NaoPross/SAMSpectrumAnalyzer/doc/tex/hardware.tex

\chapter{Hardware}
\section{Schema a blocchi}

\begin{figure}[H] \centering \rmfamily
    
    \caption{Schema a blocchi}
\end{figure}

\section{Selezione delle entrate}
Essendo richiesta dai requisiti la possibilit\`a di selezione tra 3 entrate,
\`e stato utilizzando un semplice multiplexer controllato direttamente dal
microcontroller. Per la sua semplicit\`a non sono necessari particolari
osservazioni.

\begin{figure}[H] \centering
    
    \caption{Circuito di selezione delle entrate \label{fig:input-selection-v2}}
\end{figure}

Tutte le entrate dispongono di un condensatore di disaccoppiamento, seguito da
un partitore di tensione simmetrico per aggiungere un offset pari a met\`a
dell'alimentazione. Il valore delle resistenze di 20\,k\(\Omega\) \`e scelto
per avere un impedenza rispetto al connettore uguale all'impedenza
caratteristica dei cavi audio di 10\,k\(\Omega\).

\section{Circuito di entrata}
Il segnale di cui si analizza lo spettro, prima di essere campionato, viene
adattato mediate un circuito di amplificazione e filtraggio. Esso \`e
necessario per due ragioni. Il circuito di amplificazione \`e presente per
poter regolare il guadagno nel caso in cui si dovesse avere in entrata un
segnale di ampiezza molto piccola. Il secondo circuito invece, di filtraggio,
\`e necessario per rimuovere disturbi di alta frequenza che potrebbero
introdurre disturbi nel campionamento. Questa \`e una tipica configurazione
prima di un circuito di conversione AD (analogico - digitale), ed \`e
conosciuto anche come circuito di filtraggio \emph{anti-alias}.

\begin{figure}[H] \centering
    
    \caption[Circuito di adattamento del segnale]{
        Circuito di adattamento del segnale in entrata.
        \label{fig:filter-ampl-v2}
    }
\end{figure}

\`E importante notare che per questa applicazione si \`e scelto utilizzare
degli opamp \emph{rail to rail}, che hanno una tensione di saturazione vicina
a quella di alimentazione. Essi sono necessari per poter raggiungere tensioni
vicino allo 0\,V, che non sarebbero possibili con un opamp normale siccome
l'alimentazione del circuito \`e asimmetrica tra 0 e 12\,V.

\paragraph{Amplificatore.} Come si pu\`o notare a sinistra nella figura
\ref{fig:filter-ampl-v1}, il circuito di amplificazione non ha una configurazione
tipica. Esso \`e basato su una configurazione non invertente ma dispone di un
consensatore (C11) che modifica la retroazione in modo da reagire unicamente
alla componente AC del segnale. Questo permette di amplificare la componente
alternata ignorando l'offset del segnale, perci\`o di \emph{non} utilizzare
un'alimentazione simmetrica \(\pm\)5\,V.

L'amplificazione di questo amplificatore \`e comunque data dal rapporto
\(1+R_{14}/R_{13}\) che permette un un guadagno fino a 6 oppure 15,5\,dB.

\paragraph{Filtro.} A destra della figura \ref{fig:filter-ampl-v1} vi \`e il
circuito di filtraggio, realizzato utilizzando un tipico filtro passa basso
attivo di primo ordine. Esso \`e dimensionato con una frequenza di taglio di
10\,kHz poich\`e quest'ultimo \`e il limite di Nyquist, conosciuto anche dal
teorema di Shannon, il quale stata che la frequenza di campionamento deve
essere almeno doppia della frequenza dell'armonica di frequenza maggiore.

\section{Microcontroller}
Per questa applicazione \`e stato deciso di utilizzare il microcontroller a 8
bit di Microchip PIC18F45K22, principalmente per la sua frequenza di lavoro.
Questo PIC senza oscillatori esterni dispone di un clock a 16\,MHz che grazie
ad un PLL interno pu\`o essere aumentato fino a ad un massimo di 64\,MHz.

Inoltre questo microcontroller dispone di un moltiplicatore hardware 8x8 che
impiega un solo ciclo, risparmiando la difficolt\`a di dover ottimizzare le
computazioni della Fast Fourier Tranform.

Un ultima ragione importante per la scelta di questo componente \`e data dalla
disponibilit\`a di una libreria per controllare il la matrice LED, utilizzata
per la visualizzazione, adattata da Arduino da P. Randjelovic in un LPI
precedente.

In allegato \`e presente una pagina riassuntiva dal datasheet.

\begin{table}[H] \centering
    \caption{Sommario della configurazione utilizzata}
    \begin{tabularx}{\textwidth}{l l X}
        \toprule
        \bfseries Componente utilizzato & \bfseries Valore & \bfseries Osservazioni \\
        \midrule
        Oscillatore Interno & 16\,MHz & 
            Questa \emph{non} \`e la frequenza di lavoro \\
        %
        PLL & \(\times\)4 & 
            La frequenza di lavoro \`e di 16\(\times\)4\,MHz = 64\,MHz \\
        %
        ADC & \ttfamily ANSA0 &
            Utilizzato per il campionamento \\
        %
        I/O ports & \ttfamily A, B, C, D & \\
        %
        Timer 2 & Vedi \S\ref{sec:sampling} & Utilizzato per il campionamento \\
        %
        I/O interrupts & \ttfamily INT0 (RB0) &
            Utilizzato per la selezione del canale \\
        %
        EUSART 1 & & 
            Utilizzato per trasferire i campioni della FFT. \\
        %
        EUSART 2 & &
            Porta di debugging \\
        \bottomrule
    \end{tabularx}
\end{table}

\begin{table}[H] \centering
    \caption{Configurazione della porta seriale}
    \begin{tabular}{l r l}
        \toprule
        Baudrate & 57.6 & kbps \\
        Data size & 8 & bits \\
        Stop bits & 1 & -- \\
        Flow control & off & -- \\
        \bottomrule
    \end{tabular}
\end{table}

% \section{Visualizzazione}

\section{Schemi originali}
Dopo la realizzazione del primo prototipo, gli schemi sono stati revisionati,
apportando delle correzioni. In questa sezione sono presenti gli schemi
originali utilizzati per produrre il (primo) prototipo.
\begin{figure}[H] \centering
    
    \caption{
        Circuito di selezione delle entrate (prima versione)
        \label{fig:input-selection-v1}
    }
\end{figure}
% Il filtro essendo non invertente ha un rapporto di amplificazione dato
% da \(1+R_{12}/R_{11}\). Nella figura \ref{fig:filter-ampl-v1} il valore della
% resistenza \(R_{11}\) \`e \textbf{incorretto} (Vedi sezione
% \ref{sec:err-filter}). Dopo la correzzione (\(R_{11} \geq
% 750\,\textrm{k}\Omega\)) il filtro ha un amplificazione approssimativamente
% unitaria (\(\approx 1.02\)).
\begin{figure}[H] \centering
    
    \caption[Circuito di adattamento del segnale]{
        Circuito di adattamento del segnale in entrata (prima versione)
        \label{fig:filter-ampl-v1}
    }
\end{figure}
