NaoPross/SAMSpectrumAnalyzer/doc/spectrum-analyzer.pdf

# Anno scolastico 2017-18 Lavoro Professionale Individuale

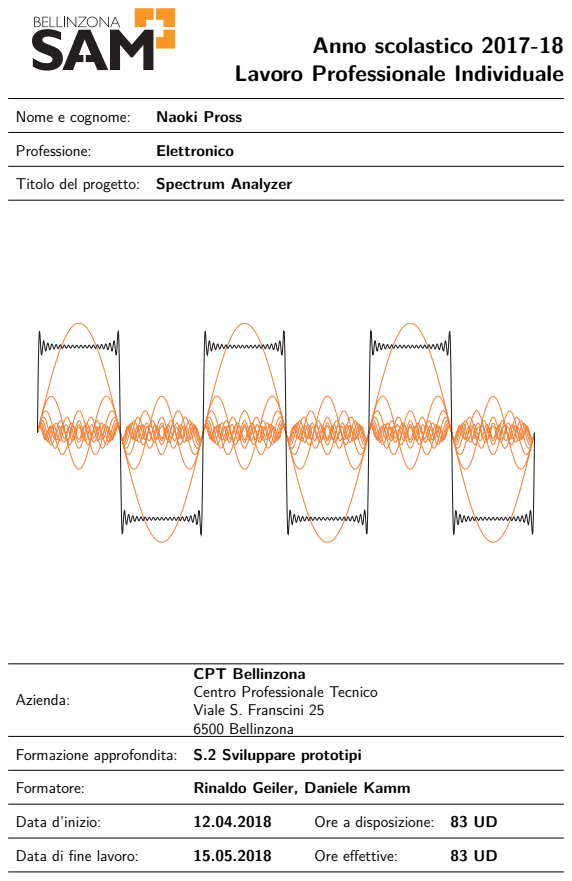
[picture p5: page 1]
Nome e cognome:; Naoki Pross; Professione:; Elettronico; Azienda:; Formatore:; Rinaldo Geiler, Daniele Kamm; Data d’inizio:; Ore a disposizione: 83 UD; Data di fine lavoro:; Ore effettive:

Titolo del progetto: Spectrum Analyzer

CPT Bellinzona
Centro Professionale Tecnico
Viale S. Franscini 25
6500 Bellinzona

Formazione approfondita: S.2 Sviluppare prototipi

Abstract

Per completare un percorso formativo alla SAM è richiesto lo sviluppo di un progetto. Questa documentazione descrive e documenta lo sviluppo di un prototipo di un circuito di analisi spettrale a 3 entrate: 2 jack ed un Cinc/RCA, in grado di offrire uno spettro fino a 10 kHz. Realizzato intorno ad un PIC18F45K22 con l’utilizzo dell’algoritmo della Fast Fourier Transform (FFT), è possibile osservare i valori complessi dello spettro mediante la porta seriale RS232 oppure utilizzando il software sviluppato in C++ per Windows e Linux (probabilmente è possibile compilarlo anche sotto MacOS).
Il progetto si è concluso con lo sviluppo di un primo design per un PCB, funzionante, ed uno schema elettrico revisionato.

CAM-SAM | Elettronico | 28 maggio 2018

# Indice

1 Introduzione | 3
2 Hardware | 5
3 Software | 9
4 Conclusioni | 15
5 Trasformata di Fourier | 19
spectrum-analyzer.tex | Naoki Pross | 1

Allegati | 29
spectrum-analyzer.tex | Naoki Pross | 2

# 1 Introduzione

## 1.1 Contesto

Per portare a termine il percorso formativo per un attestato di capacità federale presso la Scuola Arti e Mestieri di Bellinzona è richiesto lo sviluppo individuale di un progetto di produzione di un prodotto. Per interesse personale nella matematica della trasformata di Fourier mi è stato assegnato di sviluppare un analizzatore spettrale.

## 1.2 Requisiti

È richiesto di sviluppare circuito per analizzare lo spettro dei segnali di frequenza fino a 10 kHz. Il dispositivo dovrà avere 3 possibili sorgenti: RCA/Cinch e 2 Audio Jack per un microfono e per una sorgente di audio generica. È inoltre richiesto che il calcolo dei dati dello spettrogramma sia eseguito da un microcontroller della Microchip, collegato a due altri dispositivi quali, un display e ad un computer in RS232, per poter visualizzare lo spettrogramma computato.

## 1.3 Concetti matematici

Il circuito realizzato si appoggia sul concetto matematico di importanza fondamentale, nelle discipline come la fisica e l’elettrotecnica della Trasformata di Fourier. Questa operazione matematica è fondata su un principio dimostrato da Joseph Fourier che asserisce che è possibile rappresentare una qualsiasi funzione periodica, in alcuni casi anche non periodica, con una serie di sinusoidi di frequenze multiple ad una di base. L’operazione di Trasformata dunque è uno strumento per osservare le frequenze di queste armoniche, esso trasforma una funzione in funzione del tempo f(t) in una funzione rispetto alla frequenza o alla pulsazione ˆf(ω), che restituisce ad ogni ω l’ampiezza e la fase dell’armonica.

Secondariamente, il progetto usufruisce anche di un altro strumento chiamato Fast Fourier Transform (FFT) scoperto inizialmente nel 1965 dai matematici J. Cooley e J. Tukey. La FFT è un algoritmo con molte implementazioni che riduce la complessità computazionale della trasformata di fourier discreta da O(n

2
) a O(n log n). Questo è necessario perché le operazioni matematiche da eseguire sono dei prodotti tra numeri complessi, i quali impiegano molto tempo per essere computati.
Tutti i concetti descritti saranno approfonditi nei capitoli seguenti.
spectrum-analyzer.tex | Naoki Pross | 3

## 1.4 Norme di progetto

Tabella 1.1: Norme di progetto: Software

Componente | Software
Version control | Git
Documentazione | LATEX
Diario di lavoro | LATEX
Pianificazione | MS Excel 2016
LATEX engine | XƎLATEX
ECAD | Altium Designer 2017
Embedded toolchain | Microchip XC, MPLabX
Desktop Toolchain | QtCreator, g++, MinGW

Per i valori non specificati sono utilizzati i predefiniti del software ECAD.

Tabella 1.2: Norme di progetto: Hardware

Regola | Valore Unità
Number of Layers | 2 –
Silkscreen / Overlay | No | –
Minimum trace width | 30 mil
Maximum trace width | 60 mil
Minimum trace clearance | 20 mil
Minimum power rail width | 50 mil
Minimum pad diameter | 80 mil
Minimum pad hole diameter | 25 mil

Tabella 1.3: Norme di progetto: Programmazione

Regole per programmazione embedded
Paradigma | Imperativo sequenziale
Convenzione per i nomi | snake_case, sempre minuscolo
Tabulatore | 4 spazi
Tabulato con gli spazi | Sì
Regole per programmazione desktop
Paradigma | Imperativo ad oggetti (OOP)
Convenzione per i nomi | Convenzioni di Qt
Tabulatore | 4 spazi
Tabulato con gli spazi | Sì
spectrum-analyzer.tex | Naoki Pross | 4

# 2 Hardware

## 2.1 Schema a blocchi

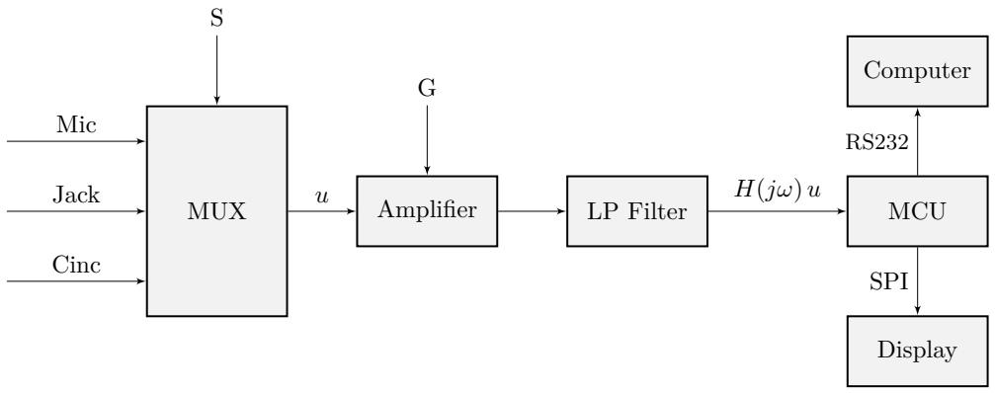
[picture p6: figure]
MUX; Amplifier; LP Filter; MCU; Display; Computer; Mic; Jack; Cinc; SPI

Figura 2.1: Schema a blocchi

## 2.2 Selezione delle entrate

Essendo richiesta dai requisiti la possibilità di selezione tra 3 entrate, è stato utilizzando un semplice multiplexer controllato direttamente dal microcontroller. Per la sua semplicità non sono necessari

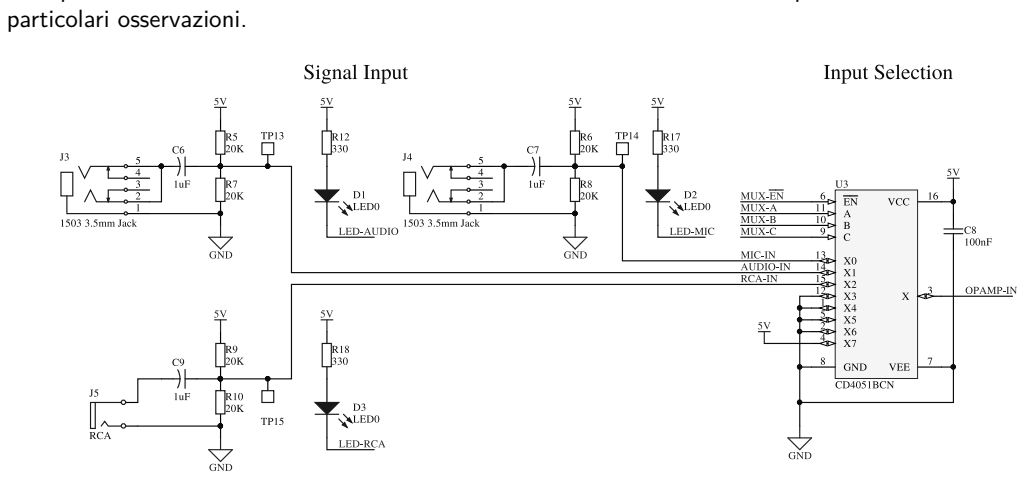
[picture p7: figure]
particolari osservazioni.

Figura 2.2: Circuito di selezione delle entrate

Tutte le entrate dispongono di un condensatore di disaccoppiamento, seguito da un partitore di tensione simmetrico per aggiungere un offset pari a metà dell’alimentazione. Il valore delle resistenze di 20 kΩ è scelto per avere un impedenza rispetto al connettore uguale all’impedenza caratteristica dei cavi audio di 10 kΩ.

spectrum-analyzer.tex | Naoki Pross | 5

## 2.3 Circuito di entrata

Il segnale di cui si analizza lo spettro, prima di essere campionato, viene adattato mediate un circuito di amplificazione e filtraggio. Esso è necessario per due ragioni. Il circuito di amplificazione è presente per poter regolare il guadagno nel caso in cui si dovesse avere in entrata un segnale di ampiezza molto piccola. Il secondo circuito invece, di filtraggio, è necessario per rimuovere disturbi di alta frequenza che potrebbero introdurre disturbi nel campionamento. Questa è una tipica configurazione prima di un circuito di conversione AD (analogico - digitale), ed è conosciuto anche come circuito di filtraggio

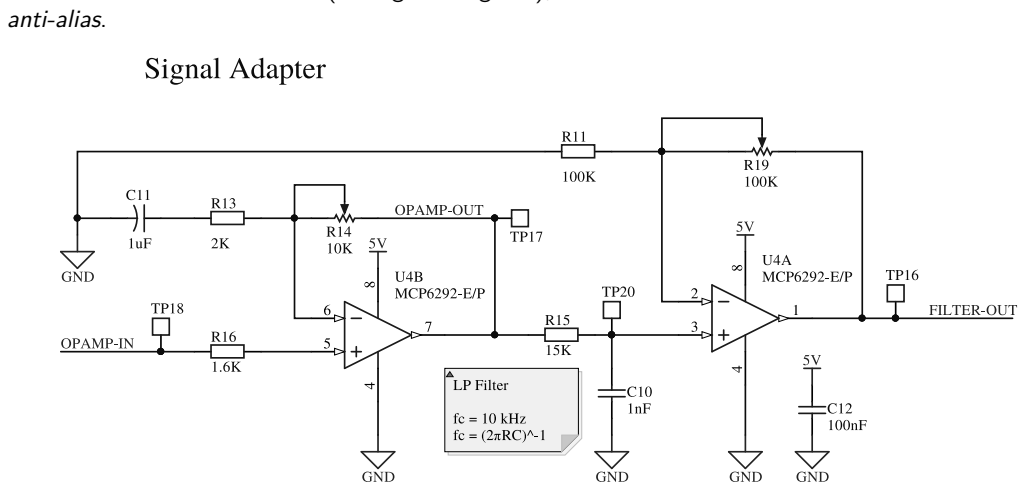
[picture p8: figure]
anti-alias.

Figura 2.3: Circuito di adattamento del segnale in entrata.

È importante notare che per questa applicazione si è scelto utilizzare degli opamp rail to rail, che hanno una tensione di saturazione vicina a quella di alimentazione. Essi sono necessari per poter raggiungere tensioni vicino allo 0 V, che non sarebbero possibili con un opamp normale siccome l’alimentazione del circuito è asimmetrica tra 0 e 12 V.

Amplificatore. Come si può notare a sinistra nella figura 2.5, il circuito di amplificazione non ha una configurazione tipica. Esso è basato su una configurazione non invertente ma dispone di un consensatore (C11) che modifica la retroazione in modo da reagire unicamente alla componente AC del segnale. Questo permette di amplificare la componente alternata ignorando l’offset del segnale, perciò di non utilizzare un’alimentazione simmetrica ±5 V.
L’amplificazione di questo amplificatore è comunque data dal rapporto 1 + R14/R13 che permette un un guadagno fino a 6 oppure 15,5 dB.

Filtro. A destra della figura 2.5 vi è il circuito di filtraggio, realizzato utilizzando un tipico filtro passa basso attivo di primo ordine. Esso è dimensionato con una frequenza di taglio di 10 kHz poichè quest’ultimo è il limite di Nyquist, conosciuto anche dal teorema di Shannon, il quale stata che la frequenza di campionamento deve essere almeno doppia della frequenza dell’armonica di frequenza maggiore.

## 2.4 Microcontroller

Per questa applicazione è stato deciso di utilizzare il microcontroller a 8 bit di Microchip PIC18F45K22, principalmente per la sua frequenza di lavoro. Questo PIC senza oscillatori esterni dispone di un clock

spectrum-analyzer.tex | Naoki Pross | 6

a 16 MHz che grazie ad un PLL interno può essere aumentato fino a ad un massimo di 64 MHz. Inoltre questo microcontroller dispone di un moltiplicatore hardware 8x8 che impiega un solo ciclo, risparmiando la difficoltà di dover ottimizzare le computazioni della Fast Fourier Tranform.
Un ultima ragione importante per la scelta di questo componente è data dalla disponibilità di una libreria per controllare il la matrice LED, utilizzata per la visualizzazione, adattata da Arduino da P. Randjelovic in un LPI precedente.
In allegato è presente una pagina riassuntiva dal datasheet.

Tabella 2.1: Sommario della configurazione utilizzata

Componente utilizzato | Valore | Osservazioni
Oscillatore Interno | 16 MHz | Questa non è la frequenza di lavoro
PLL | ×4 | La frequenza di lavoro è di 16×4 MHz = 64 MHz
ADC | ANSA0 | Utilizzato per il campionamento
I/O ports | A, B, C, D
Timer 2 | Vedi §3.1 | Utilizzato per il campionamento
I/O interrupts | INT0 (RB0) | Utilizzato per la selezione del canale
EUSART 1 | | Utilizzato per trasferire i campioni della FFT.
EUSART 2 | | Porta di debugging

Tabella 2.2: Configurazione della porta seriale

Baudrate | 57.6 | kbps
Data size | 8 bits
Stop bits | 1 –
Flow control | off –

## 2.5 Schemi originali

Dopo la realizzazione del primo prototipo, gli schemi sono stati revisionati, apportando delle correzioni. In questa sezione sono presenti gli schemi originali utilizzati per produrre il (primo) prototipo.

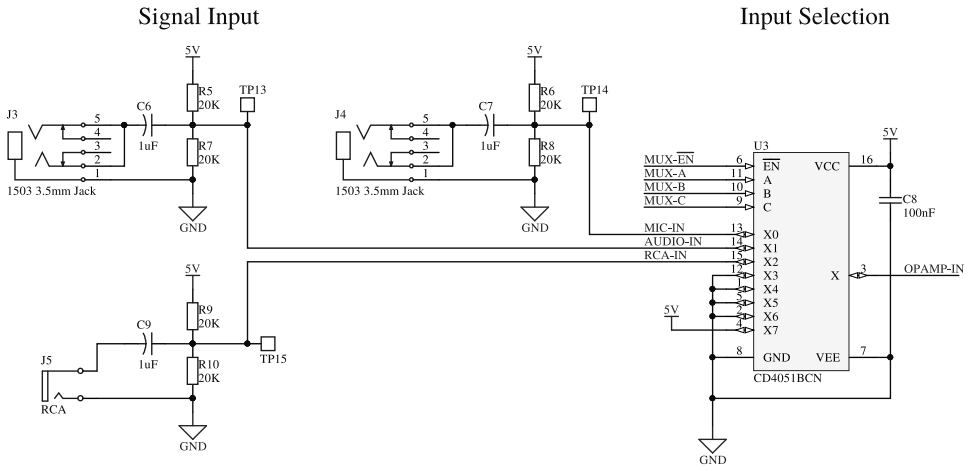
[picture p9: figure]

Figura 2.4: Circuito di selezione delle entrate (prima versione)

spectrum-analyzer.tex | Naoki Pross | 7

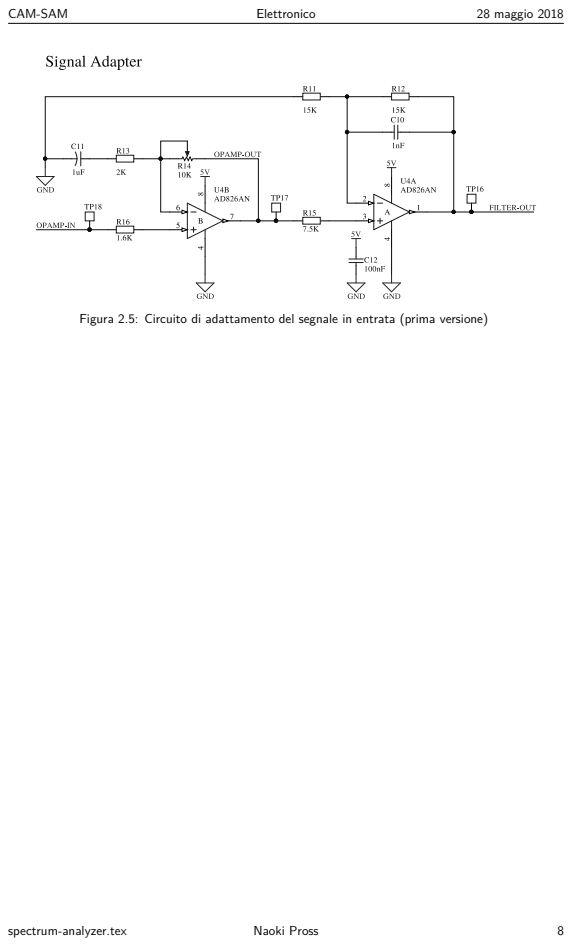
[picture p10: page 10]
spectrum-analyzer.tex; Naoki Pross

Figura 2.5: Circuito di adattamento del segnale in entrata (prima versione)

# 3 Software

## 3.1 Campionamento

Per campionare il segnale è stato scelto di utilizzare il TIMER2, sia per la sua semplicità che per la granulatià offerta dal registro di comparazione. Il campionamento è eseguito ad una frequenza di 20 kHz, poco sotto al valore massimo possibile che si può ottenere considerando il tempo di conversione

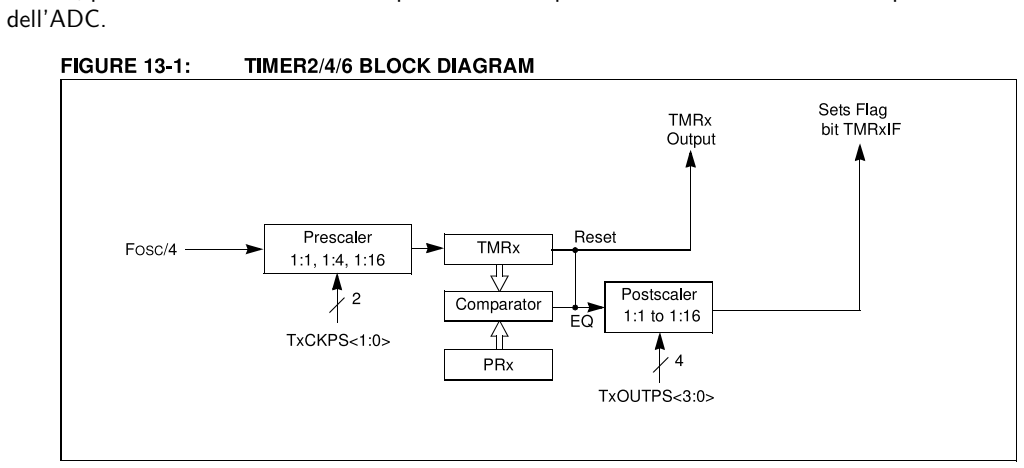
[picture p11: figure]
dell’ADC.

Figura 3.1: Schema a blocchi del TIMER2. Fonte: Microchip PIC18F2X/4XK22 datasheet

Dallo schema a blocchi nella figura 3.1, si può osservare che la frequenza degli interrupt, ossia di campionamento, è data dalla seguente relazione.

f =

Fosc
4

·

1
prescaler ·

1
comparator

·

1
postscaler

Per il questo progetto il PIC18F45K22 è configurato con un postscaler 1:1 ed un prescaler 1:16, per far corrispondere un unità del comparatore ad 1 microsecondo. Perciò il comparatore è impostato a 50, poichè 1/50 µs = 20 kHz.

f =

64 MHz
4

·

1
1

·

1
comparator

·

1
16

=

1 MHz
comparator

=

1 MHz
50

= 20 kHz

In allegato la figura 6.1 mostra il diagramma di flusso del programma.

## 3.2 Trasferimento dei dati

Per trasferire i dati campionati era inizialmente stato scelto di utilizzare una struttura dati binaria. In seguito però si è deciso di utilizzare un formato interamente ASCII per semplificare il debugging.

S\n\r | a0 | i | b0 | \n\r | a1 | i | ... | E\n\r

Figura 3.2: Protocollo di trasmissione dei dati, il primo dato mandato è a0 + ib0

I dati sono trasferiti con un semplice protocollo illustrato nella figura 3.2. Un frame di dati incomincia con il carattere ASCII maiuscolo ‘S’ seguito da un line break (\n\r). Ogni riga seguente è un numero

spectrum-analyzer.tex | Naoki Pross | 9

complesso a 4 cifre con il carattere ‘i’ come separatore tra la parte immaginaria e complessa (Es: 0140i0670\n\r). Il frame termina con il carattere ASCII maiuscolo ‘E’ seguito da un line break.
La trasmissione di basso livello è gestita dalla porta EUSART del microcontroller, impostato per funzionare in modalità asincrona con i dati da 8 bit, 1 stop bit ad una velocità di 57600 bps.

## 3.3 Interfaccia al Computer

Per preferenze principalmente personali è stato scelto di realizzare l’interfaccia al computer utilizzando il moderno linguaggio di programmazione C++ (versione ≥ 11) utilizzando un framework (Qt) che sarà descritto successivamente. I vantaggi dati dall’utilizzo del C++ anzichè linguaggi interpretati come il Python, linguaggi compilati in bytecode come Java, o con runtime particolari come LabView / CVI sono molteplici. Innanzitutto tutti gli strumenti necessari per lo sviluppo hanno mezzi o varianti open source / libre, di conseguenza gratuiti e in molti casi multipiattaforma. Al contrario invece dei sistemi proprietari come quelli offerti da National Instruments che sono estremamente costosi e possono essere utilizzati unicamente sulle piattaforme con un supporto ufficiale. Tra i vari linguaggi di programmazione non proprietari il C++ è comunque in posizione di vantaggio siccome è tra i più performanti in quanto non richiede alcun interpreter (bytecode o non) o nessuna runtime, stando quindi alla pari con il linguaggio C guadagnando però i vantaggi dell’astrazione data dalla programmazione ad oggetti.

### 3.3.1 Librerie e codice di terzi

Per ridurre i tempi dedicati alla realizzazione del programma, seppur mantenendo una buona qualità, è stato scelto di utilizzare le seguenti librerie.

- Serial (http://wjwwood.io/serial/): Utilizzata come interfaccia multipiattaforma per l’accesso di basso livello alla porta seriale del sistema operativo sottostatante. Descrizione dal sito:

This is a cross-platform library for interfacing with rs-232 serial like ports written in
C++. It provides a modern C++ interface with a workflow designed to look and feel like PySerial, but with the speed and control provided by C++.
- QCustomPlot (http://qcustomplot.com): Utilizzata per produrre il grafico all’interno del software, per visualizzare i dati dal microcontroller. Descrizione dal sito:

QCustomPlot is a Qt C++ widget for plotting and data visualization. It has no further dependencies and is well documented. This plotting library focuses on making good looking, publication quality 2D plots, graphs and charts, as well as offering high performance for realtime visualization applications.

### 3.3.2 Qt Framework

La dipendenza principale utilizzata per realizzare la grafica è il framework di Qt. Inoltre Qt è un’azienda indipendente che vende un supporto commerciale per lo sviluppo di applicazioni su praticamente ogni piattaforma. Qt è un framework grafico maturo che esiste oramai da 22 anni ed è disponibile sia con una licenza commerciale che con le licenze open source LGPL e GPL.
La toolchain di Qt aggiunge al normale sviluppo un preprocessore speciale chiamato MOC che genera in automatico il codice dalle strutture grafiche realizzate con QtDesigner. Il resto della toolchain è composta da componenti tipici che possono essere intercambiati liberamente poichè Qt supporta gcc/g++, clang, MSVC e MinGW. Per compilare il codice è dunque necessario un compiler qualsiasi di C++ e l’IDE QtCreator, oppure qmake. Questi ultimi due pacchetti offrono il preprocessore MOC. Per progetti open source entrambi sono offerti gratuitamente dal sito ufficiale www.qt.io.
spectrum-analyzer.tex | Naoki Pross | 10

### 3.3.3 Compilazione sotto Linux

Il programma è stato realizzato in parte sotto Debian 9.4 Stretch ed in parte sotto Fedora 27. Per entrambi i sistemi sono necessarie le dipendenze per lo sviluppo di Qt5.
Una volta installate le dipendenze dalla cartella di progetto è possibile utilizzare il makefile per compilare le dipendenze e il codice.
$ make build-deps | # dependencies
$ make | # spectrum analyzer code

Purtroppo la libreria QCustomPlot utilizza un sistema di build molto particolare che richiede molte dipendenze. Perciò in alcuni casi è preferibile scaricare dal seguente link l’ultima versione dei due files qcustomplot.cpp e qcustomplot.hpp ed immetterli manualmente nella cartella lib/qcustomplot/.

| http://qcustomplot.com/index.php/download

Ed infine si compila con

$ make serial | # build only Serial library dep
$ make | # build spectrum analyzer code

### 3.3.4 Compilazione manuale sotto Linux

Per compilare manualmente il progetto sono necessari pochi passaggi grazie a qmake. Come per il caso precedente la libreria QCustomPlot può essere scaricata dal sito.

1. Scaricare le dipendenze.

$ git submodule init
$ git submodule update
2. Compilare la libreria Serial

$ mkdir -p lib/build-serial
$ qmake -makefile -o Makefile -Wall "CONFIG+=releae" \ -o lib/build-serial/ lib/serial

$ make -C lib/build-serial/

3. Compilare la libreria QCustomPlot

$ cd lib/qcustomplot/src
$ sed -i -e 's/qmake474/qmake/' release.py $ ./release.py
$ cd ../.. # go back to project root dir
4. Compilare il progetto

$ mkdir -p build-deskop
$ qmake -makefile -o Makefile -Wall "CONFIG+=release" \ -o build-desktop/ src-desktop

$ make -C build-desktop

spectrum-analyzer.tex | Naoki Pross | 11

### 3.3.5 Compilazione sotto Windows

Per compilare il progetto in Windows è necessario installare QtCreator dal sito ufficiale www.qt.io.

1. Installare QtCreator, Qt ≥ 5.0 (consigliato 5.10.0)
2. Installare MinGW oppure MSVC + Visual Studio (consigliato MinGW)
3. Inizializzare ed aggiornare i submoduli di Git oppure clonare recursivamente il progetto.
4. Scaricare dal sito http://qcustomplot.com/index.php/download i documenti qcustomplot.cpp qcustomplot.hpp della libreria QCustomPlots ed immetterli nella cartella lib/qcustomplots/
5. Aprire il progetto lib/serial/serial.pro ed impostare la build directory sia per release che per debug in lib/build-serial.
6. Compilare la libreria Serial come release.
7. Aprire il progetto src-desktop/SpectrumAnalyzer.pro ed impostare la cartella di build sia per release che debug nella cartella build-desktop/
8. Compilare il progetto SpectrumAnalyzer come release
9. Controllare che lo script deploy-desktop.cmd abbia le variabili QT_PATH e QT_VERSION che corrispondano con la vostra l’installazione.
10. Eseguire lo script deploy-desktop.cmd.

Nella cartella build-desktop sarà pronto l’eseguibile con tutte le librerie dinamiche (DLL) necessarie.

### 3.3.6 Architettura

Il programma desktop è programmato per reagire ad eventi asincroni dati dalla porta seriale del sistema operativo e dalle interazioni dell’utente. La gestione degli eventi grafici è affidata interamente a Qt, perciò sono stati scritti solamente i metodi che vengono attivati in funzione degli eventi dall’utente. Per la porta seriale invece il compito della gestione è stato delegato ad una classe SerialWorker che ha un rapporto di composizione con la classe MainWindow in quanto essa esiste unicamente quando esiste MainWindow. Nella figura 3.3 è mostrato un diagramma delle sequenze che mostra il flusso dei dati attraverso le componenti del programma.
Per l’implementazione nella figura 3.4 è possibile osservare il diagramma UML delle classi. È importante notare che Qt introduce dei nuovi tipi di membri chiamati slots e signals. Gli slots sono dei normali metodi che rispondo ai signals. I signals invece sono delle funzioni prive di implementazione che possono essere emesse.
Quando viene realizzato un modello ad oggetti in Qt è possibile collegare degli slots a dei segnali per poter gestire delle azioni asincrone. Nel progetto dello SpectrumAnalyzer il segnale receivedData della classe SerialWorker viene messo quando sono stati ricevuti dei dati validi dalla seriale. Il segnale ha come argomento un vettore di numeri complessi interi.
Nella classe MainWindow il segnale di receivedData è associato allo slot serialDataReceiver con argomento uguale al segnale, dunque un vettore di numeri complessi interi, che processa i dati e li mostra nell’interfaccia utente.
spectrum-analyzer.tex | Naoki Pross | 12

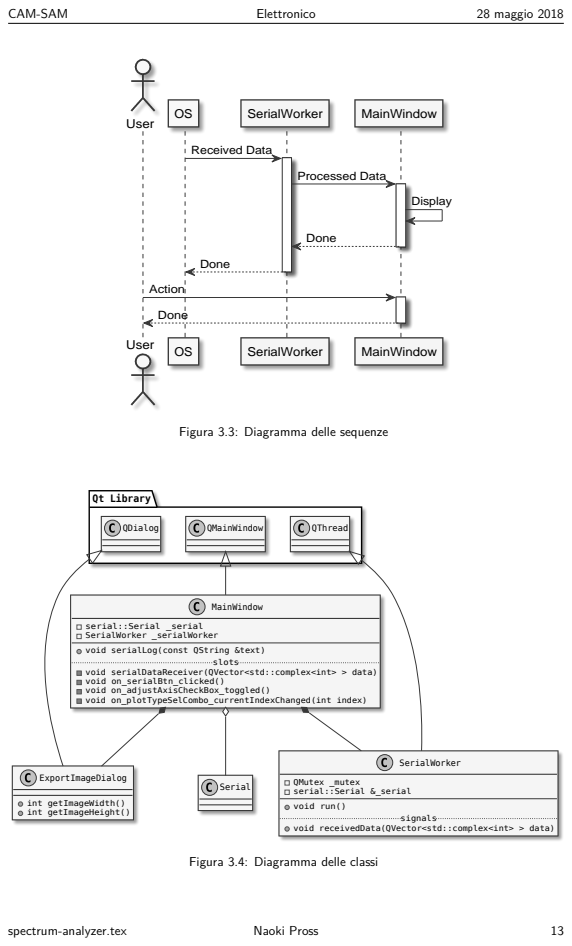
[picture p12: page 15]
User; SerialWorker; MainWindow; Received Data; Processed Data; Display; Done; Action; Qt Library; QDialog; QMainWindow; QThread; slots; ExportImageDialog; int getImageWidth() int getImageHeight(); QMutex _mutex serial::Serial &_serial void run(); signals; Serial; spectrum-analyzer.tex; Naoki Pross

Figura 3.3: Diagramma delle sequenze

serial::Serial _serial
SerialWorker _serialWorker
void serialLog(const QString &text)

void serialDataReceiver(QVector<std::complex<int> > data)
void on_serialBtn_clicked()
void on_adjustAxisCheckBox_toggled()
void on_plotTypeSelCombo_currentIndexChanged(int index)

void receivedData(QVector<std::complex<int> > data)

Figura 3.4: Diagramma delle classi

### 3.3.7 Interfaccia utente

L’interfaccia utente, realizzata con Qt è molto semplice e non dovrebbe richiedere delle istruzioni d’utilizzo. Dal software è possibile esportare i dati sia in formato CSV sia in un immagine del grafico in formato vettoriale o bitmap / compresso (png, jpg).

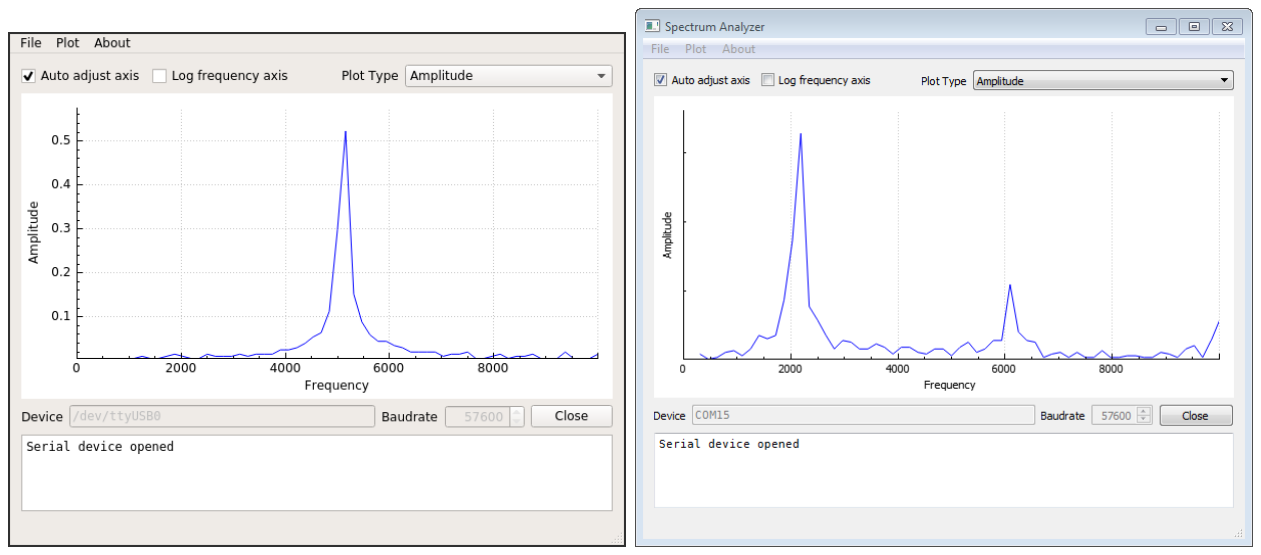
[picture p13: figure]

Figura 3.5: L’applicativo sotto Fedora 27 (sinistra) e Windows 7 (destra)

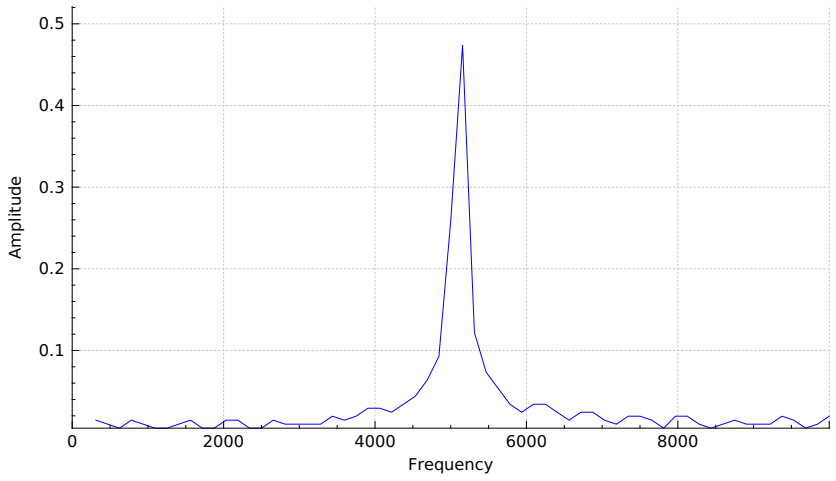
[picture p14: figure]
Frequency; plitu

Figura 3.6: Esempio di immagine esportata dal software

## 3.4 Fast Fourier Transform

Il codice della FFT è stato preso dal dominio pubblico. Originalmente scritto da Tom Roberts (8.11.1989), successivamente adattato da Malcom Stanley (15.12.1994), Dimitrios P. Buras (14.6.2006) ed infine da Simon Inns (4.1.2011) [1] non ha praticamente necessitato modifiche. L’algoritmo implementato è chiamato “Fixed-Point in-place Fast Fourier”

spectrum-analyzer.tex | Naoki Pross | 14

# 4 Conclusioni

## 4.1 Risultati

Il circuito stampato realizzato è funzionante, come il prototipo iniziale su piastra sperimentale, malgrado gli errori rilevati durante la messa in servizio. È stato possibile correggere tutti gli sbagli entro i tempi di consegna.

### 4.1.1 Esempi di misurazioni

I dati illustrati nella figura 4.1 sono esportati dal programma desktop. Lo spettrogramma, malgrado i limiti del campionamento, è sufficientemente preciso per applicazioni in cui è necessaria solamente una

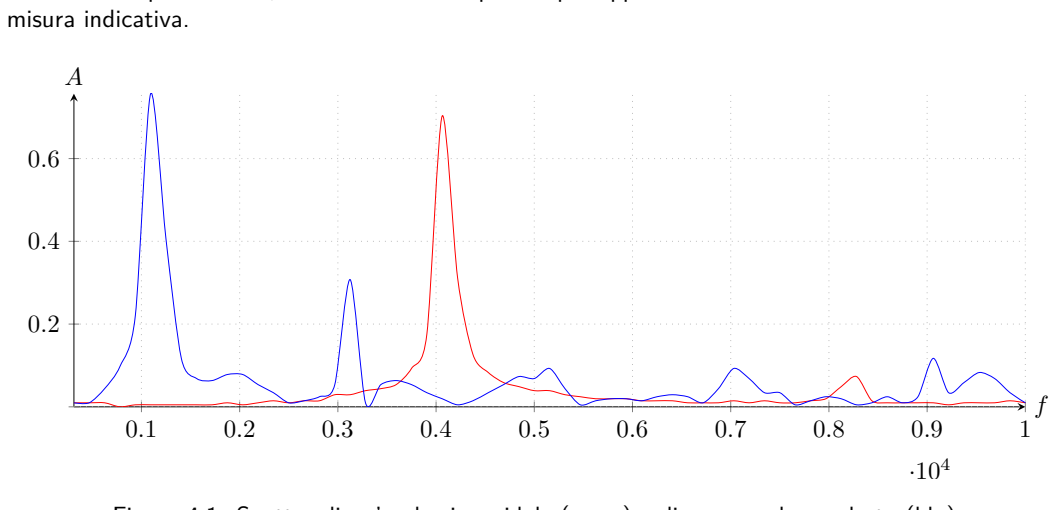
[picture p15: figure]
misura indicativa.

Figura 4.1: Spettro di un’onda sinusoidale (rosso) e di un segnale quadrato (blu)

## 4.2 Problemi riscontrati

### 4.2.1 Errore nella scelta dell’opamp

Durante la fase di test, dopo l’assemblaggio, si è notato che l’amplificatore operazionale AD826 non è rail to rail come l’AD820 utilizzato durante la fase di sviluppo su piastra sperimentale. Ciò limita l’escursione del segnale amplificato di quasi 1 V, riducendo la precisione del campionamento. Fortunatamente il footprint DIP8 degli operazionali dual package è standard, perciò non vi sono eccessive difficoltà nella sostituzione del componente. Purtroppo però non sarà possibile acquistare in tempo un opamp sostitutivo. Un possibile sostituto, utilizzato nella seconda revisione dello schema, potrebbe essere l’operazionale MCP6292 (in alternativa: MCP6002, TI OPA2340, ICL7621DCPAZ).

### 4.2.2 Errore nel dimensionamento del filtro attivo

Durante la fase di test è stato inoltre rilevato che il filtro attivo (vedi figura 2.5) di anti-alias aveva un amplificazione non unitaria, dunque incorretta. La tensione di offset di 2.5 V veniva amplificata ed in molti punti l’operazionale entrava in saturazione. Ciò era causato dal valore incorretto di R11 poichè

spectrum-analyzer.tex | Naoki Pross | 15

l’amplificazione, data dalla relazione sottostante, era di 2.

Av = 1 + R12/R11 = 1 + 15 kΩ/15 kΩ = 2

Un valore sostitutivo per il resistore R11 è ≥ 750 kΩ, in modo da ottenere un amplificazione quasi unitaria, con un errore di +0.02, che corrisponde ad un incremento di 50 mV della tensione di offset di 2.5 V. Valori di ordini di grandezza maggiori sono preferibili, infatti dopo aver rilevato il guasto a R11 è stato assegnato un valore di 910 kΩ.

Av = 1 + R12/R11 = 1 + 15 kΩ/910 kΩ ≈ 1.016

Così facendo però è stata modificata la frequenza di taglio del filtro. Perciò si è concluso che il circuito scelto non è utilizzabile e nella seconda revisione la configurazione è stata sostituita da una cella RC con un amplificatore non invertente.

### 4.2.3 Sincronizzazione dei threads

Durante lo sviluppo del software desktop è stato riscontrato un unico problema riguardante la sincronizzazione dei threads. La risorsa serial::Serial MainWindow::_serial come implica il nome è istanziata nella classe MainWindow, ma essa è gestita anche dalla classe SerialWorker siccome è suo compito leggere i dati.
Perciò la risorsa deve essere protetta da un QMutex e la sua lifetime (ciclo di vita) deve essere gestita tenendo in considerazione il thread parallelo. Il bug era causato da una chiusura della risorsa seriale mentre il thread era ancora attivo. Chiudendo la risorsa mentre il thread del SerialWorker è attivo, al tentativo di lettura seguente il metodo serial::Serial::read() causa una serial::IOException che termina il programma.
La ragione per cui il thread non veniva fermato, era l’utilizzo incorretto dell’API dei QThread. Per chiudere correttamente un thread secondo il framework di Qt si richiede un interruzione con QThread::requestInterruption(). Invece nel codice veniva utilizzato QThread::quit(), che se non in condizioni particolari non chiude il processo parallelo.
Il diff sottostante mostra il commit in cui il problema viene risolto.

1 diff --git a/src-desktop/mainwindow.cpp b/src-desktop/mainwindow.cpp 2 index 73c416e..15c7d77 100644
3 --- a/src-desktop/mainwindow.cpp
4 +++ b/src-desktop/mainwindow.cpp
5 @@ -42,8 +42,12 @@ void MainWindow::serialDataReceiver(const QString &data)
6 | void MainWindow::on_serialBtn_clicked()
7 | {
8 | if (_serial.isOpen()) {
9 - | _serialWorker.quit();
10 - | while (_serialWorker.isRunning());
11 + | // _serialWorker.quit();
12 + | // while (_serialWorker.isRunning());
13 + | if (_serialWorker.isRunning()) {
14 + | _serialWorker.requestInterruption();
15 + | _serialWorker.wait();
16 + | }
17
18 | _serial.close();
19 | serialLog("Serial device closed");
20 diff --git a/src-desktop/serialworker.cpp b/src-desktop/serialworker.cpp 21 index 15301cb..f70bce8 100644
22 --- a/src-desktop/serialworker.cpp
spectrum-analyzer.tex | Naoki Pross | 16

23 +++ b/src-desktop/serialworker.cpp 24 @@ -1,6 +1,7 @@
25 #include "serialworker.h"
26
27 #include <QMutexLocker >
28 +#include <string >
29
30 | SerialWorker::SerialWorker(serial::Serial &serial) :
31 | _mutex(), _serial(serial)
32 @@ -15,12 +16,17 @@ SerialWorker::~SerialWorker()
33
34 | void SerialWorker::run()
35 | {
36 - | while (isRunning()) {
37 + | while (!isInterruptionRequested()) {
38 | QMutexLocker locker(&_mutex);
39 - | while (!_serial.available() && isRunning());
40 + | while (!_serial.available() && !isInterruptionRequested());
41
42 - | QString data = QString::fromStdString(_serial.readline());
43 - | emit receivedData(data);
44 + | for (std::string line : _serial.readlines()) {
45 + | QString data = QString::fromStdString(line);
46 + | emit receivedData(data);
47 + | }
48 +
49 + | // QString data = QString::fromStdString(_serial.readline());
50 + | // emit receivedData(data);
51 | _serial.flushOutput();
52 | }
53 | }

### 4.2.4 Libreria HT1632

Purtroppo per mancanza di tempo non è stato possibile realizzare la visualizzazione con la matrice led HT1632. La libreria adattata da un LPI precedente, doveva garantire il supporto per il microcontrollore scelto durante il progetto. Nella fase di sviluppo però si è notato che il codice (opinione personale) non è di qualità eccellente, in quanto utilizza tecniche come NOP per generare delay (dipendenza dal clock) e bit-banging delle porte malgrado il microcontroller disponga di un chip SPI dedicato. Dunque molto tempo è stato perso ad analizzare il codice della libreria, purtroppo senza arrivare ad esito positivo.

## 4.3 Possibili miglioramenti e sviluppi futuri

### 4.3.1 Completare il supporto per la matrice

Come descritto nella sezione 4.2.4, il supporto della visualizzazione attraverso la matrice è mancante.

### 4.3.2 Filtro

Il circuito di filtraggio del rumore di alta frequenza potrebbe essere sostituito con un filtro di secondo o di terzo ordine per migliorarne le prestazioni.

spectrum-analyzer.tex | Naoki Pross | 17

### 4.3.3 Circuito di selezione dell’entrata

Il multiplexer utilizzato per l’entrata ha un valore d’impedenza non particolarmente eccezionale, per migliorare le prestazioni si dovrebbe scegliere un multiplexer differente.

### 4.3.4 Supporto per MacOS

Il software (al computer) dell’analisi spettrale attualmente non utilizza dipendenze che richiedono una piattaforma particolare. Portare il software per MacOS non dovrebbe essere difficile.

### 4.3.5 Supporto per altri formati di dati

Il software al computer attualmente supporta unicamente il formato CSV (Comma Separated Values) per l’esportazione dei dati. Sarebbe opportuno aggiungere il supporto di altri formati come DAT (Data), TSV (Tab Separated Values) e ODS (Open Document format for Spreadsheet).

## 4.4 Commento

Personalmente ho trovato il progetto molto interessante e coinvolgente. Malgrado la complessità dell’argomento trattato, grazie al supporto di docenti ed amici, sono riuscito ad avere una comprensione tutto sommato abbastanza completa del funzionamento del principio matematico dell’analisi spettrale.

## 4.5 Ringraziamenti

Vorrei ringraziare Eduardo Cima: professore di elettrotecnica alla SAM e Raffaele Ancarola: studente di fisica del primo anno al Politecnico Federale di Losanna (EPFL), per il grande supporto attraverso spiegazioni e chiarimenti degli strumenti matematici della trasformata di Fourier; ed infine vorrei ringraziare anche il professor Emidio Planamente per l’aiuto a risolvere il bug di sincronizzazione (4.2.3).

## 4.6 Certificazione

Il sottoscritto dichiara di aver redatto e prodotto individualmente il lavoro di produzione.

Data: | Firma:
Naoki Pross
spectrum-analyzer.tex | Naoki Pross | 18

# 5 Trasformata di Fourier

## 5.1 Nozioni preliminarie

### 5.1.1 Regressione lineare con il metodo dei minimi quadrati

La regressione lineare è un’approssimazione di una serie di dati ad una funzione lineare. Questa retta di approssimazione può essere calcolata in molteplici modi, per questo progetto è di interesse utilizzare il metodo dei minimi quadrati. Sarà dunque esplicato come trovare i coefficienti di una retta a m + 1 termini interpolando N punti.

r(x, a0, . . . , am) = a0 + x

∑m

i=1

ai | (5.1)

Consideriamo di avere gli insiemi X e Y entrambi con N termini di cui si prende le coppie ordinate di valori, ossia i punti da interpolare. Il metodo dei minimi quadrati trova i coefficienti della retta minimizzando il quadrato della differenza tra il valore stimato dalla retta y = r(xk) e il valore reale yk.

min((r(xk) − yk)

2
) ∀xk ∈ X, yk ∈ Y

Definiamo quindi la funzione da minimizzare ε

ε(a0, . . . , am) = ∑

N

k=1

[
r(xk, a0, . . . , am) − yk

]2
(5.2)

Da cui si computa le derivati parziali rispetto ai coefficienti ricercati, ottenendo un sistema di equazioni lineare poichè si cerca per ogni derivata quando essa equivale a 0. Ciò corrisponde anche ad affermare che il gradiente di ε è un vettore ∈ R
m+1 con tutte le componenti a 0.

∇ε = (0, . . . , 0)

A questo punto si può procedere risolvendo il sistema con l’algebra lineare definendo la matrice di trasformazione A e il vettore dei termini noti ⃗u

∇ε = A(a0, . . . , am) + ⃗u ⇐⇒ (a0, . . . , am) = A⁻¹ (−⃗u)

### 5.1.2 Funzione armonica

Una funzione armonica, sinusoidale, può essere descritta in molteplici modi. Nella forma trigonometrica, data la pulsazione ω = 2πf =

2π
T

e la fase φ =

π
2

− ϑ.

f(x) = a · sin(ωx + φ)
f(x) = b · cos(ωx + ϑ)

Conoscendo la formula di Eulero e iφ = cos(φ) + i·sin(φ) possiamo riscrivere f(x) utilizzando la forma complessa del seno e del coseno.

f(x) = a
2i
- (e

i(xω+φ) − e

−i(xω+φ)
)

f(x) = b
2
- (e

i(xω+ϑ) + e

−i(xω+ϑ)
)
spectrum-analyzer.tex | Naoki Pross | 19

### 5.1.3 Proprietà di ortogonalità del seno e del coseno

Per avere delle fondamenta solide prima dell’introduzione dell’argomento principale, saranno dimostrate le proprietà di ortogonalità del seno e coseno considerando il periodo T in uno spazio euclideo.

Intuizione geometrica

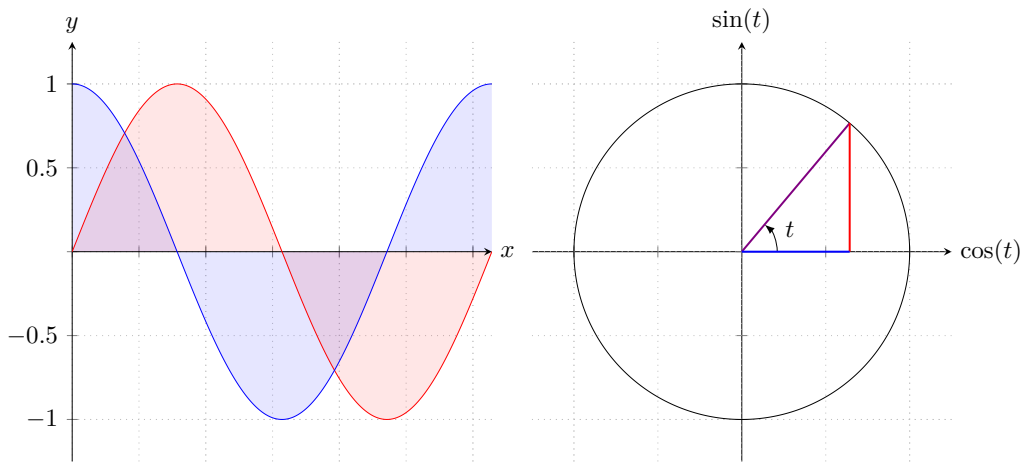
[picture p16: figure]
cos(t); sin(t)

Figura 5.1: Funzioni sin e cos

Si può osservare intuitivamente dal cerchio unitario nella figura 5.1 che le funzioni seno e coseno sono ortogonali tra loro. Dal grafico a sinistra possiamo inoltre osservare che l’area (integrale) di un periodo è sempre nulla.

Dimostrzioni algebriche

1. Area di sin in un periodo.
∫ T

0

sin(

m2πx
T

) dx = 0 ∀m ∈ Z
∫ T

0

sin(

m2πx
T

) dx =

[
−

T
2πm
- cos (2π
T

mx)

]T

0
= −

T
2πm
- cos (

2πm)
+

T
2πm
- cos (
0

)

= 0

spectrum-analyzer.tex | Naoki Pross | 20

2. Area di cos in un periodo.
∫ T

0

cos(

m2πx
T

) dx = 0 ∀m ∈ Z

∗
∫ T

0

cos(

m2πx
T

) dx =

[
T
2πm
- sin (2π
T

mx)

]T

0
=

T
2πm
- sin (

2πm)
+

T
2πm
- sin (
0

)

=

{
0 | ⇐⇒ m ̸= 0
T | ⇐⇒ m = 0
3. Prodotto tra sin e cos.
∫ T

0

sin(

m2πx
T

) cos(

n2πx
T

) dx = 0 ∀m, n ∈ Z
∫ T

0

sin(

m2πx
T

) cos(

n2πx
T

) dx =

1
2

∫ T

0

sin [
2π
T

(n + m)x

]
dx
| | {z | }
0

−

1
2

∫ T

0

sin [
2π
T

(n − m)x

]
dx
| | {z | }
0
= 0
4. Prodotto tra due sin di frequenze diverse.
∫ T

0

sin(

m2πx
T

)sin(

n2πx
T
) dx = 0 ∀m, n ∈ Z | m ̸= ±n
∫ T

0

sin(

m2πx
T

)sin(

n2πx
T

) dx =

1
2

∫ T

0

cos [
2π
T

(n − m)x

]
dx
| | {z | }
m−n ̸= 0 =⇒ 0

−

1
2

∫ T

0

cos [
2π
T

(n + m)x

]
dx
| | {z | }
m+n ̸= 0 =⇒ 0

=

0 | ⇐⇒ n ̸= ±m
T/2 | ⇐⇒ n = m
−T/2 | ⇐⇒ n = −m
5. Prodotto tra due cos di frequenze diverse.
∫ T

0

cos(

m2πx
T

) cos(

n2πx
T

) dx = 0 ∀m, n ∈ Z

∗
| m ̸= ±n
∫ T

0

cos(

m2πx
T

) cos(

n2πx
T

) dx =

1
2

∫ T

0

cos [
2π
T

(n + m)x

]
dx
| | {z | }
m+n ̸= 0 =⇒ 0

+

1
2

∫ T

0

cos [
2π
T

(n − m)x

]
dx
| | {z | }
m−n ̸= 0 =⇒ 0

=

{
0 | ⇐⇒ n ̸= ±m
T/2 | ⇐⇒ n = ±m
spectrum-analyzer.tex | Naoki Pross | 21

6. sin e cos raggruppate nella forma complessa con la formula di Eulero.
∫ T

0

e

i2πkx/T dx = 0 ∀k ∈ Z

∗
∫ T

0

e

i2πkx/T dx =

∫ T

0

cos(

2π
T

kx) dx
| {z }
k̸=0 =⇒ 0

+ i

∫ T

0

sin(

2π
T

kx) dx
| {z }
0

=

{
0 | ⇐⇒ k ̸= 0
T | ⇐⇒ k = 0

## 5.2 Polinomio Trigonometrico

### 5.2.1 Polinomio Trigonometrico

Analogamente a come è definito un polinomio P “normale”, una somma di termini dal grado 0 fino al grado N, è possibile definire anche un polinomio trigonometrico T.

PN (x) = ∑

N

n=0

anx

n

an ∈ R, aN ̸= 0

TN (x) = ∑

N

n=0

cne

iωnx cn ∈ C, ω ∈ R, cN ̸= 0

Questo polinomio è detto trigonometrico perché utilizzando la formula di Eulero e

iφ = cos(φ)+isin(φ)
si può espandere nel seguente modo.

TN (x) = ∑

N

n=0

[

an · cos(ωnx) + ibn · sin(ωnx)] an, bn ∈ C

### 5.2.2 Polinomio Trigonometrico Reale

È definito inoltre il polinomio trogonometrico reale come

TN (x) = ∑

N

n=0

[

an · cos(ωnx) + bn · sin(ωnx)] an, bn ∈ R

Mediante delle identità trigonometriche può essere riscritto anche nel modo seguente.

TN (x) = ∑

N

n=0

An · cos(ωnx − φ)

Oppure nella sua forma complessa in cui ck =

ak
2

+

bk
2i

TN (x) = ∑

N

n=0

cn e

iωnx + ¯cn e

−iωnx | cn ∈ C
spectrum-analyzer.tex | Naoki Pross | 22

Definendo c−n = ¯cn è possibile ridurre la notazione.

TN (x) = ∑

N

n=−N

cn e

iωnx

In tutti i casi possiamo osservare che il polinomio trogonometrico è una somma di sinusoidi di frequenze multiple ad una base f = ω/2π. Se descritto mediante la terminologia dell’algebra lineare, si può anche osservare che un polinomio trigonometrico è una combinazione lineare nello spazio funzionale dalle basi ortonormate sin(ωx) e cos(ωx).

## 5.3 Serie di Fourier

Un polinomio trigonometrico reale di infiniti termini è una serie di Fourier, in onore al matematico francese J. B. Fourier.
S(x) = ∑∞

n=−∞

cn e

iωnx =

∑∞

n=0

an · cos(ωnx) + bn · sin(ωnx)

### 5.3.1 Convergenza della serie

La convergenza puntuale della serie di Fourier è dimostrabile dalle condizioni del teorema di Dirichlet. Purtroppo questa dimostrazione richiede una grande quantità di nozionistica matematica che non può essere riassunta in pochi paragrafi. In allegato e nelle referenze sono presenti dei documenti che analizzano e dimostrano questa proprietà.
Da questo punto è da dare per assunto che è dimostrata la convergenza puntuale della serie di Fourier di una funzione reale a condizione che:
1. |f(x)| (valore assoluto) è integrabile in un periodo.
2. La funzione deve essere di variazione limitata, ossia devono esserci un numero finito di minimi e massimi in un qualsiasi intervallo.
3. La funzione deve avere un numero finito di discontinutià in un qualsiasi intervallo chiuso e le discontinuità non devono essere infinite.

## 5.4 Trasformata di Fourier discreta

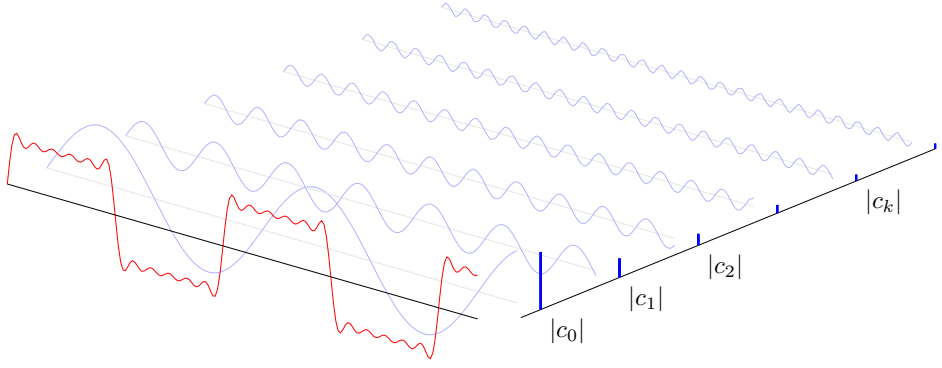
[picture p17: figure]

Figura 5.2: Rappresentazione grafica della transformata di Fourier [9]

spectrum-analyzer.tex | Naoki Pross | 23

La Trasformata di Fouerier Discreta (DFT) è l’operazione matematica che permette di trovare i coefficienti della serie di Fourier o di un polinomio trigonometrico, per approssimare al meglio una funzione. Se presa a sestante però essa essendo una trasformata può essere osservata anche come una funzione che da uno spettro discreto di una funzione. La densità spettrale ottenuta dalla DFT è dipende dalla frequenza di base scelta e nel caso di un polinomio trigonometrico, anche dal numero di termini di quest’ultimo.

Xk = ck · T =

∫ T

0

f(x) · e

−iωkx dx

Nella figura 5.2, possiamo osservare sul grafico x⊥z in rosso una funzione, ed il suo spettro sull’asse y⊥z in blu. Si può intuire che più

### 5.4.1 Derivazione della DFT

Per trovare la DFT, supponiamo di voler approssimare una funzione, utilizzando il metodo dei minimi quadrati, con un polinomio trigonometrico reale.

TN (x) = ∑

N

n=0

An · cos(ωnx − φ) ω = 2πf

Sappiamo che questo può essere scritto anche nel seguente modo.

TN (x) = ∑

N

n=0

an · cos(ωnx) + bn · sin(ωnx)

Dunque per trovare i termini a0, . . . , aN e b0, . . . , bN definiamo una funzione ε da minimizzare con il metodo dei minimi quadrati.

ε =

∫ T

0

[
TN (x) − f(x)

]2
dx

Per generalizzare sarà dimostrato come trovare il k-esimo termine.

Termini dei coseni

I termini dei coseni ak sono ottenuti eguagliando la derivata parziale di ε a zero.

∂ε
∂ak

= 0 =

∂
∂ak

∫ T

0

[
TN (x) − f(x)

]2
dx

0 = ∫ T

0

∂
∂ak

[∑

N

n=0

an cos(ωnx) + bn sin(ωnx) − f(x)

]2
dx

0 = ∫ T

0

2

[∑

N

n=0

an cos(ωnx) + bn sin(ωnx) − f(x)

]
- ak cos(ωkx) dx

0 = ∫ T

0

cos(ωkx)

∑

N

n=0

an cos(ωnx) dx
| | {z | }
| k̸=n =⇒ 0

+

∫ T

0

cos(ωkx)

∑

N

n=0

bn sin(ωnx) dx
| | {z | }
| 0

−

∫ T

0

cos(ωkx) · f(x) dx

0 = ak ·

T
2

−

∫ T

0

cos(ωkx) · f(x) dx

ak
2

=

1
T

∫ T

0

cos(ωkx) · f(x) dx

spectrum-analyzer.tex | Naoki Pross | 24

Termini dei seni

I termini dei seni bk sono ottenuti eguagliando la derivata parziale di ε a zero.

∂ε
∂bk

= 0 =

∂
∂bk

∫ T

0

[
TN (x) − f(x)

]2
dx

0 = ∫ T

0

∂
∂bk

[∑

N

n=0

an cos(ωnx) + bn sin(ωnx) − f(x)

]2
dx

0 = ∫ T

0

2

[∑

N

n=0

an cos(ωnx) + bn sin(ωnx) − f(x)

]
- bk sin(ωkx) dx

0 = ∫ T

0

sin(ωkx)

∑

N

n=0

an cos(ωnx) dx
| | {z | }
| 0

+

∫ T

0

sin(ωkx)

∑

N

n=0

bn sin(ωnx) dx
| | {z | }
| k̸=n =⇒ 0

−

∫ T

0

sin(ωkx) · f(x) dx

0 = bk ·

T
2

−

∫ T

0

sin(ωkx) · f(x) dx

bk
2

=

1
T

∫ T

0

sin(ωkx) · f(x) dx

Termine complesso

A questo punto è possibile raggurppare i termini ak e bk in un unico valore complesso ck, come descritto nella sezione 5.2.2.

ck =

ak
2

+

bk
2i

ck =

1
T

∫ T

0

cos(ωkx) · f(x) dx +

1

T i ∫ T

0

sin(ωkx) · f(x) dx

ck =

1
T

∫ T

0

f(x) ·

[
cos(ωkx) − isin(ωkx)

]
dx

ck =

1
T

∫ T

0

f(x) · e

−iωkx dx

### 5.4.2 DFT da un insieme di campioni discreti

L’operazione della DFT può essere applicata anche ad un insieme di N valori discreti, che per esempio potrebbero originare da un campionamento di un segnale elettrico. In tal caso la trasformata discreta di Fourier è la seguente.

Xk = ck · T =

N

∑−1

n=0

xn · e

−iωkn

Utilizzando questa notazione con gli indici è possibile anche notare che la TFD può essere espressa come una matrice V. Definendo il vettore ⃗x = (x0, x1, . . . , xN−1) e X⃗ = (X0, . . . , XN−1) si ottiene

X⃗ = V · ⃗x

spectrum-analyzer.tex | Naoki Pross | 25

Dove
[V]kn = (e

iω)

−kn

ossia, se rappresentata nel suo intero

V =

1 | 1 | 1 | . . . | 1
1 | (e
| iω)

−1
(e
| | iω)

−2
. . . (e

iω)

| | | | −(N−1)
1 | (e
| iω)

−2
(e
| | iω)

−4
| | | . . . (e

iω)

| | | | −2(N−1)

1 (e

iω)

−(N−1) (e
iω)
| | −2(N−1) | . . . (e
iω)
| | | | −(N−1)²

Osservando la matrice si nota subito una simmetria diagonale, che è data dalla progressione geometrica [V]ij = [V]

j−1
i

. Questa matrice è detta una matrice di Vandermonde, da cui è stato scelto il nome V.

## 5.5 Trasformata di Fourier

Dalla DFT si è sviluppato lo strumento matematico per ottenere lo spettro discreto di una funzione. Il risultato della DFT però è una funzione discontinua con valori spettrali unicamente multipli della base. La Trasformata di Fourier estende ulteriormente producendo una funzione di spettro continua. Un modo intuitivo per ottenere questo requisito, è di far tendere il limite della densità spettrale, data dal periodo, verso l’infinito. Per i seguenti passaggi sarà utilizzata la funzione s per indicare la funzione reale di cui si osserva lo spettro. Partendo dall’approssimazione data dalla DFT possiamo asserire che

s(x) ≈

∑∞

n=−∞

Xn
T
- e

i2πxn/T

s(x) ≈

∑∞

n=−∞

1
T

∫ T/2

−T/2

s(x) · e

−i2πxn/T dx
| | {z | }
| Xn
- e

i2πxn/T

s(x) = lim
T→∞

∑∞

n=−∞

1
T

∫ T/2

−T/2

s(x) · e

−i2πxn/T dx · e
i2πxn/T

Osserviamo che

lim
T→∞

∑∞

n=−∞

1
T

=

∫ ∞

−∞

df | lim
T→∞

n
T

= f (variabile continua)

Dunque otteniamo
s(x) = ∫ ∞

−∞

df

∫ ∞

−∞

s(x) · e

−i2πfx dx
| {z }
F{s}
- e

i2πfx

Si nota a questo punto che il termine centrale è la trasformata di Fourier ed è una funzione dalla variabile continua f (frequenza). Si osservi inoltre che sono stati cambiati i limiti di integrazione del periodo. Definendo entrambi i limiti in funzione di T e facendo tendere T all’infinito, si ottiene come conseguenza secondaria che la trasformata non è più limitata ad una funzione periodica.

spectrum-analyzer.tex | Naoki Pross | 26

Formalmente dunque la Trasformata di Fourier, tipicamente notata con F oppure con l’accento circonflesso ˆf sul nome della funzione, è definita come segue.

F{f} = ˆf (ω) = ∫ ∞

−∞

f(x) · e

−iωx dx

spectrum-analyzer.tex | Naoki Pross | 27

# Elenco delle figure

2.1 Schema a blocchi | | 5
2.2 Circuito di selezione delle entrate | | | 5
2.3 Circuito di adattamento del segnale | | 6
2.4 Circuito di selezione delle entrate (prima versione) | | 7
2.5 Circuito di adattamento del segnale | | 8
3.1 Schema a blocchi del TIMER2 | | 9
3.2 Protocollo di trasmissione dei dati | | 9
3.3 Diagramma delle sequenze | | 13
3.4 Diagramma delle classi | | 13
3.5 L’applicativo sotto Fedora 27 (sinistra) e Windows 7 (destra) | | 14
3.6 Esempio di immagine esportata dal software | | 14
4.1 Spettro di un’onda sinusoidale (rosso) e di un segnale quadrato (blu) | | 15
5.1 Funzioni sin e cos | | 20
5.2 Rappresentazione grafica della transformata di Fourier [9] | | 23
6.1 Diagramma di flusso del codice del microcontrollore | | | 42

# Elenco delle tabelle

1.1 Norme di progetto: Software | | 4
1.2 Norme di progetto: Hardware | | 4
1.3 Norme di progetto: Programmazione | | 4
2.1 Sommario della configurazione utilizzata | | 7
2.2 Configurazione della porta seriale | | 7
spectrum-analyzer.tex | Naoki Pross | 28

# Bibliografia

[1] Real Time Audio Spectrum Analyzer. (online) Simon Inns. Jan 8 2011. https://www.waitingforfriday.com/?p=325
http://archive.is/IJeAe (archived)
[2] Divide and Couquer: FFT. (online, video)
Erik Demaine, MIT OpenCourseWare. MIT 6.046J Design and Analysis of Algorithms, Spring 2015 https://youtu.be/iTMn0Kt18tg
[3] But what is the Fourier Transform? A visual introduction. (online, video) Grant Sanderson. Jan 26, 2018. YouTube.
https://youtu.be/spUNpyF58BY
[4] Théorie et traitement des signaux. (Pag. 70 – 72)
Coulon, Frédéric de (1996). Lausanne: Presses polytechniques et universitaires romandes, 1996 (Traité d’électricité de l’Ecole polytechnique fédérale de Lausanne; vol. 6)
[5] Algèbre linéaire. Aide-mémoire, exercices et applications. (Pag. 64 Moindres carrées) Dalang, Robert C. Chaabouni, Amel (2001). Lausanne: Presses polytechniques et universitaires romandes, 2001
[6] Algèbre linéaire. (Pag 63 – 65)
Cairoli, R. (1991). Lausanne: Presses polytechniques et universitaires romandes, 1991
[7] Linear Algebra. An Introductory Approach.
Curtis, Charles W. (2000). New York: Springer, 2000
[8] Eléments d’analyse numérique et appliquée
Kurt Arbentz, Otto Bachmann (1992). Lausanne: Presses polytechniques et universitaires romandes 1992
[9] Example: Fourier transform. (online) Jake. TeX.SE http://www.pgfplots.net/tikz/examples/fourier-transform/
spectrum-analyzer.tex | Naoki Pross | 29

Progetto: Spectrum Analyzer Inizio:
Persona in formazione: Naoki Pross Fine:

Data

Giorno

ATTIVITÀ Tempo

Analisi e comprensione della FT, DFT, FFT 10 p p p p p p p p p p

8 c c c c c c c c

Preparazione di un prototipo su piastra sperimentale 9 p p p p p p p p p
3 c c c

Progettazione dello schema elettrico e del PCB 18 p p p p p p p p p p p p p p p p p p

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

Assemblaggio del PCB 4 p p p p

6 c c c c c c

Programmazione del microcontroller 11 p p p p p p p p p p p

16 c c c c c c c c c c c c c c c c

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

Allestimento ed esecuzione di test hardware e software 6 p p p p p p

4 c c c c

0

0

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

Totale preventivo 83

Totale consuntivo 83

M P
11.05.2018

Ve

30.04.2018

Lu

M P P

26.04.2018 27.04.2018

Gio Ve

M P M

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
12.04.2018

Gio

M P M P M

12.04.2018

15.05.2018

P

13.04.2018

Ve

16.04.2018 17.04.2018

Lu Ma

14.05.2018 15.05.2018

Lu Ma

M P M P

Pianificazione.xlsx

CAM-SAM | Elettronico | 22.02.2018

# DIARIO GIORNALIERO

Candidato: Naoki Pross | Progetto: Spectrum Analyzer
Formatore: Rinaldo Geiler, Daniele Kamm | Periodo: 12.04.2018 – 15.04.2018
Giorno | Data | Ore | Descrizione attività (Attività eseguite, metodi adottati, decisioni prese, dimostrazioni effettuate, ecc.) | Osservazioni
Gio | 12.04.2018 | 2 | Preparazione della documentazione, della pi-anifica ed organizzazione generale del progetto.
Gio | 12.04.2018 | 5 | Analisi e studio del concetto matematico.
Gio | 12.04.2018 | 1 | Raccolto informazioni e librerie software per i componenti utilizzati dal progetto. Inoltre è stata preparata una struttura per la documen-tazione.
Ve | 13.04.2018 | 2 | Scelto i componenti analogici e passivi e preparato una BOM (Bill Of Materials). Pro-gettato uno schema elettrico. | È stato scelto di utilizzare un unico amplificatore di qualità migliore (per audio) con un multiplexer in-vece di un package con più ampli-ficatori di precisione inferiore.
Ve | 13.04.2018 | 3 | Realizzato la parte centrale dello schema elet-trico in formato ECAD (Altium Designer). Os-sia i circuiti di multiplexing, di adattamento del segnale e di filtraggio delle frequenze indesider-ate. | Manca il jack di alimentazione (non ancora necessaria su tavola sper-imentale) e il circuito di adatta-mento di tensione da 12 V a 5 V.
Ve | 13.04.2018 | 2 | Modificato il circuito progettato per utilizzare un filtro attivo anzichè passivo dopo aver osser-vato sperimentalmente l’attenuazione dal filtro passivo. | Il circuto su piastra sperimen-tale non è ancora funzionante per sviluppare i primi programmi di test.
Ve | 13.04.2018 | 2 | Studiato il concetto matematico della Fourier transform con il professor Edoardo Cima. | L’attività non era programmata poichè la disponibilità dei docenti è limitata.
Lu | 16.04.2018 | 1 | Realizzato un circuito di prova su piastra sper-imentale. | Si è osservato che il circuito progettato non era idoneo. L’amplificatore scelto in prece-denta (TL071) non è in grado di lavorare come necessario nel margine da 0 V a 5 V. Dunque è stato cambiato in un OPAMP Rail-to-Rail AD820 sotto consiglio di D. Kamm.
Lu | 16.04.2018 | 2 | Corretto il circuito di amplificazione e risolto imperfezioni minori. | L’amplificatore combinato con il fil-tro è stato separato in due stadi, di amplificazione e di filtraggio.
journal.tex | Naoki Pross | 1

CAM-SAM | Elettronico | 22.02.2018
Lu | 16.04.2018 | 1 | Corretto il montaggio sulla piastra sperimen-tale. | Il filtro attivo non è presente sulla tavola perché si deve aspettare la comanda del componente.
Lu | 16.04.2018 | 5 | Implementato il codice del microcontroller per configurare l’ADC ed un timer per un campi-onamento regolare. | Si possono osservare i dettagli su Git nei seguenti commit: 7730a96, b836638, b482c7e, aa19054, 2996f65.
Lu | 16.04.2018 | 1 | Riordinato lo schema elettrico. Aggiunto il ciruito di regolazione della tensione in entrata con un MC7805. | Manca ancora il connettore princi-pale dell’alimentazione, rimane da decidere se utilizzare dei morsetti o un power jack.
Ma | 17.04.2018 | 2 | Diviso lo schema elettrico su più fogli per den-dere il tutto più ordinato. Preparato il footprint del Jack Audio.
Ma | 17.04.2018 | 1 | Analizzato un problema inerente alla program-mazione dell’interfaccia software per il com-puter con il professor Emidio Planamente. È presente un errore nella gestione delle risorse nel thread parallelo di gestione del se-riale. Il thread della classe SerialWorker deve essere terminato per rilasciare la risorsa MainWindow::_serial, ma ciò non accade e il programma crasha. Il problema è ancora ir-risolto. Riportato lo stato e discusso del progetto con Marco Bertoz (Perito). | Dettagli tecnici: 8ba16b0
Ma | 17.04.2018 | 2 | Terminato lo schema elettrico e controllato tutti i footprints. Richiesto una revisione al professor Rinaldo Geiler prima di procedere al PCB. | Se non vi sono errori si potrà in-iziare il design del PCB.
Gio | 26.04.2018 | 4 | Integrato dei consigli dal feedback da Geiler, ossia correzioni miniori e l’aggiunta di un bot-tone di reset manuale. Iniziato il design del PCB. | Presentato il progetto al capo per-ito.
Gio | 26.04.2018 | 4 | Risolto un il bug dell’interfaccia software desk-top con il professor E. Planamente. Il thread di lettura del seriale adesso viene chiuso corretta-mente. Implementato la rappresentazione grafica dei segnali campionati dal microcontroller ricevuti attraverso la seriale RS232. | Vedi 69d5d42, 2791cdd
Ve | 27.04.2018 | 5 | Terminato il routing del PCB. Risolto i prob-lemi indicati dal DRC. | Il footprint del potenziometro R14 è sbagliato. Il footprint del con-nettore RCA non può essere con-trollato poichè il componente non è ancora arrivato. Le correzioni del componente R14 e di eventu-ali altri saranno eseguite una volta ottenuti tutti i componenti prima della stampa.
journal.tex | Naoki Pross | 2

CAM-SAM | Elettronico | 22.02.2018
Ve | 27.04.2018 | 4 | Iniziato ad implementare un protocollo migliore per mandare i dati dal microcontroller al PC. Risolto un bug minore dell’applicativo desktop che causava un malfunzionamento sotto Windows. In dettaglio: la fun-zione _serial.waitReadable(); emetteva un IOException causando la chiusura del thread di lettura del seriale.
Lu | 30.04.2018 | 2 | Terminato l’implementazione del protocollo per mandare i dati. È ora possibile mandare numeri complessi interi sia positivi che negativi.
Lu | 30.04.2018 | 4 | Implementato il calcolo della FFT sul micro-controller e la corrispondente visualizzazione sul PC. | Commits: 8adeaa8, bec4185, dd19e0d
Lu | 30.04.2018 | 1 | Corretto i footprints, preparato i lucidi per la stampa.
Lu | 30.04.2018 | 2 | Cambiato il baudrate della trasmissione a 57.6 k e raddoppiato il numero di campi-oni. Modificato l’implementazione del PC per utilizzare le strutture std::complex invece della mia implementazione sam::complex_int16_t poichè sono standard ed hanno già tutte le operazioni matematiche definite. | Commits: d34ffc6, 41dae5e
Lu | 30.04.2018 | 1 | Continuato la documentazione.
Ve | 11.05.2018 | 6 | Raccolto i componenti necessari ed assemblato la scheda. | Alcuni connettori sono stati saldati in maniera rialzata per poter sal-dare sul lato superiore, poichè la stampa (realizzata a scuola) non collega i due layers nei fori / vias.
Ve | 11.05.2018 | 2 | Allestito test hardware. È stato trovato un er-rore nel dimensionamento della resistenza R11 del filtro attivo di anti alias. Il circuito aveva un rapporto di amplificazione di 2 anzichè di 1. L’errore di dimensionamento è stato tempo-raneamente risolto sostituendo R11 con una resistenza da 910 k portando il rapporto di am-plificazione a circa 1.016.
Lu | 14.05.2018 | 2 | Corretto delle imperfezioni nella stampa, quali piccolo corticircuiti e piste strappate. Saldato il connettore RCA.
Lu | 14.05.2018 | 2 | Implementato il codice per selezionare l’entrata. Iniziato ad analizzare l’implementazione della libreria HT1632 per la matrice LED.
Lu | 14.05.2018 | 1 | Testato la compilazione del software desktop sotto windows 7. Aggiornato lo script di de-ployment (rilascio, pubblicazione).
journal.tex | Naoki Pross | 3

CAM-SAM | Elettronico | 22.02.2018
Lu | 14.05.2018 | 2 | Apportato le correzioni nello schema elettrico per il prossimo prototipo.
Lu | 14.05.2018 | 3 | Continuato la documentazione.
Ma | 15.05.2018 | 5 | Concluso la documentazione.
journal.tex | Naoki Pross | 4

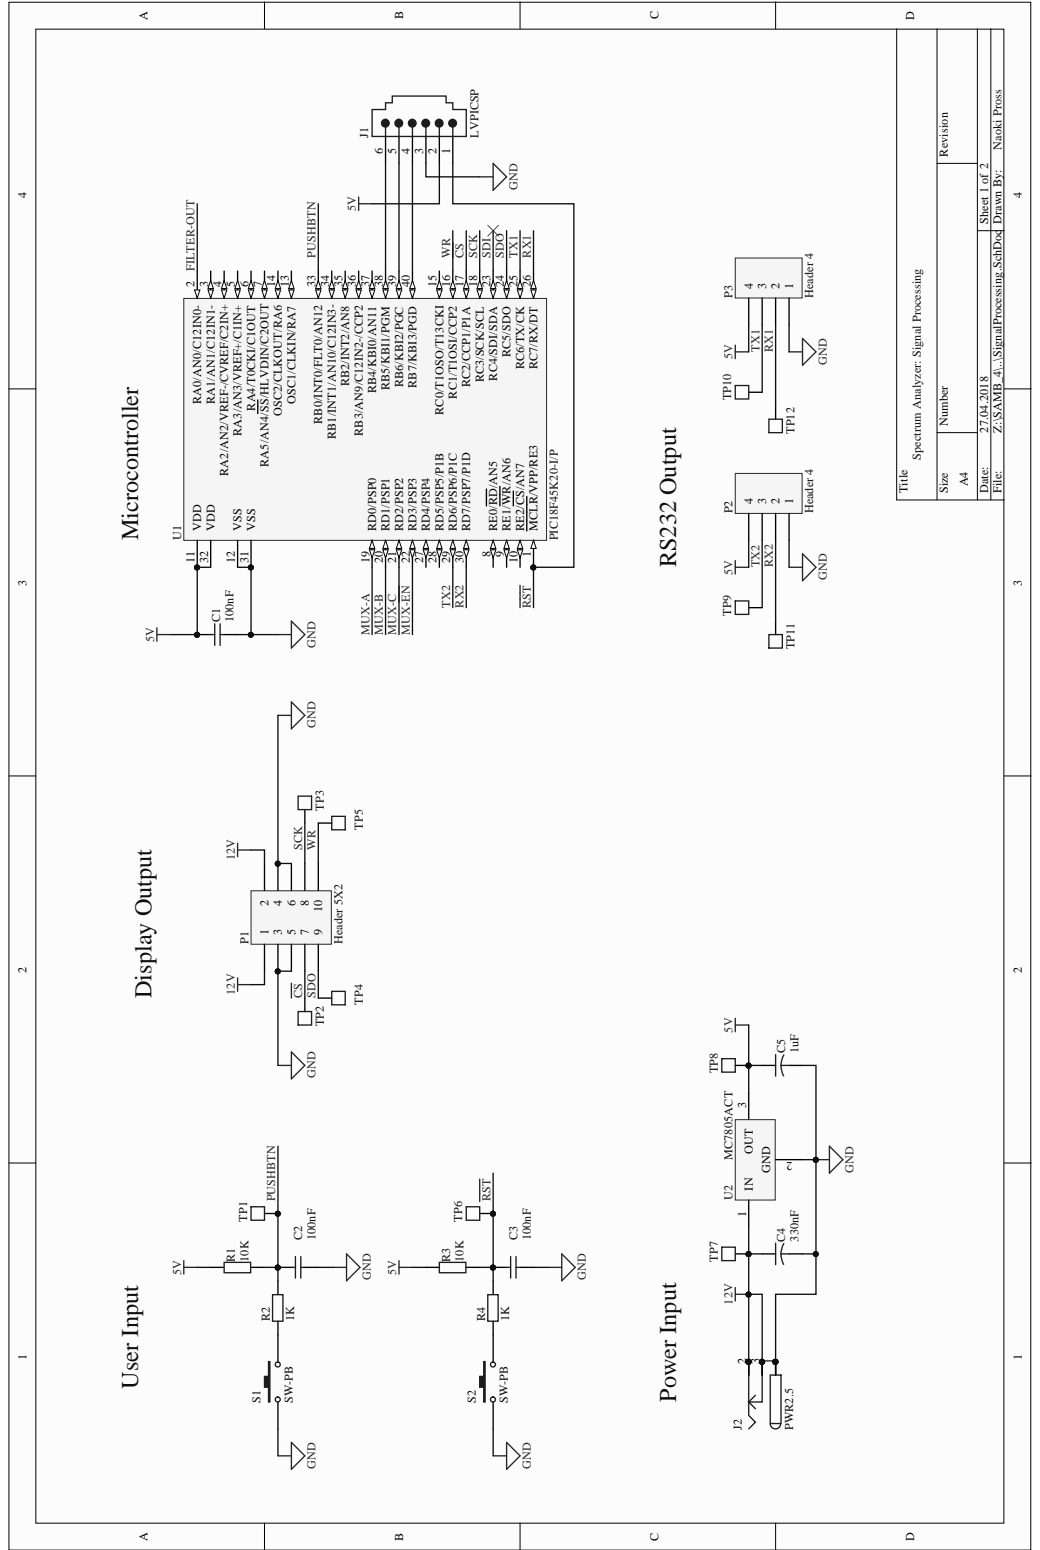
[picture p18: page 39]

File: Z:\SAMB_4\..\SignalProcessing.SchDoc Drawn By:

Spectrum Analyzer: Signal Processing

Microcontroller Display Output User Input

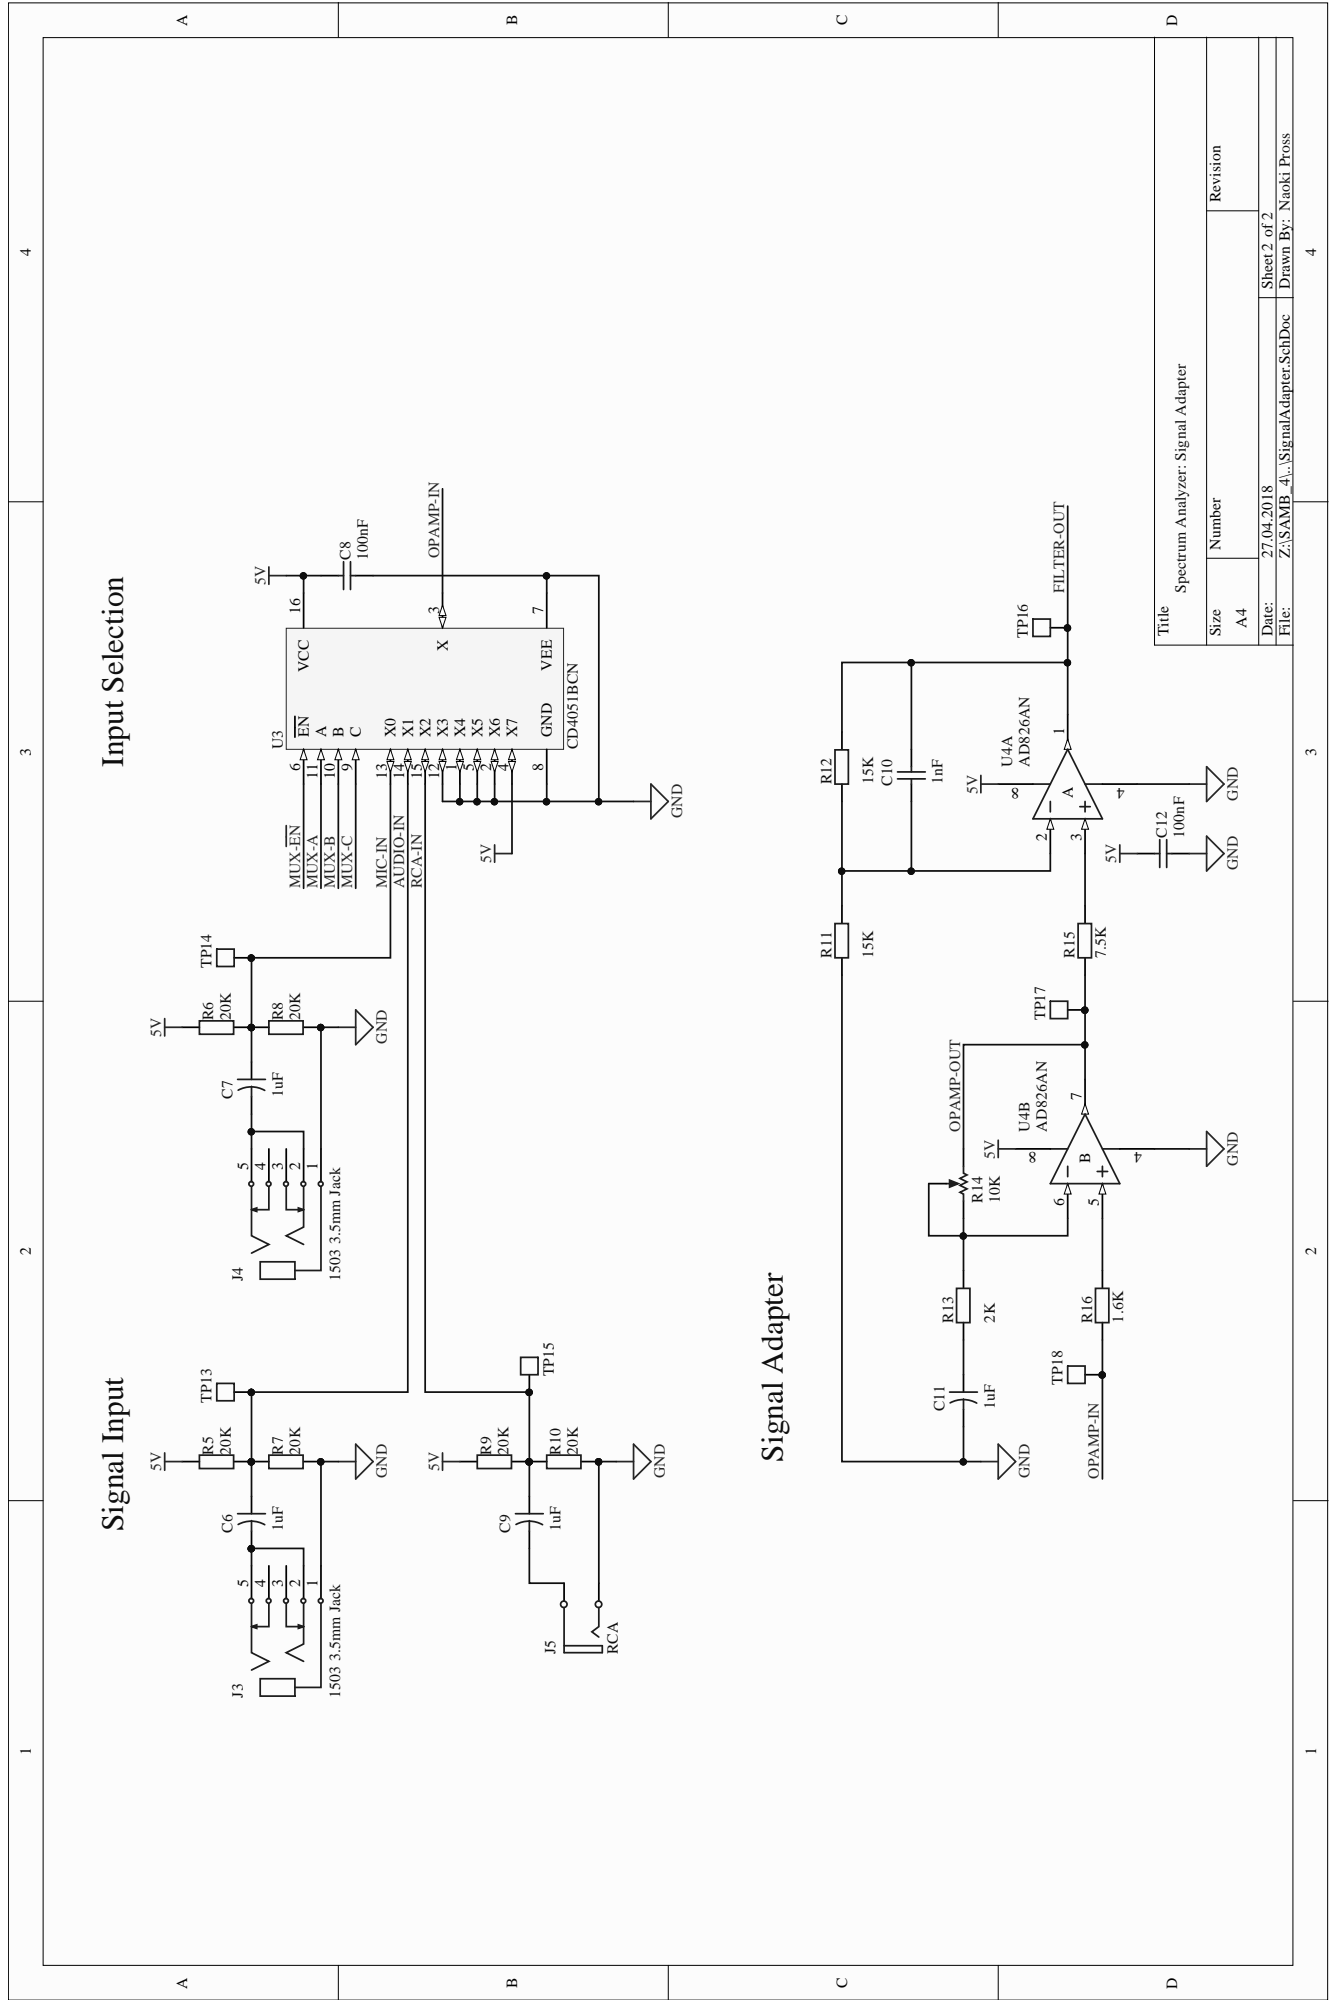
[picture p19: page 40]

File: Z:\SAMB_4\..\SignalAdapter.SchDoc Drawn By:

Spectrum Analyzer: Signal Adapter

Signal Input Input Selection

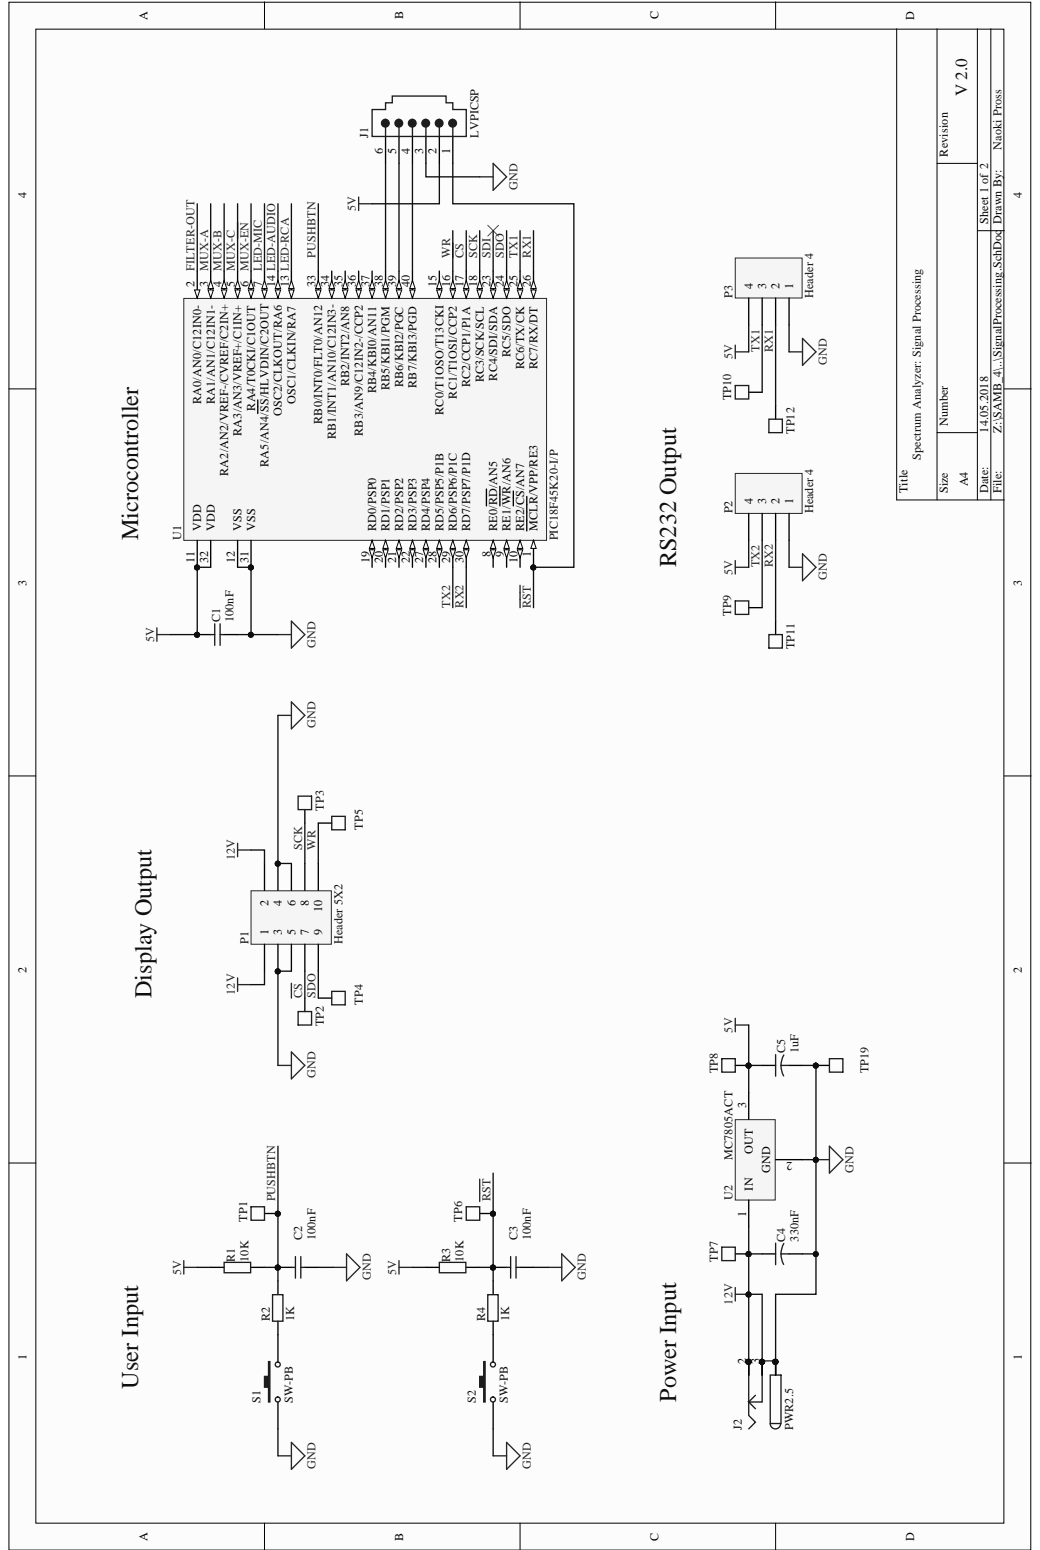
[picture p20: page 41]

File: Z:\SAMB_4\..\SignalProcessing.SchDoc Drawn By:

Spectrum Analyzer: Signal Processing

Microcontroller Display Output User Input

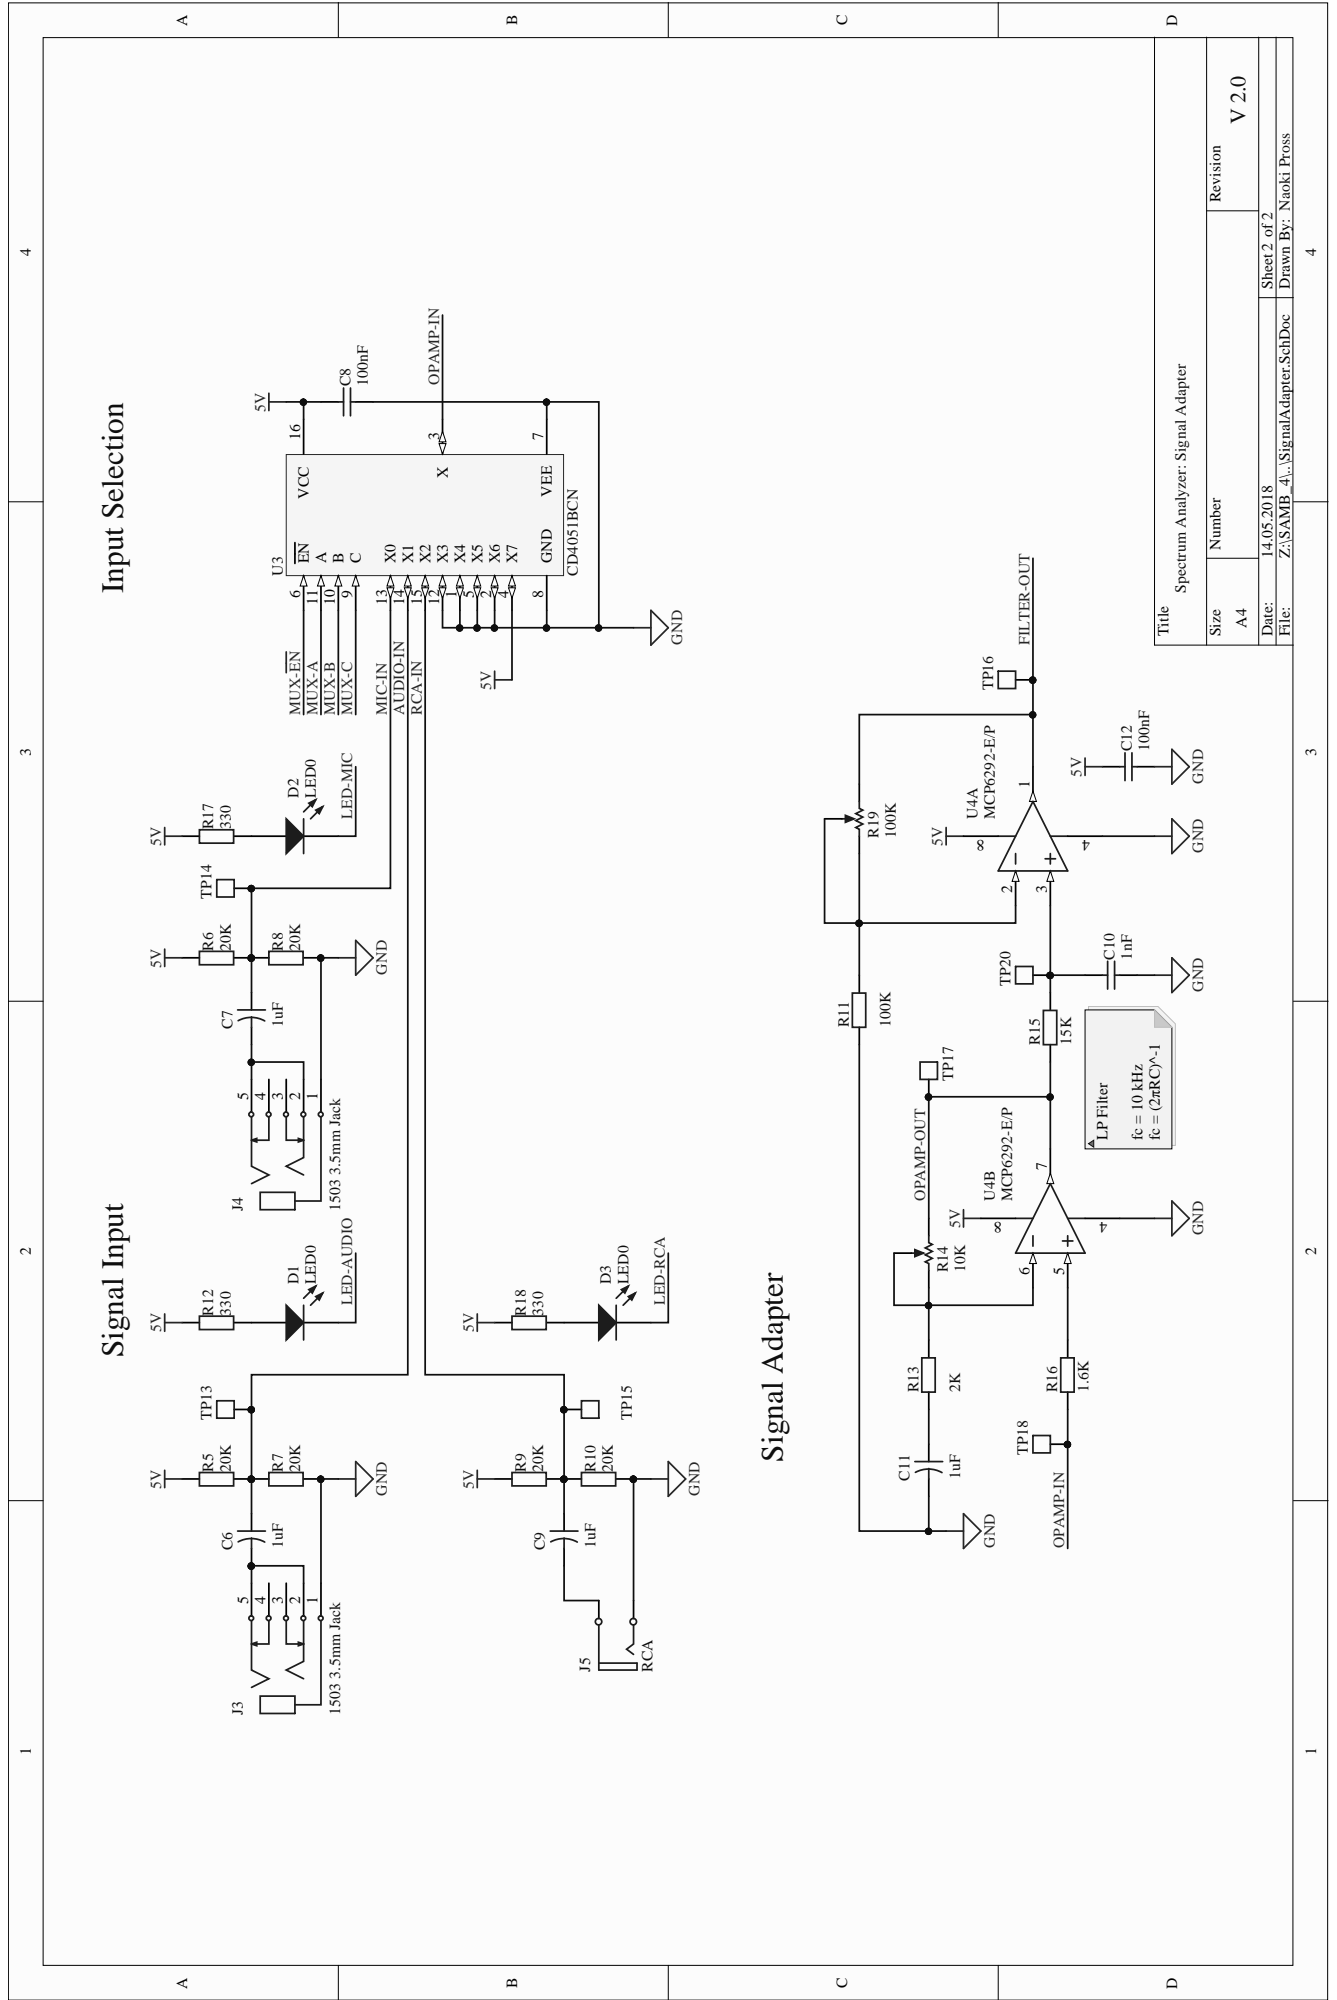
[picture p21: page 42]

File: Z:\SAMB_4\..\SignalAdapter.SchDoc Drawn By:

Spectrum Analyzer: Signal Adapter

Signal Input Input Selection

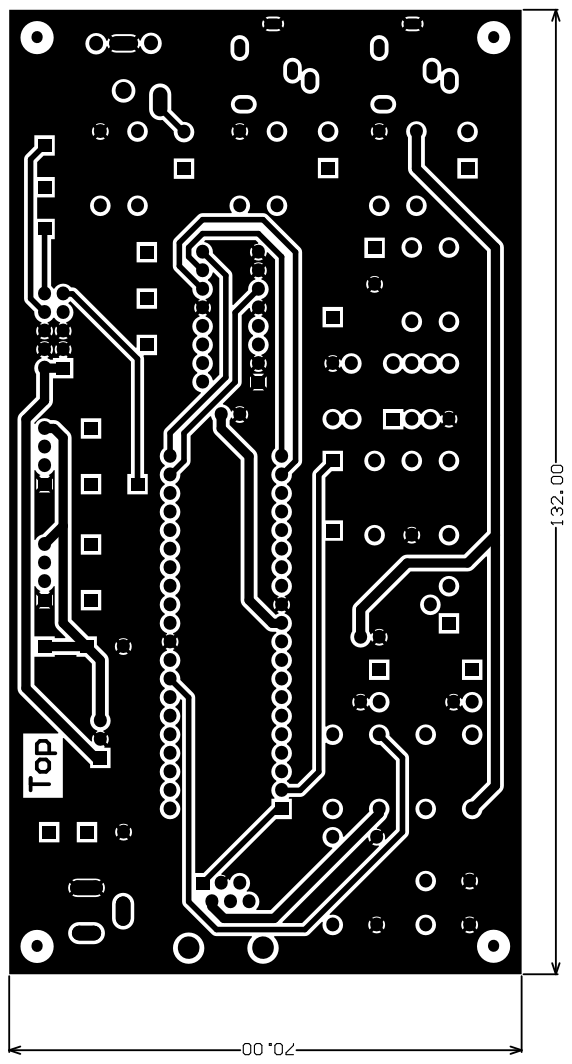
[picture p22: page 43]

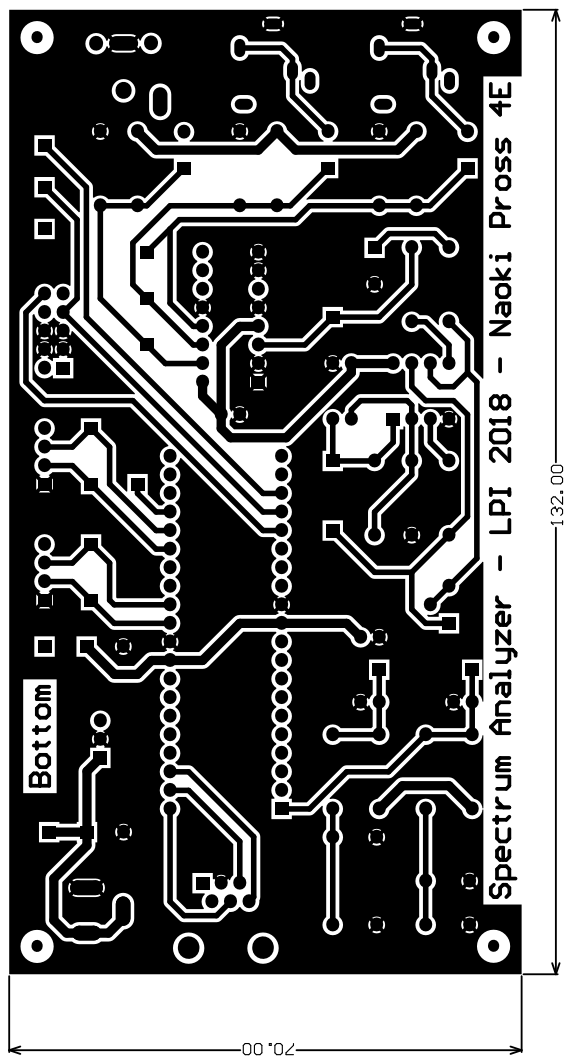
[picture p23: page 44]

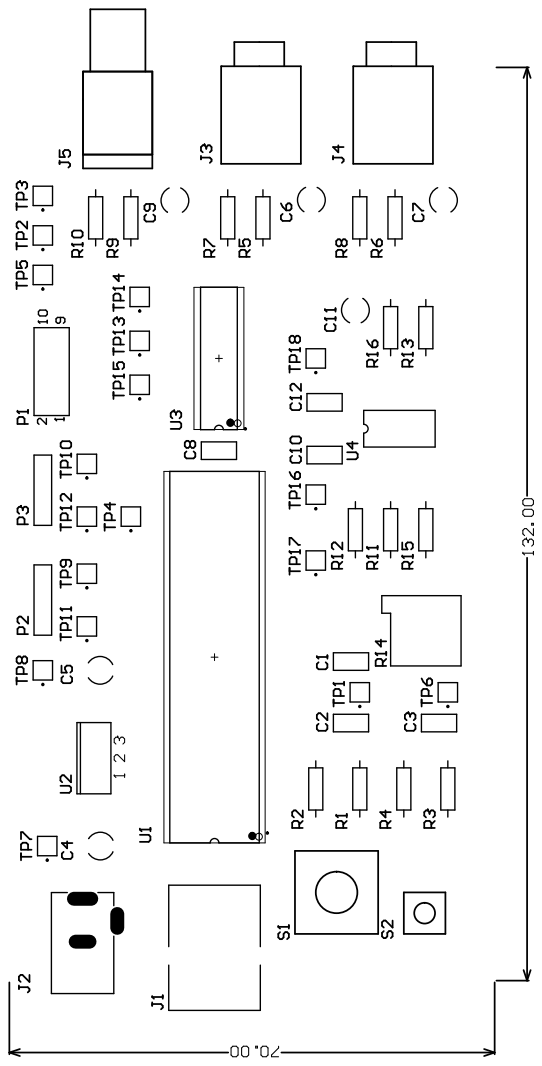
[picture p24: page 45]

## Codice sorgente

### Codice del microcontroller

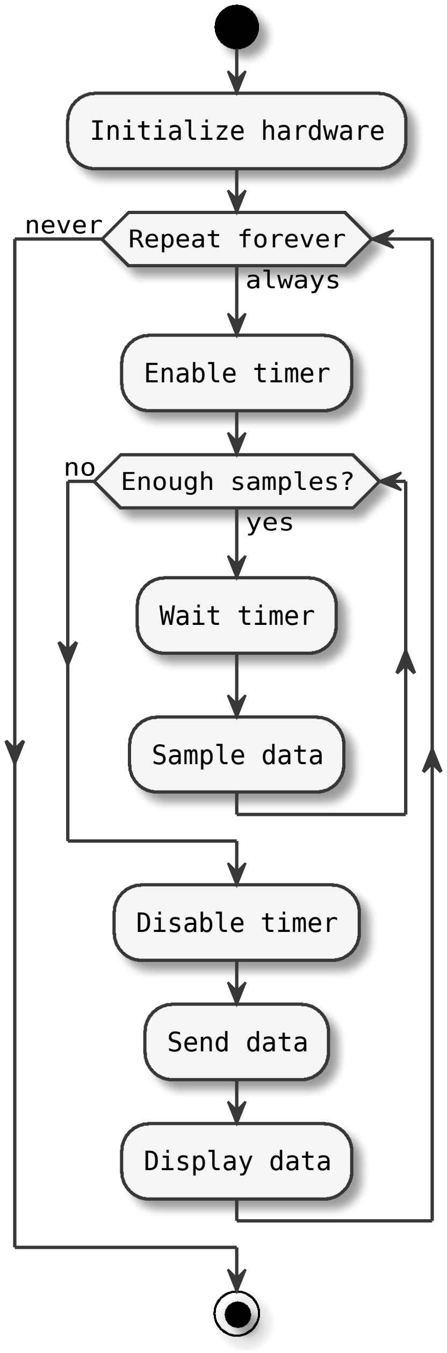
[picture p25: figure]
Initialize hardware; Enable timer; Wait timer; Sample data; yes; Enough samples?; Disable timer; Send data; Display data; always; Repeat forever; never

Figura 6.1: Diagramma di flusso del codice del microcontrollore
