NaoPross/SAMSpectrumAnalyzer/doc/presentation.pdf

## Spectrum Analyzer

### Lavoro Professionale Individuale

Naoki Pross
28 maggio 2018

SAM Bellinzona

### Indice

1. Introduzione
2. Fourier Transform
3. Fast Fourier Transform radix-2
4. Prodotto realizzato
5. Conclusioni

## Introduzione

### A cosa servono l’analisi spettrale e la FT?

Alcuni esempi pratici

Elettronica Filtri digitali, analisi di segnali
Informatica Audio editing, Riconoscimento sonoro / vocale Matematica Risoluzione di equazioni differenziali
Fisica Principio di indeterminazione di Heisenberg

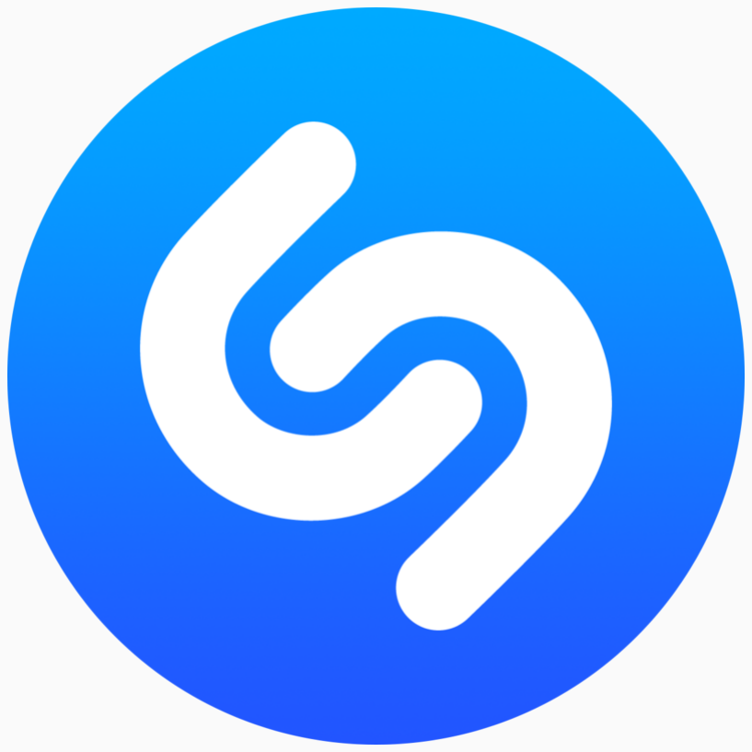
[picture p27: figure]
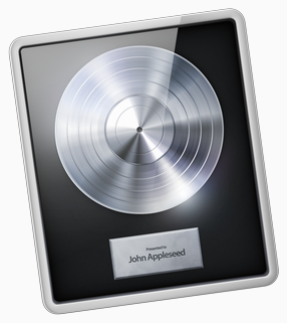
[picture p28: figure]
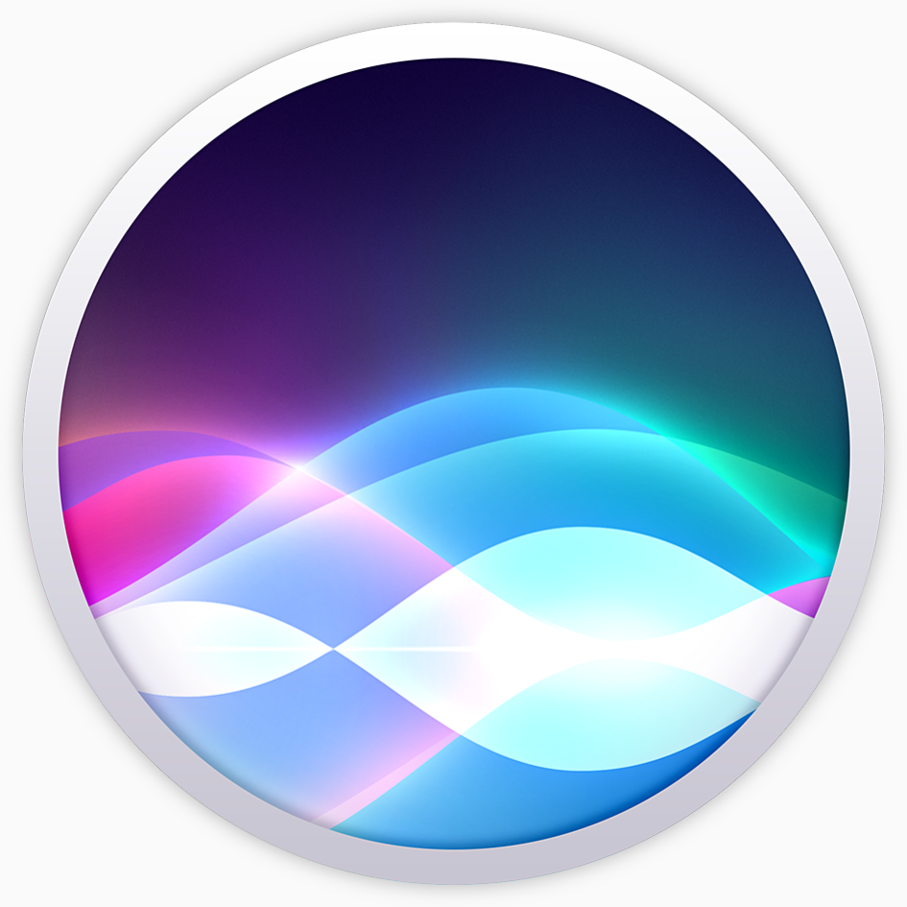
[picture p29: figure]

## ⟨x | pˆ | ψ⟩ = −iℏ

d
dxψ(x)

## ⟨x | ˆx | ψ⟩ = iℏ

d
dpψ(p)

### Obiettivo

Realizzare un circuito di analisi spettrale Requisiti
- Analisi dello spettro fino a 10 kHz
- Entrate Jack e RCA
- Visualizzazione
- Utilizzo di un PIC18F45K22

### Obiettivo

Realizzare un circuito di analisi spettrale Requisiti
- Analisi dello spettro fino a 10 kHz
- Entrate Jack e RCA
- Visualizzazione
- Utilizzo di un PIC18F45K22

Componenti
- Circuito di adattamento in entrata
- Design di un PCB
- Software per il uC e per il PC

### Schema a blocchi

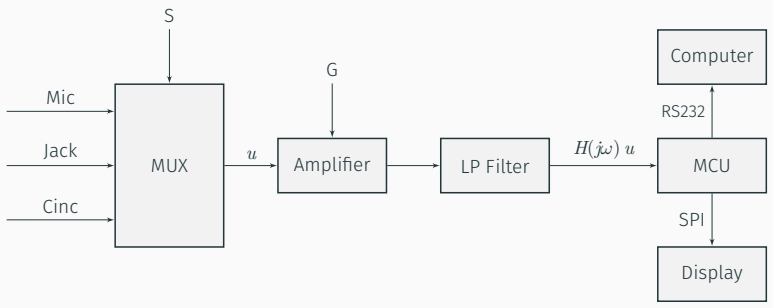
[picture p30: figure]
MUX; Amplifier; LP Filter; MCU; Display; Computer; Mic; Jack; Cinc; SPI

## Fourier Transform

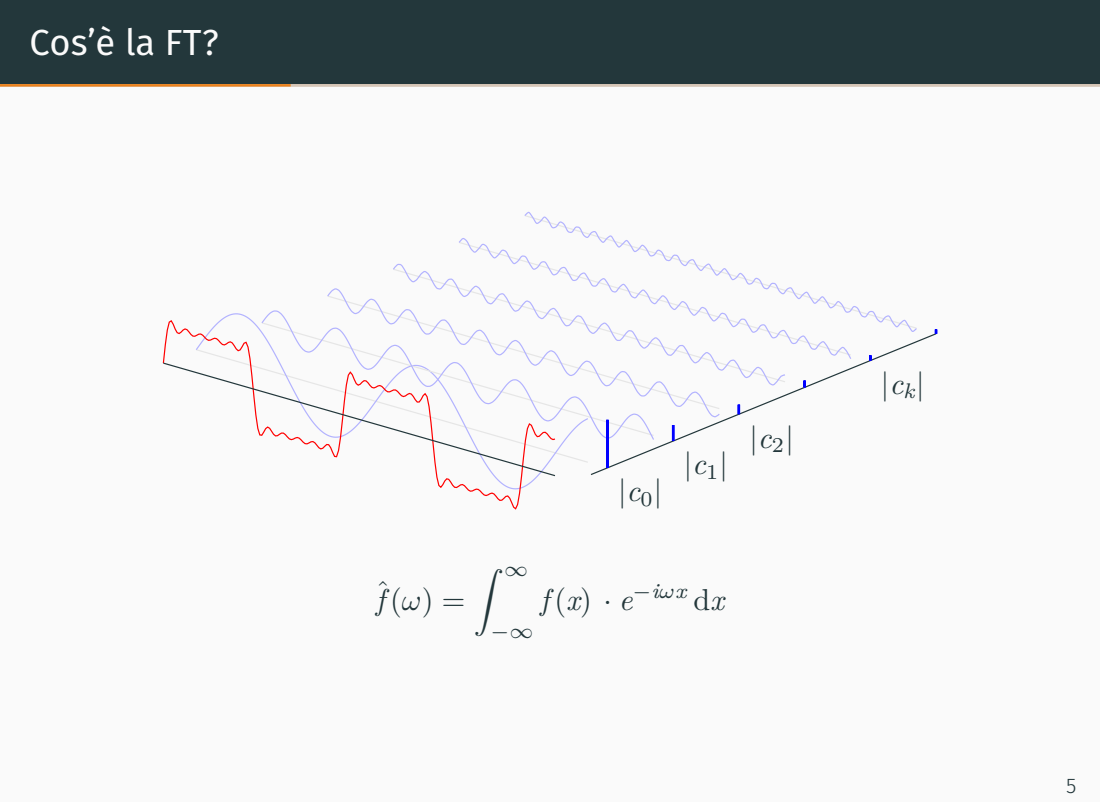
[picture p31: page 9]
−iωx dx

Cos’è la FT?

## Fast Fourier Transform radix-2

### Il problema della DFT

La trasformata di Fourier discreta è

X⃗ = V · ⃗xn

In cui

V =

1 | 1 | 1 | . . . | 1
1 | (e
| iω)

−1
(e
| | iω)

−2
. . . (e

iω)

| | | | −(N−1)
1 | (e
| iω)

−2
(e
| | iω)

−4
. . . (e

iω)

| | | | −2(N−1)

1 (e

iω)

| −(N−1)
(e

iω)

| | −2(N−1)
. . . | (e

iω)

| | | | −(N−1)

2

### Complessità temporale (analisi asintotica)

Definizione
In informatica, la complessità temporale di un algoritmo quantifica la quantità di tempo impiegata da un algoritmo a essere eseguito.

### Complessità temporale (analisi asintotica)

Definizione
In informatica, la complessità temporale di un algoritmo quantifica la quantità di tempo impiegata da un algoritmo a essere eseguito.

Descrivendo il prodotto nelle componenti

Xk =

N

∑−1

n=0

xn · e

−i2πkn/N 0 ≤ k < N

Osserviamo che la complessità temporale è O(N²

).

### Complessità temporale (analisi asintotica)

Definizione
In informatica, la complessità temporale di un algoritmo quantifica la quantità di tempo impiegata da un algoritmo a essere eseguito.

Descrivendo il prodotto nelle componenti

Xk =

N

∑−1

n=0

xn · e

−i2πkn/N 0 ≤ k < N

Osserviamo che la complessità temporale è O(N²

).

## Come si può migliorare?

### Divide et impera (Divide and Conquer)

La FFT appartiene ad una classe di algoritmi chiamata

## Divide et Impera

Definizione
1. Divide il problema in sottoproblemi
2. Impera (conquista) i sottoproblemi
3. Combina i risultati dei sottoproblemi

### Perché la FFT funziona

1. Divide in sottoproblemi

Danielson-Lanczos Lemma

Xk = Ek + Wk
N · Ok

Twiddle factor Wk
N

e

−i2πk/N

Termini pari Ek

N
∑

/2−1

m=0

x2m · e

−i2πmk/(N/2)

Termini dispari Ok

N
∑

/2−1

m=0

x2m+1 · e

−i2πmk/(N/2)

### Albero di recursione

Ek e Ok sono delle serie di campioni come Xk =⇒ recursione!

Xk

Ek

Ek

Ek Wk
- Ok

Wk
- Ok

Ek Wk
- Ok

Wk
- Ok

Ek

Ek Wk
- Ok

Wk
- Ok

Ek Wk
- Ok

log2 N

### Albero di recursione

Ek e Ok sono delle serie di campioni come Xk =⇒ recursione!

Xk

Ek

Ek

Ek Wk
- Ok

Wk
- Ok

Ek Wk
- Ok

Wk
- Ok

Ek

Ek Wk
- Ok

Wk
- Ok

Ek Wk
- Ok

log2 N

Ogni foglia risulta essere: Wk
a
- Wk
b
- Wk
c

. . . Wk
1
| {z }
Dipende dalla strada
- x m

### Perché la FFT funziona

2. Impera i sottoproblemi

Ogni coppia di foglie risulta essere

Ek + Wk
1
- Ok

Ossia
Wk

. . . Wk
| {z }
Strada

·xm + Wk

. . . Wk
| {z }
Strada

·Wk
1
- xn

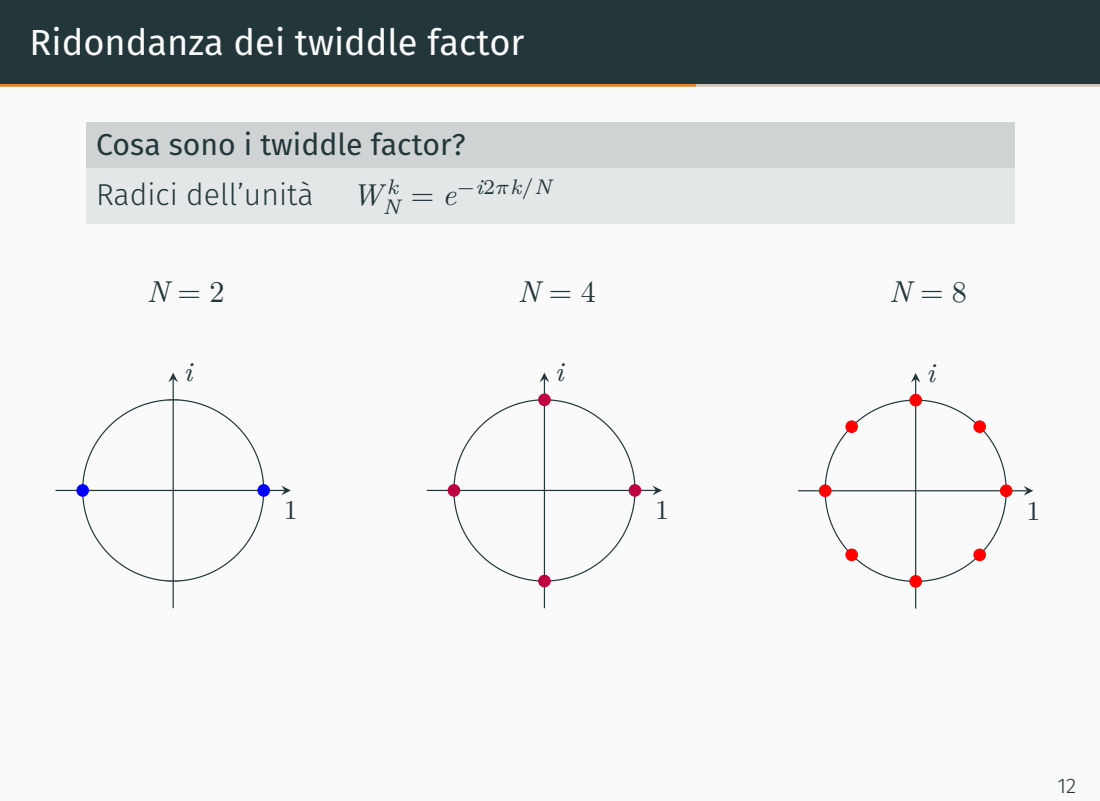
[picture p32: page 20]

Ridondanza dei twiddle factor

Cosa sono i twiddle factor?
Radici dell’unità Wk

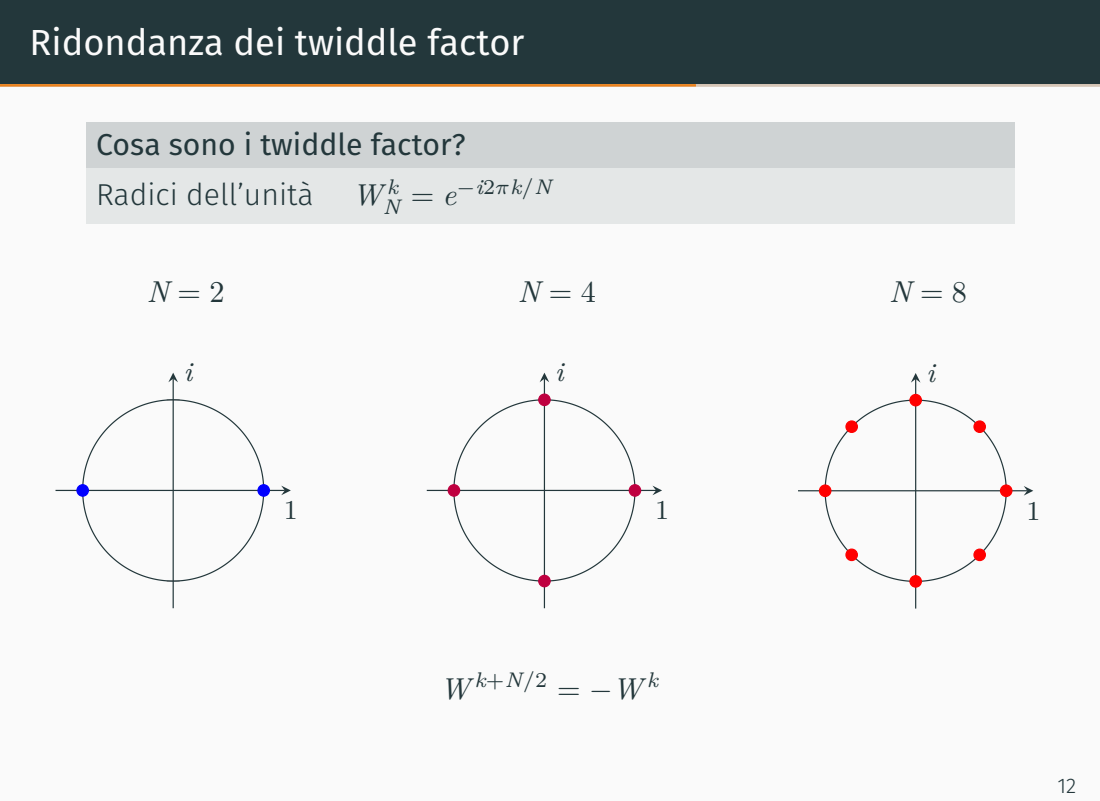
[picture p33: page 21]

Ridondanza dei twiddle factor

Cosa sono i twiddle factor?
Radici dell’unità Wk

### Perché la FFT funziona

3. Combina i risultati

Ciò significa che ad ogni livello di recursione si può trovare

Xk = Ek + Wk
- Ok

Xk+N/2 = Ek − Wk
- Ok

Con l’analisi asintotitica si osserva che la complessità temporale è

O(N · log2

(N ))

### Performance

0 | 100 | 200 | 300 | 400 | 500

0

1

2

·10⁵

Campioni N

Operazioni

O(n

2
)
O(n · log2

(n))
O(n)

## Prodotto realizzato

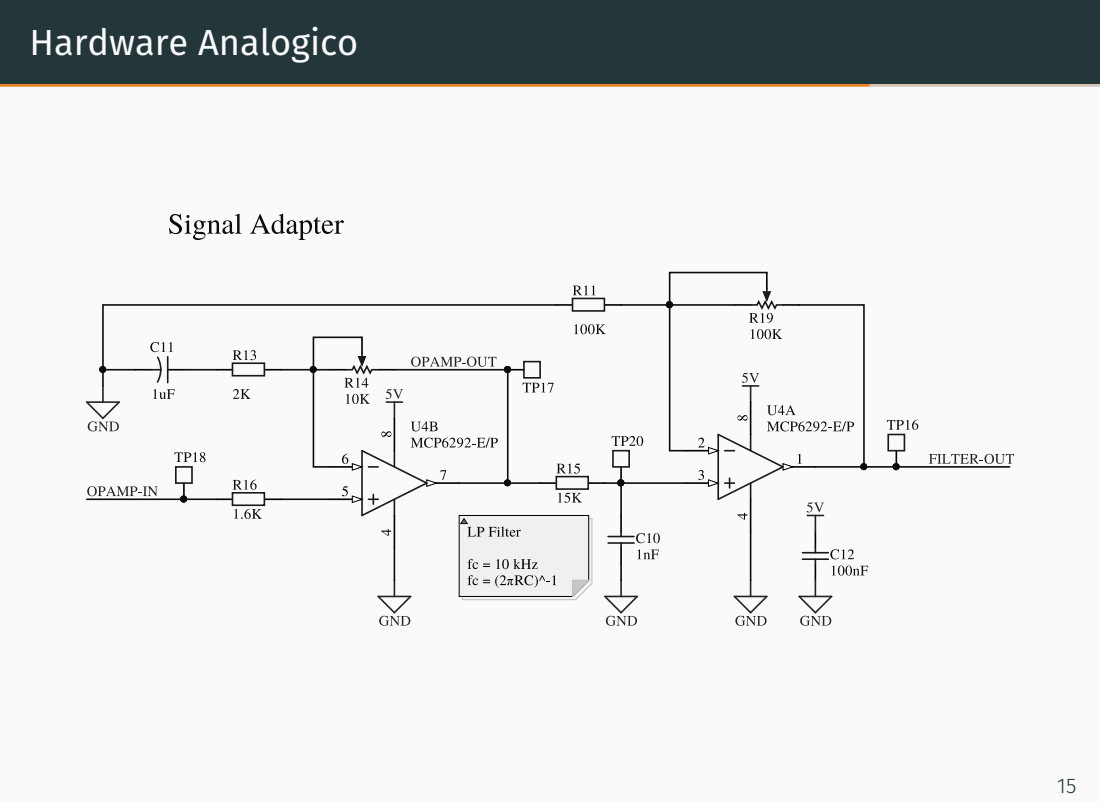
[picture p34: page 25]
Hardware Analogico

### FFT Software

L’implementazione utilizzata si chiama

## Fixed-Point In-Place FFT

Fixed-Point Il numero di bit per la mantissa e per l’esponente del valore floating point sono costanti In-Place I risultati sovrascrivono i dati di partenza
FFT Fast Fourier Transform

### Software


# Demo!

## Conclusioni

### Obiettivi

Raggiungi
- Analisi spettrale fino a 10 kHz
- Visualizzazione al PC†
- Esportare immagini / dati

### Obiettivi

Raggiungi
- Analisi spettrale fino a 10 kHz
- Visualizzazione al PC†
- Esportare immagini / dati

Incompleti

•

† Visualizzazione delle curve ℜ(z) e ℑ(z) in un solo grafico
- Visualizzazione mediante la matrice LED

### Conclusioni

Possibili sviluppi futuri
- Supporto multipiattaforma
- Cronologia spettrale

### Conclusioni

Possibili sviluppi futuri
- Supporto multipiattaforma
- Cronologia spettrale

## Grazie per l’attenzione
