NaoPross/SAMSpectrumAnalyzer/doc/figures/screenshots/desktop-exported-sine-wave-img.pdf

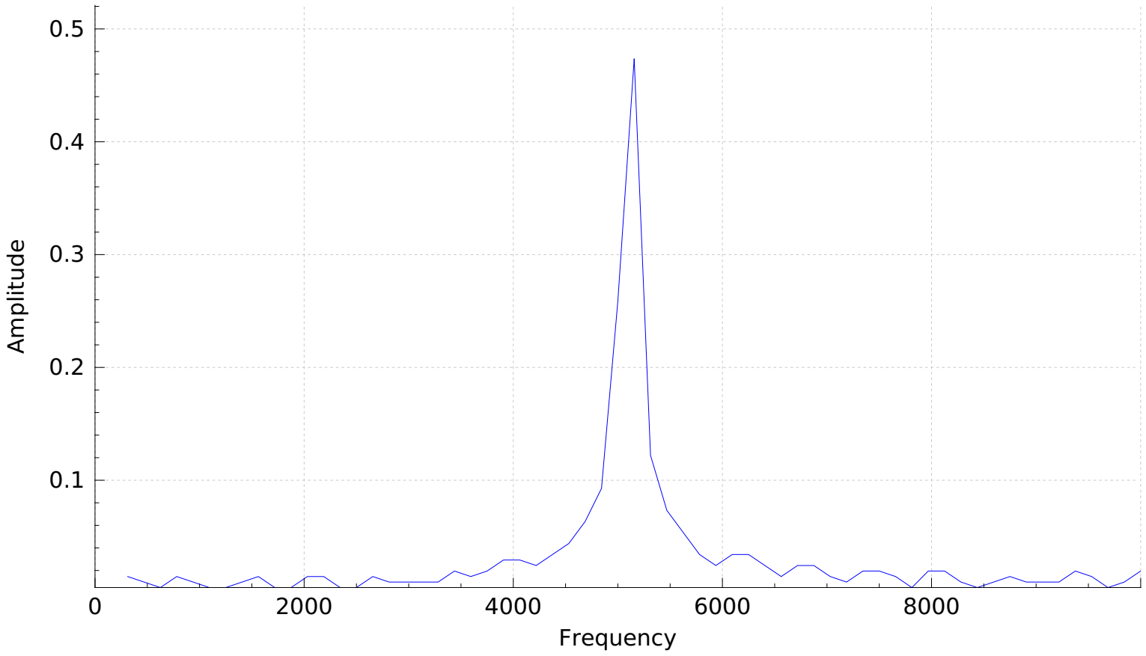
[picture p35: figure]
Frequency; plitu
