NaoPross/SAMSpectrumAnalyzer/doc/figures/uml/desktop-sequence.pdf

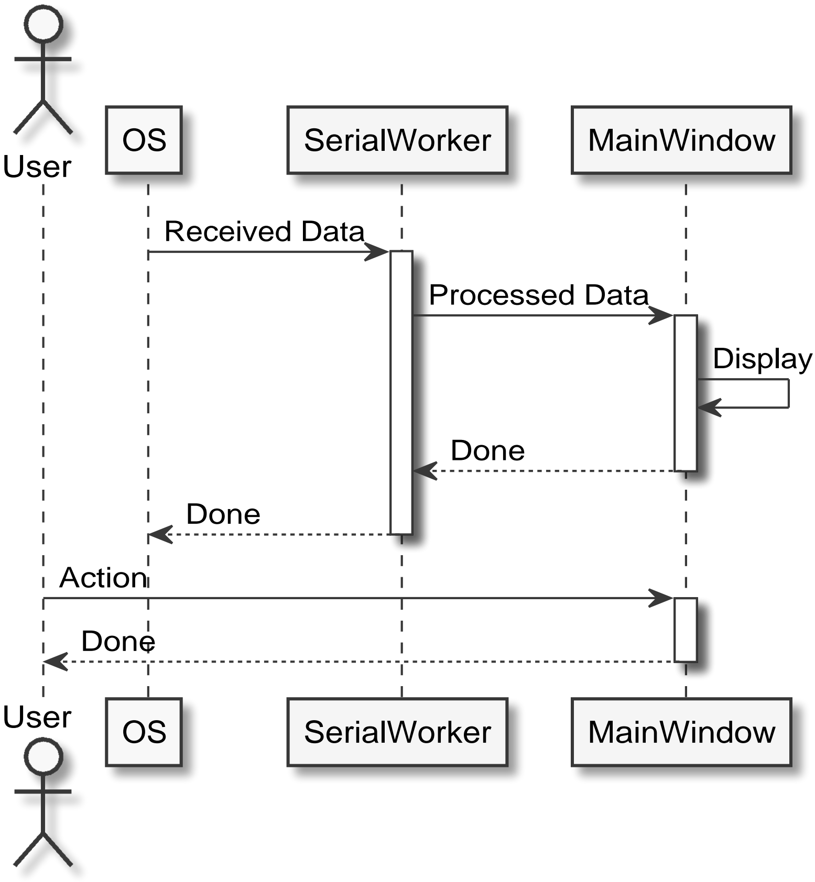
[picture p36: page 1]

User

User

OS

OS

SerialWorker

SerialWorker

MainWindow

MainWindow

Received Data

Processed Data

Display

Done

Done

Action

Done
