NaoPross/SAMSpectrumAnalyzer/doc/figures/logo/LOGO_SAM.pdf

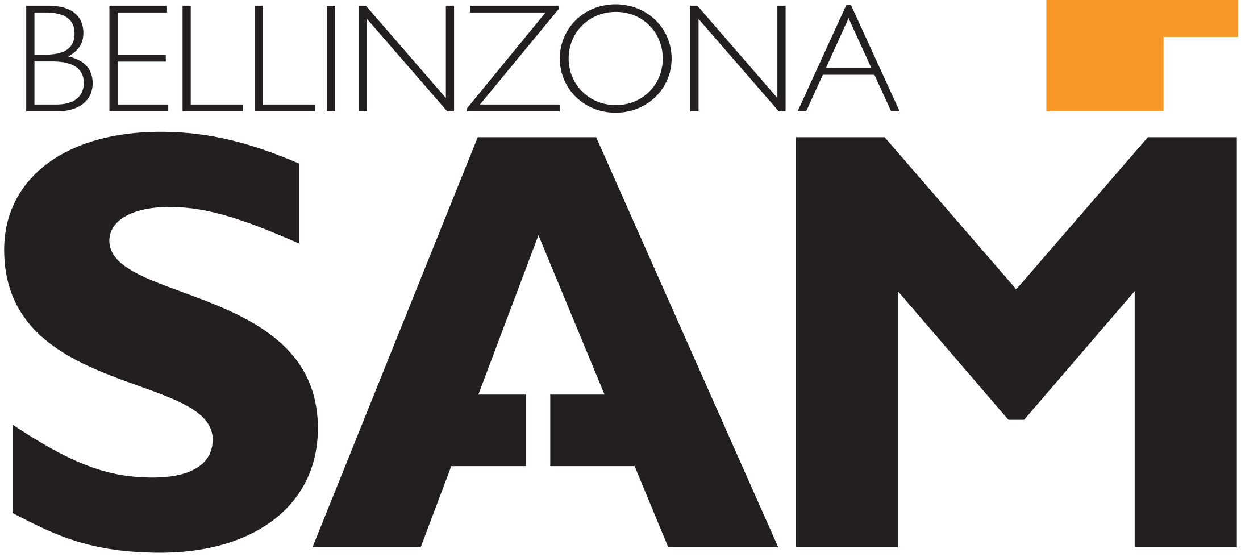
[picture p37: figure]
