NaoPross/SAMSpectrumAnalyzer/doc/figures/plots/fourier-transform-polar.png

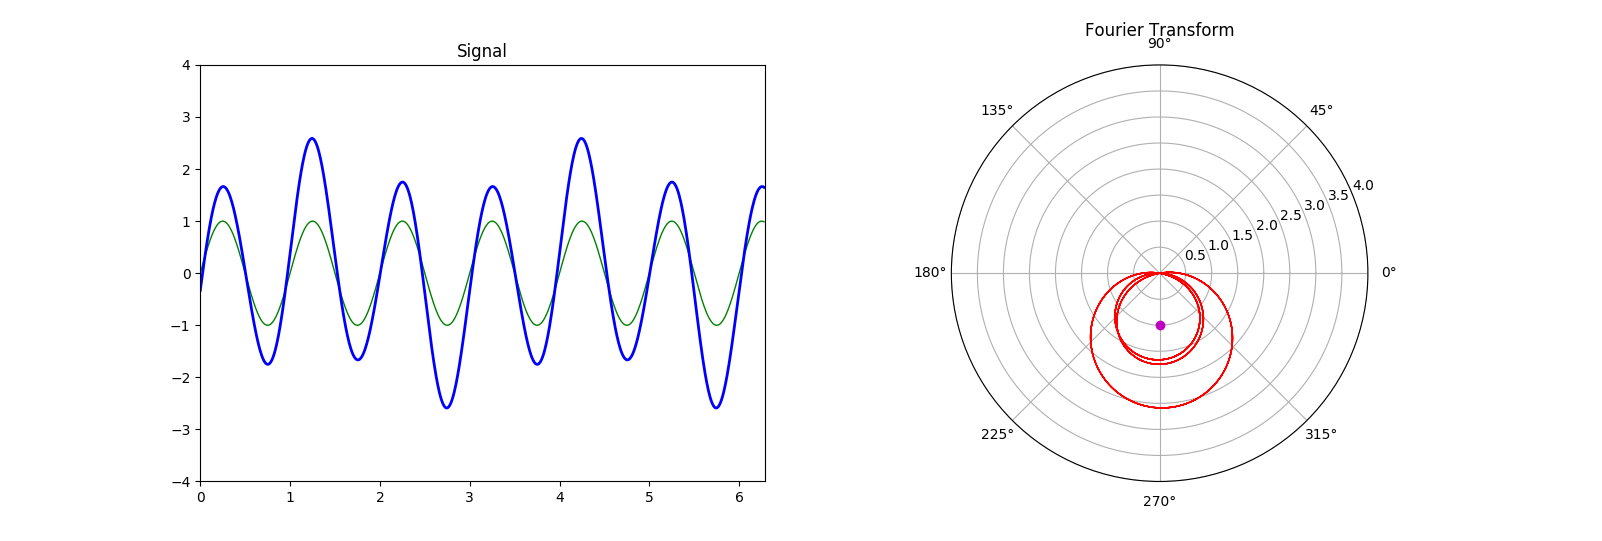
doc/figures/plots/fourier-transform-polar.png
