NaoPross/SAMSpectrumAnalyzer/doc/figures/screenshots/desktop-debian-empty.png

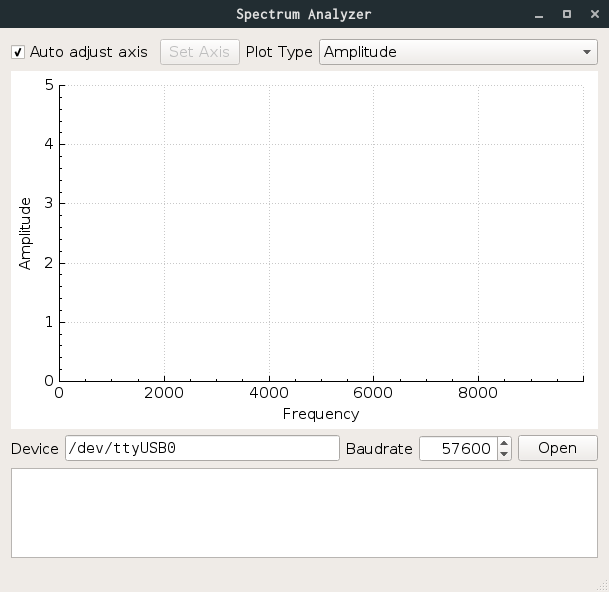
doc/figures/screenshots/desktop-debian-empty.png
