NaoPross/SAMSpectrumAnalyzer/doc/figures/screenshots/desktop-fedora-empty.png

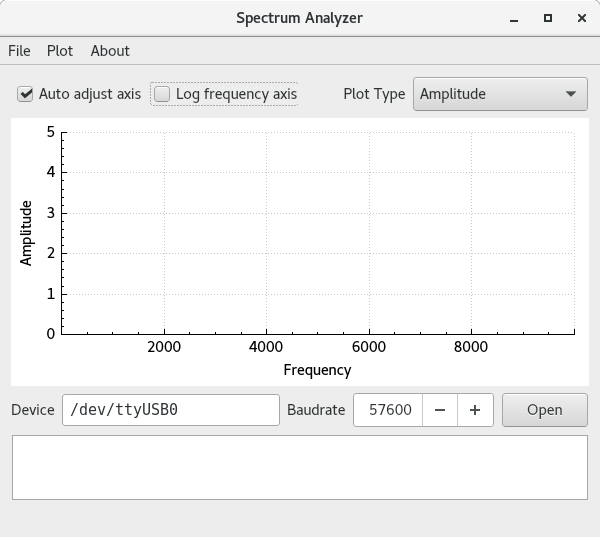
doc/figures/screenshots/desktop-fedora-empty.png
