NaoPross/SAMSpectrumAnalyzer/doc/figures/screenshots/desktop-fedora-square.png

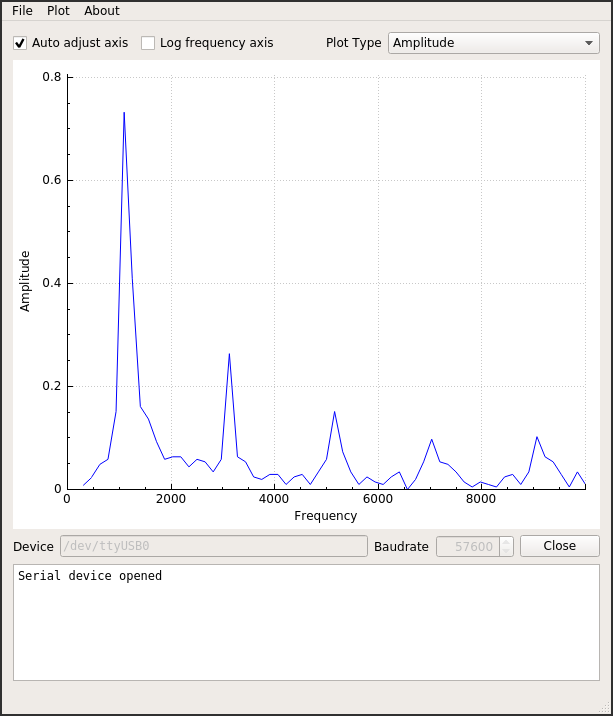
doc/figures/screenshots/desktop-fedora-square.png
