NaoPross/SAMSpectrumAnalyzer/doc/BOM.xlsx

Lista Componenti Spectrum Analyzer
Naoki Pross 4E
SAM Bellinzona
Componente | Nome | Produttore | Fornitore | RefNum | Quantità | Prezzo /u | Prezzo
Microcontroller | PIC18F45K22 | Microchip | SAMB | - | 1 | fr.0.00 | fr.0.00
Matrice Led (Display) | DE-DP14112V201 | Sure Electronics | SAMB | - | 1 | fr.0.00 | fr.0.00
Multiplexer Analogico | CD4051 | Texas Instruments | Distrelec | 173-47-370 | 1 | fr.0.72 | fr.0.72
Presa Jack | - | - | SAMB | - | 2 | fr.0.00 | fr.0.00
Presa Cinch / RCA | 1553 02 Schwarz | Lumberg Connect GmbH | Distrelec | 300-68-375 | 1 | fr.1.47 | fr.1.47
Amplificatore Operazionale | AD826AN | Analog Devices | Distrelec | 173-22-437 | 1 | fr.8.90 | fr.8.90
Push Button | - | - | SAMB | - | 1 | fr.0.00 | fr.0.00
Male Header | - | - | SAMB | - | 1 | fr.0.00 | fr.0.00
Connettore RJ11 | - | - | SAMB | - | 1 | fr.0.00 | fr.0.00
LED | - | - | SAMB | - | 3 | fr.0.00 | fr.0.00
Resistenza | - | - | SAMB | - | 4 | fr.0.00 | fr.0.00
Condensatore | - | - | SAMB | - |  | fr.0.00 | fr.0.00
 |  |  |  |  |  | Totale: | fr.11.09
