NaoPross/SAMSpectrumAnalyzer/doc/res/schematic-v2.pdf

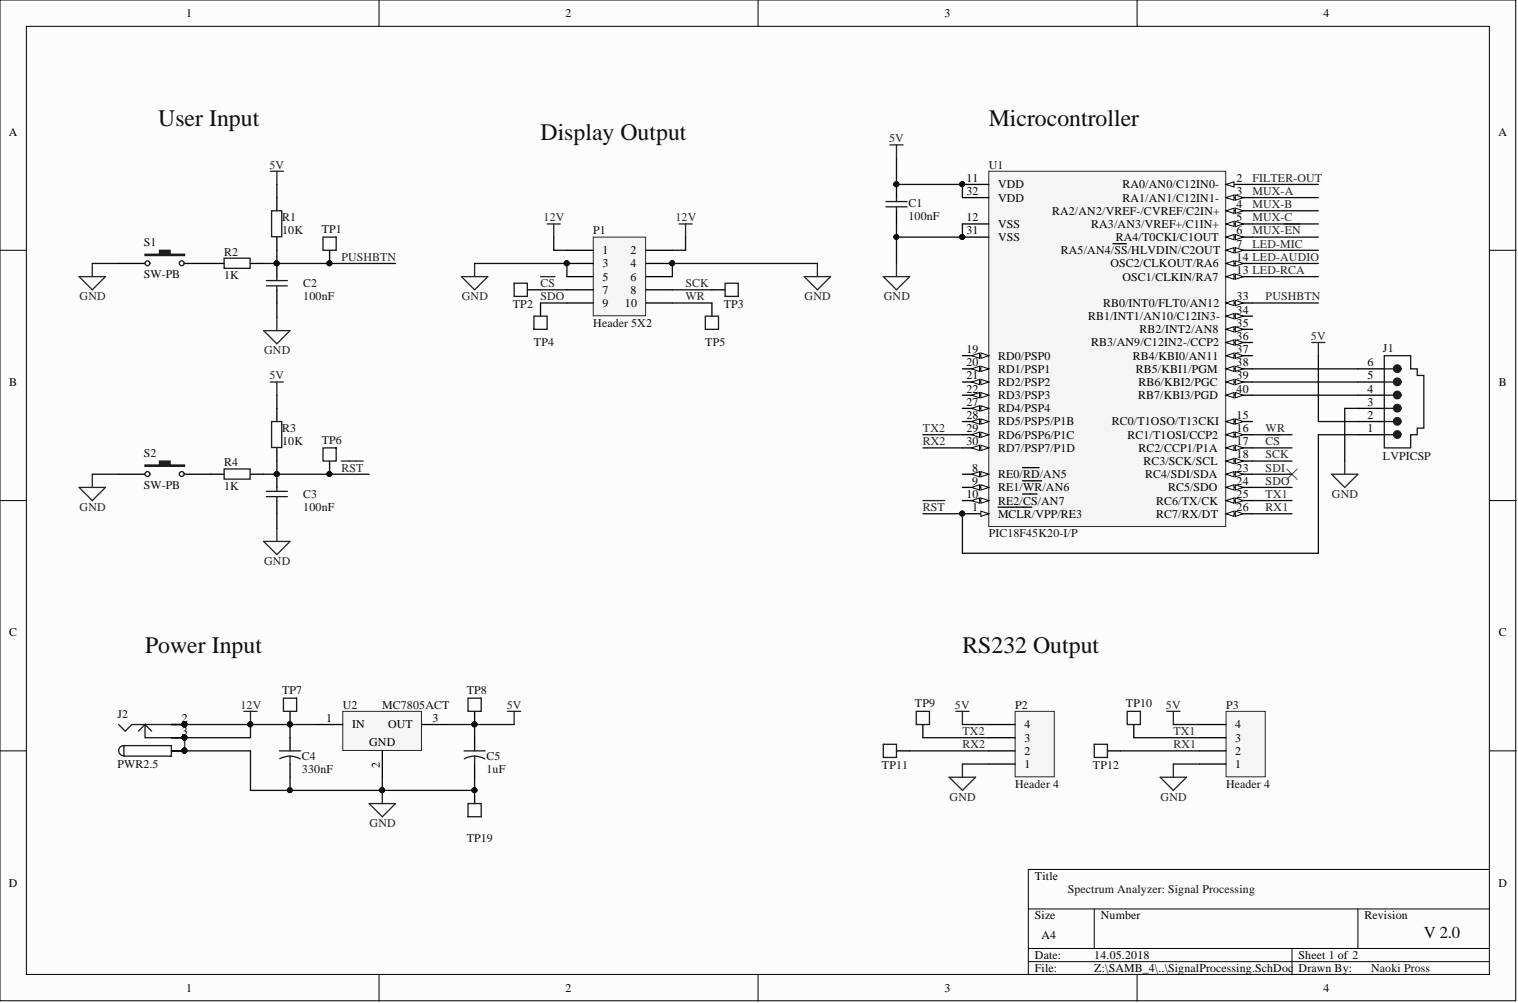
[picture p42: page 1]

Microcontroller Display Output User Input

Title
Spectrum Analyzer: Signal Processing

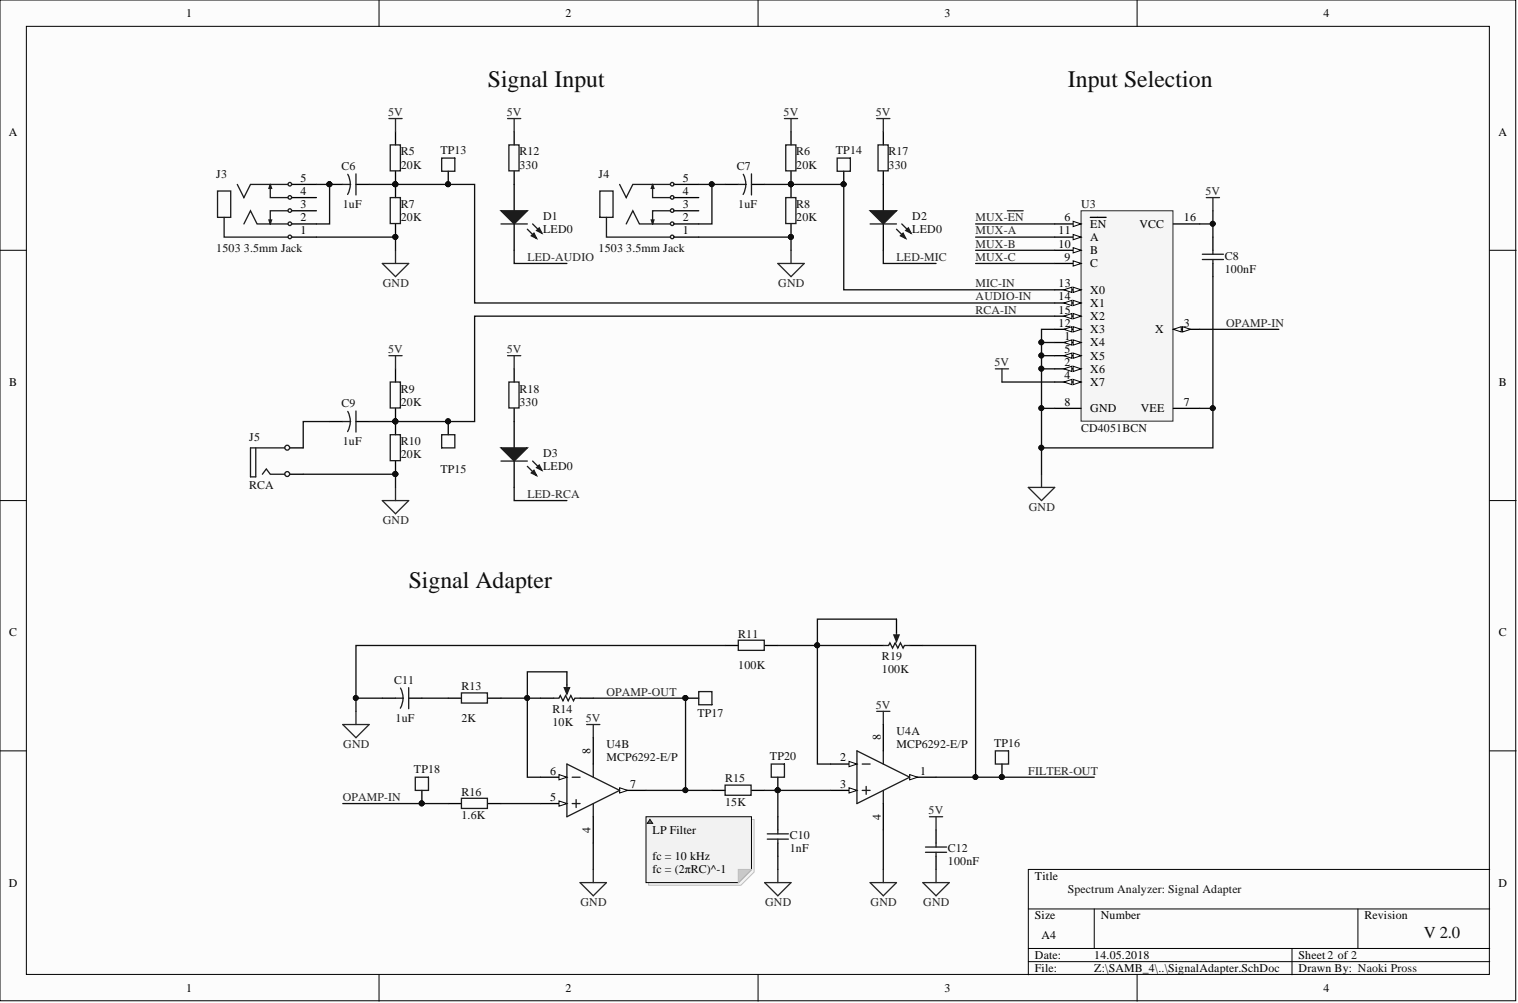
[picture p43: page 2]

Title
Spectrum Analyzer: Signal Adapter
