NaoPross/SAMSpectrumAnalyzer/hw/Project Outputs for SpectrumAnalyer/PCB_Data.PDF

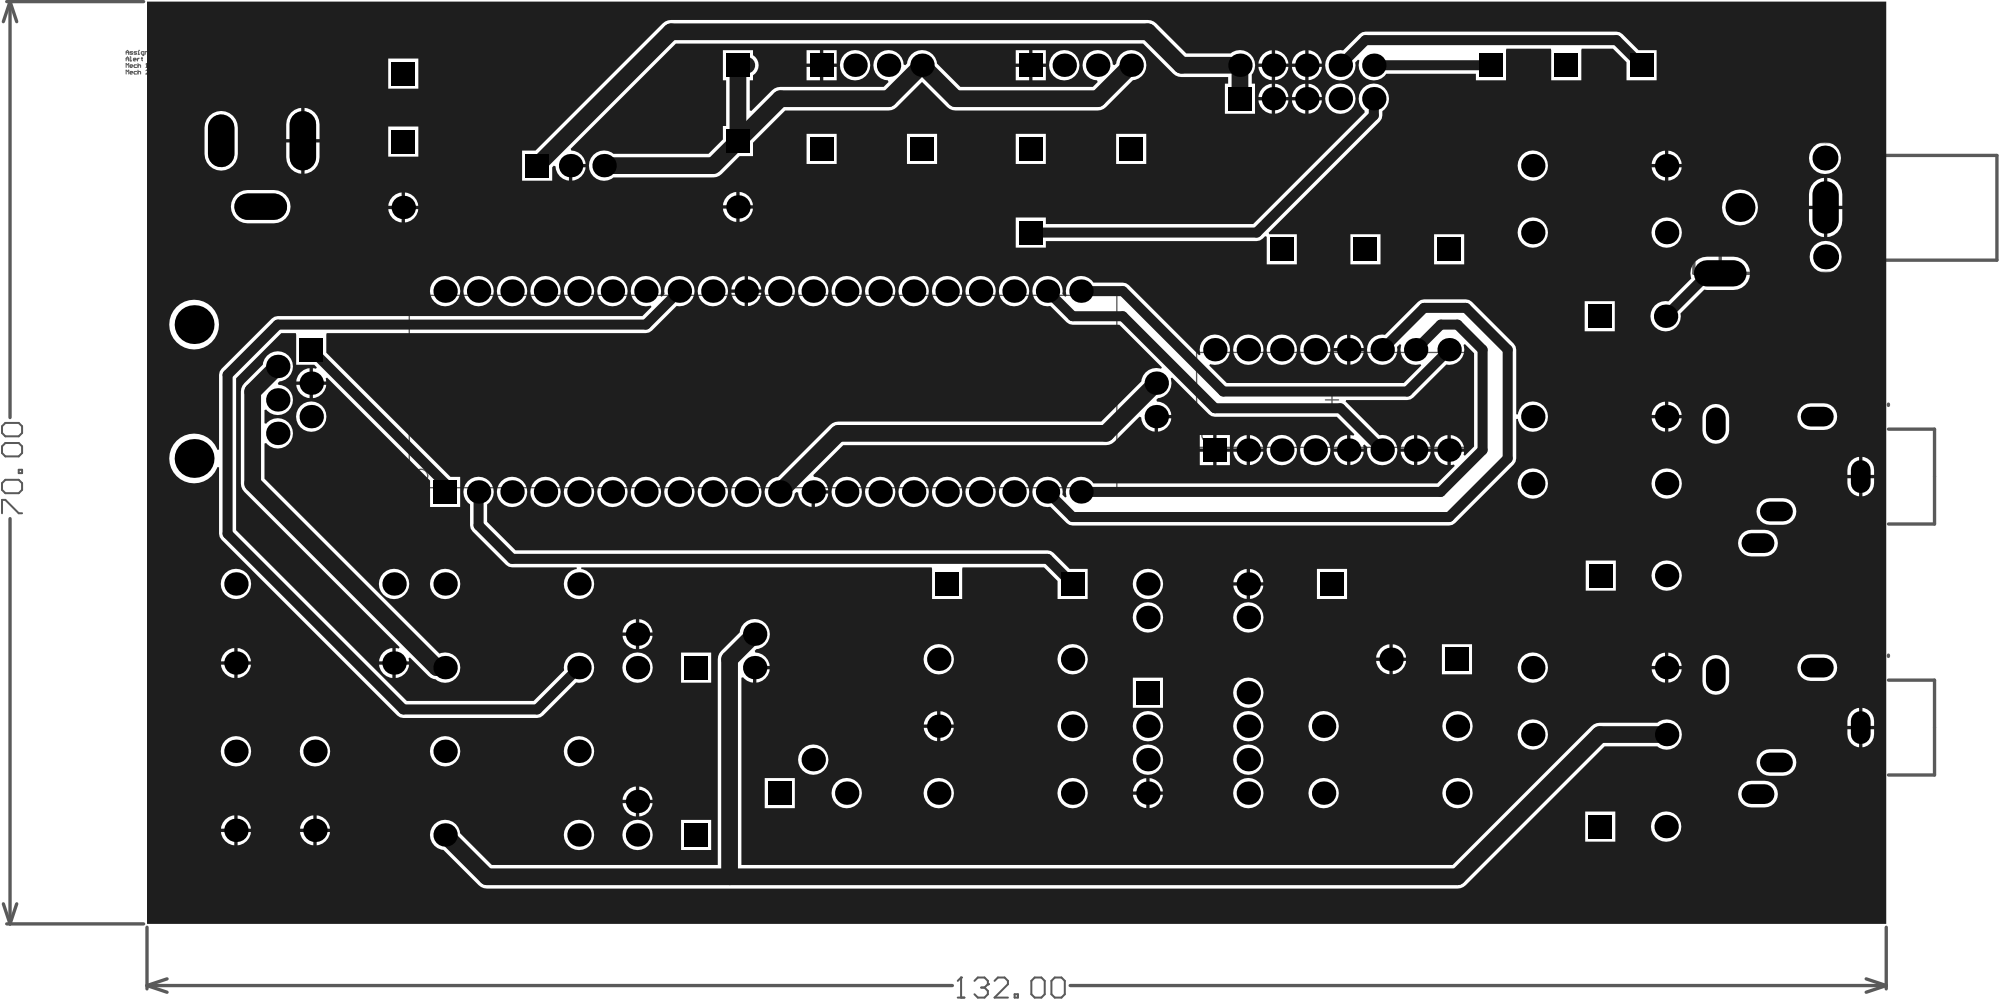
[picture p44: page 1]

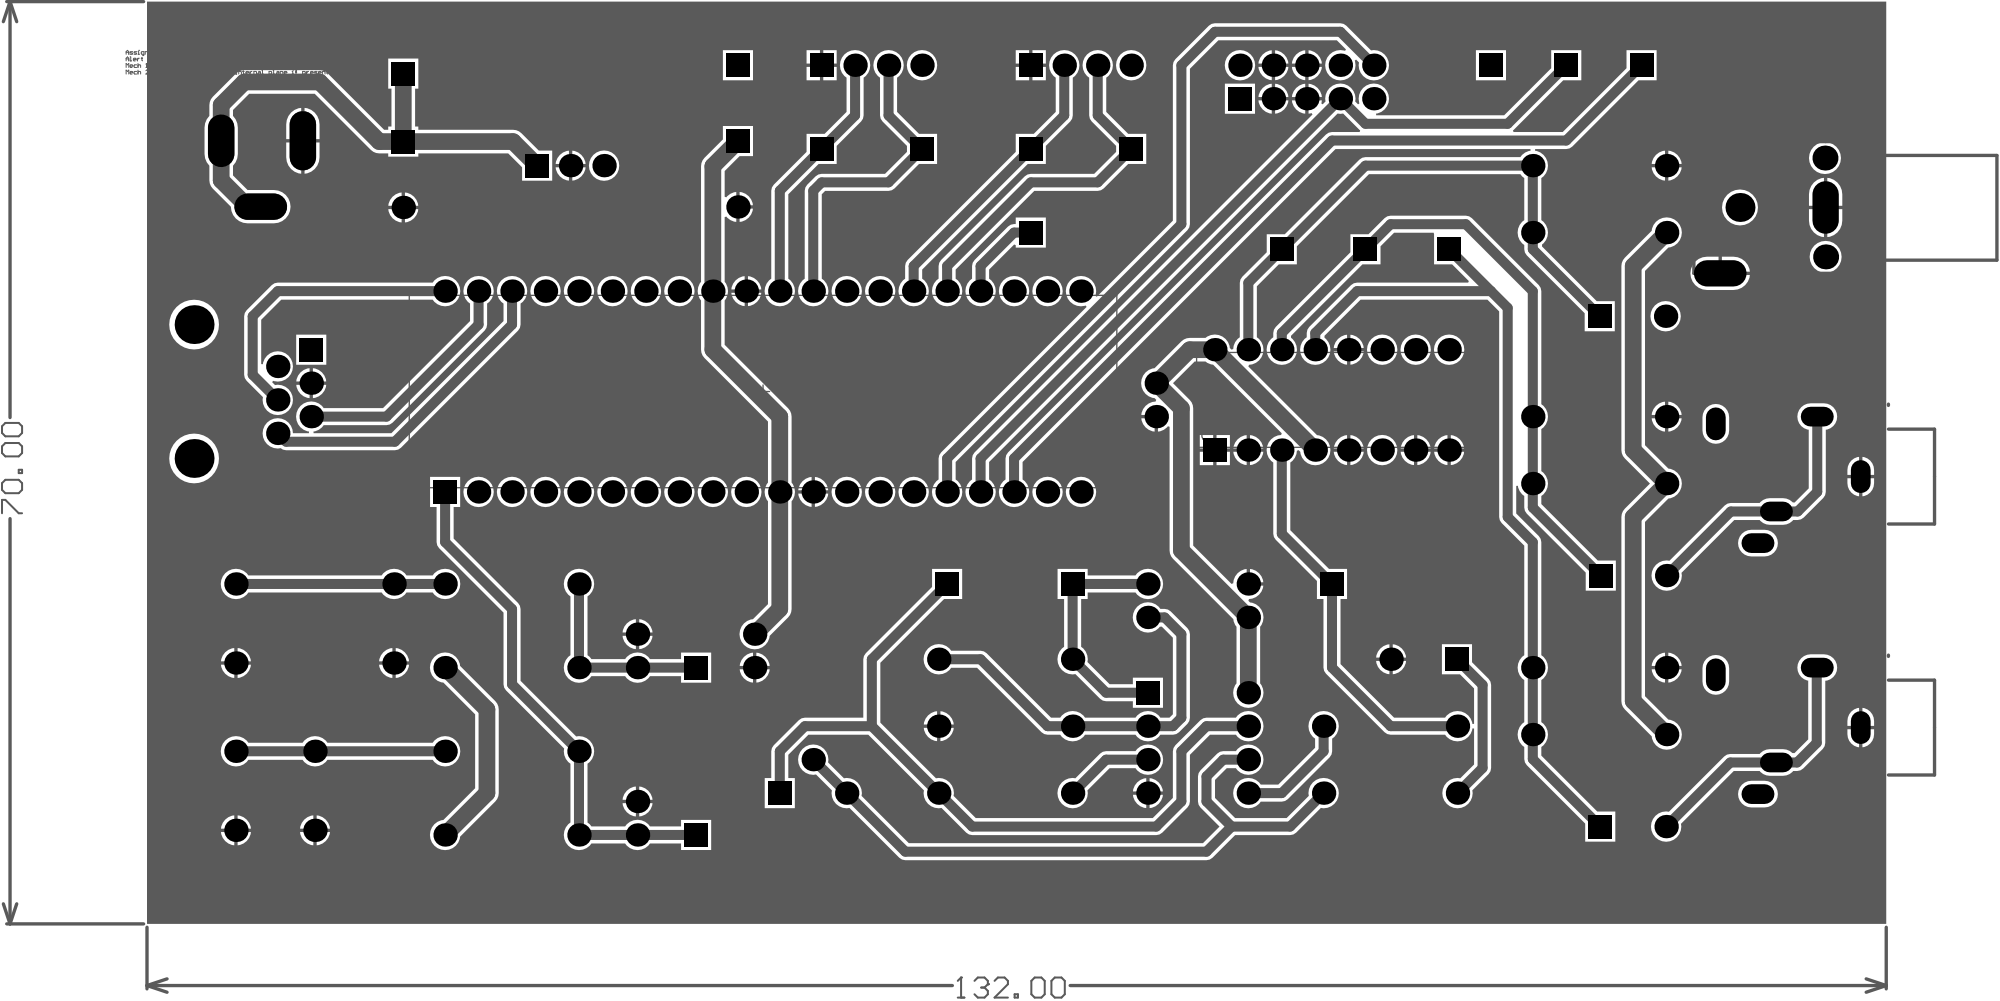
[picture p45: page 2]

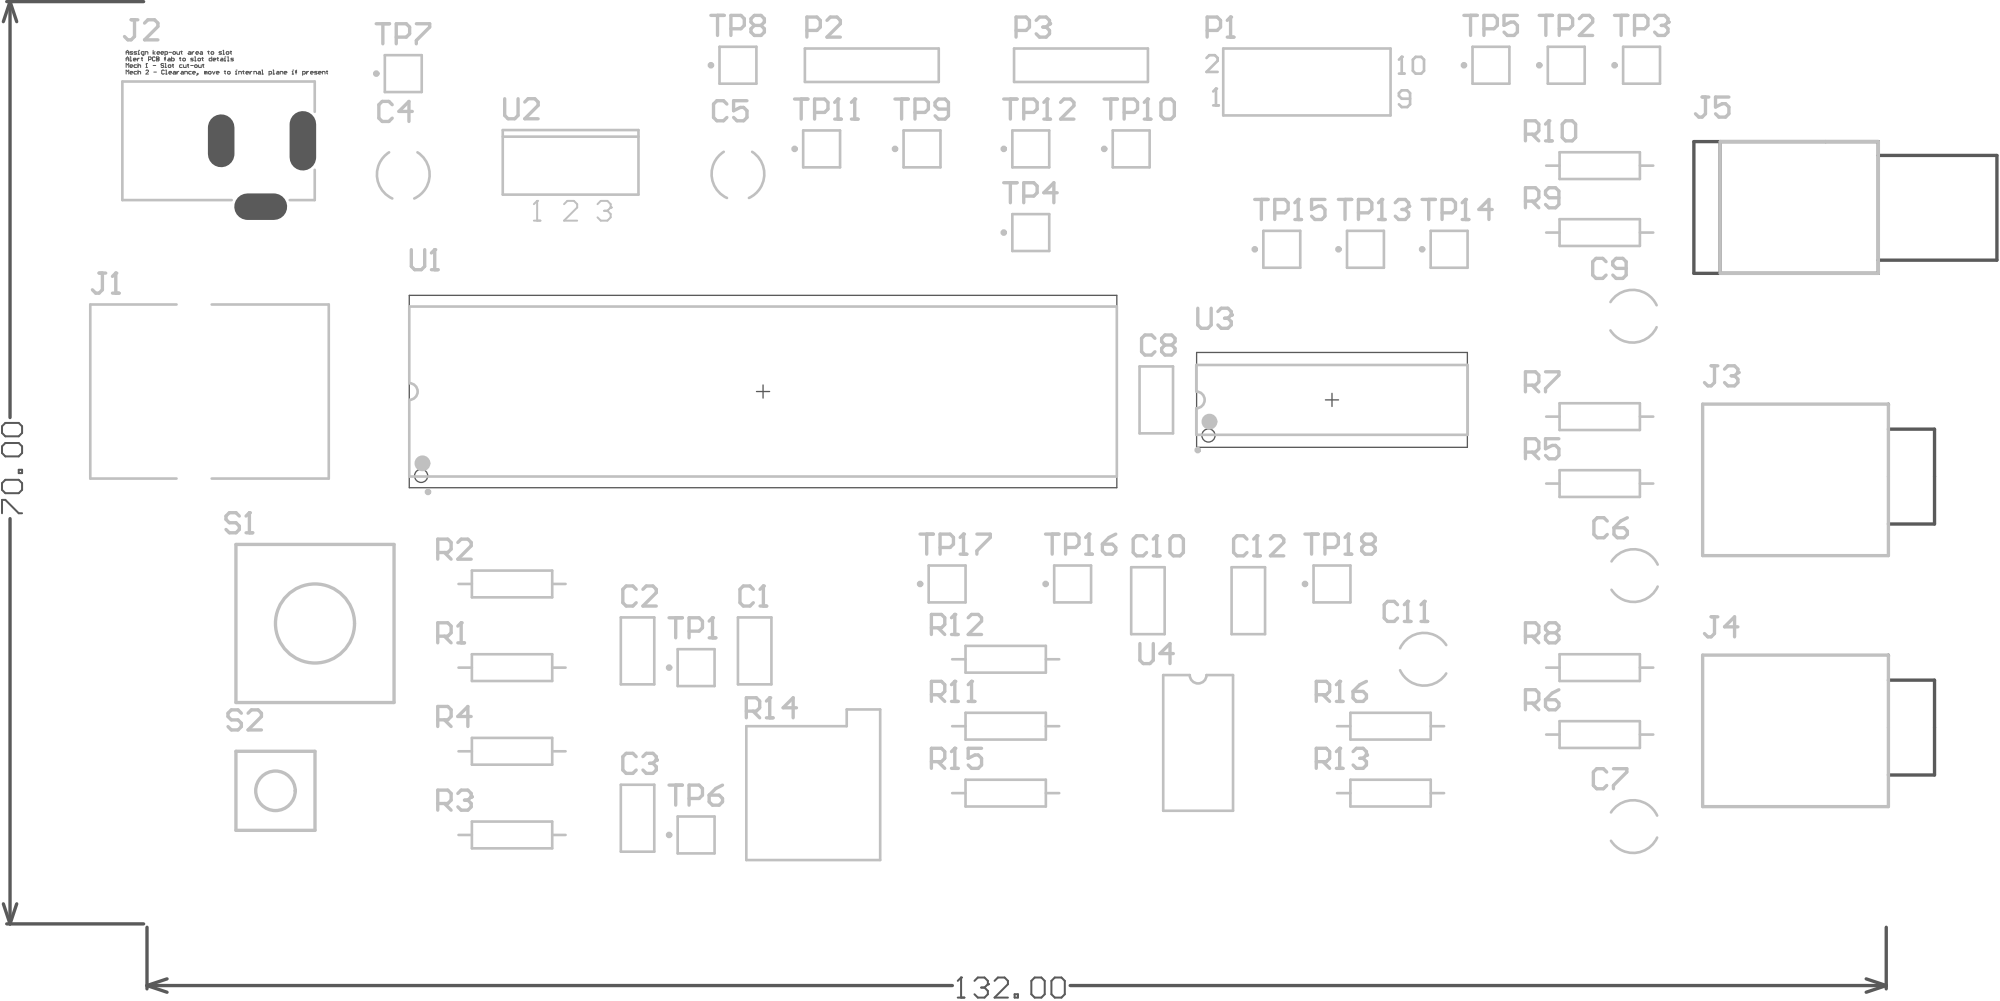
[picture p46: page 3]

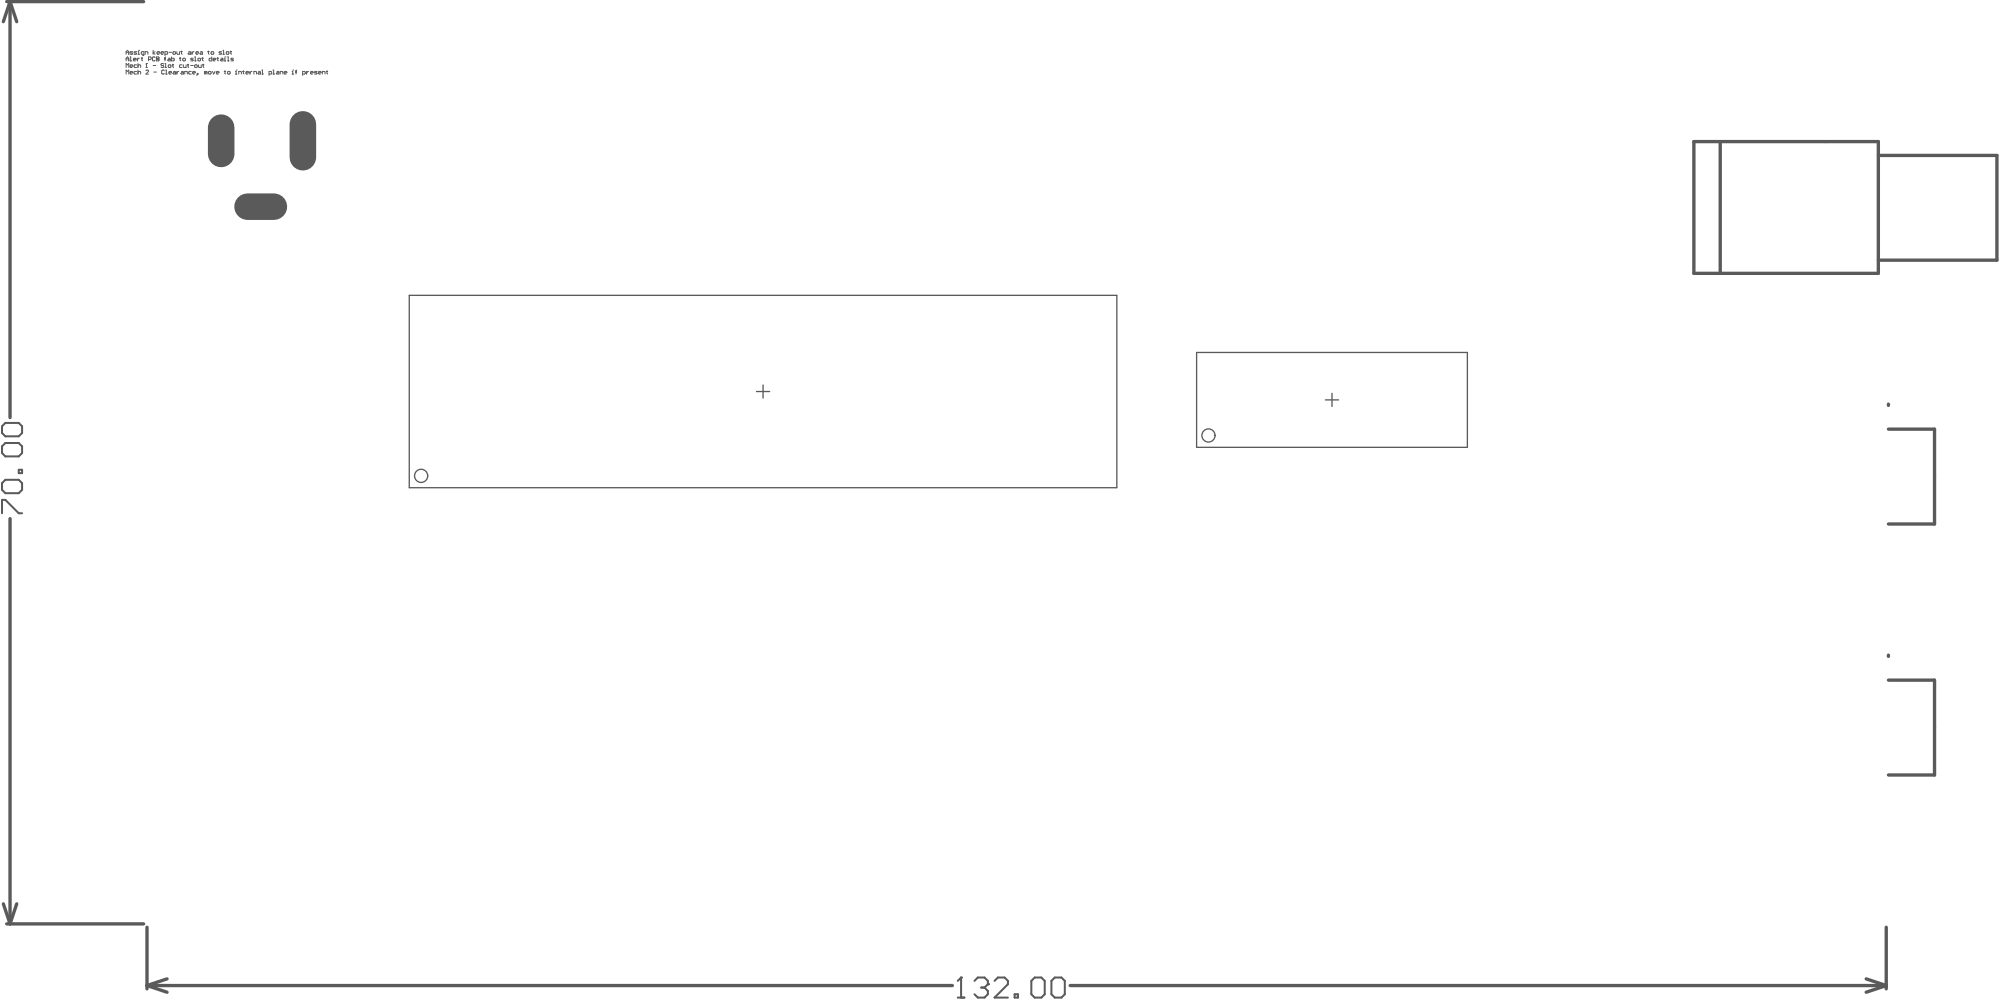
[picture p47: page 4]

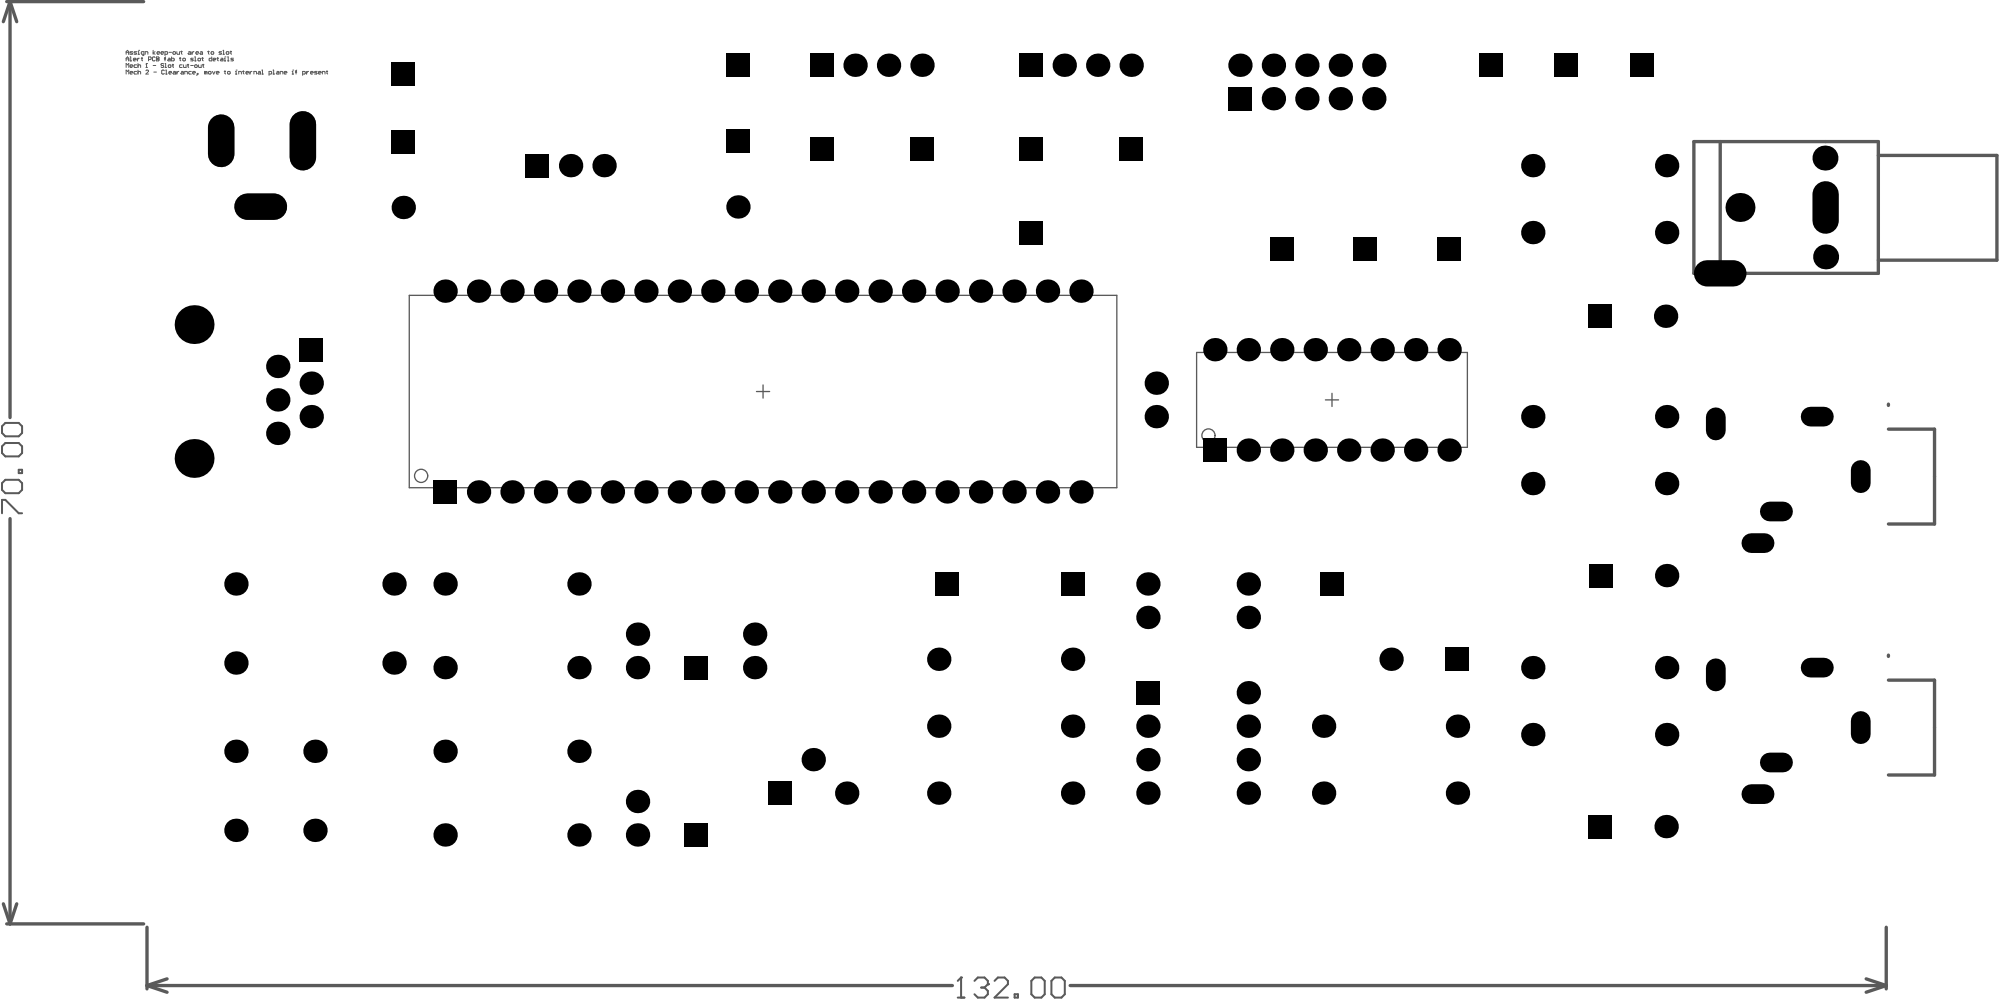
[picture p48: page 8]

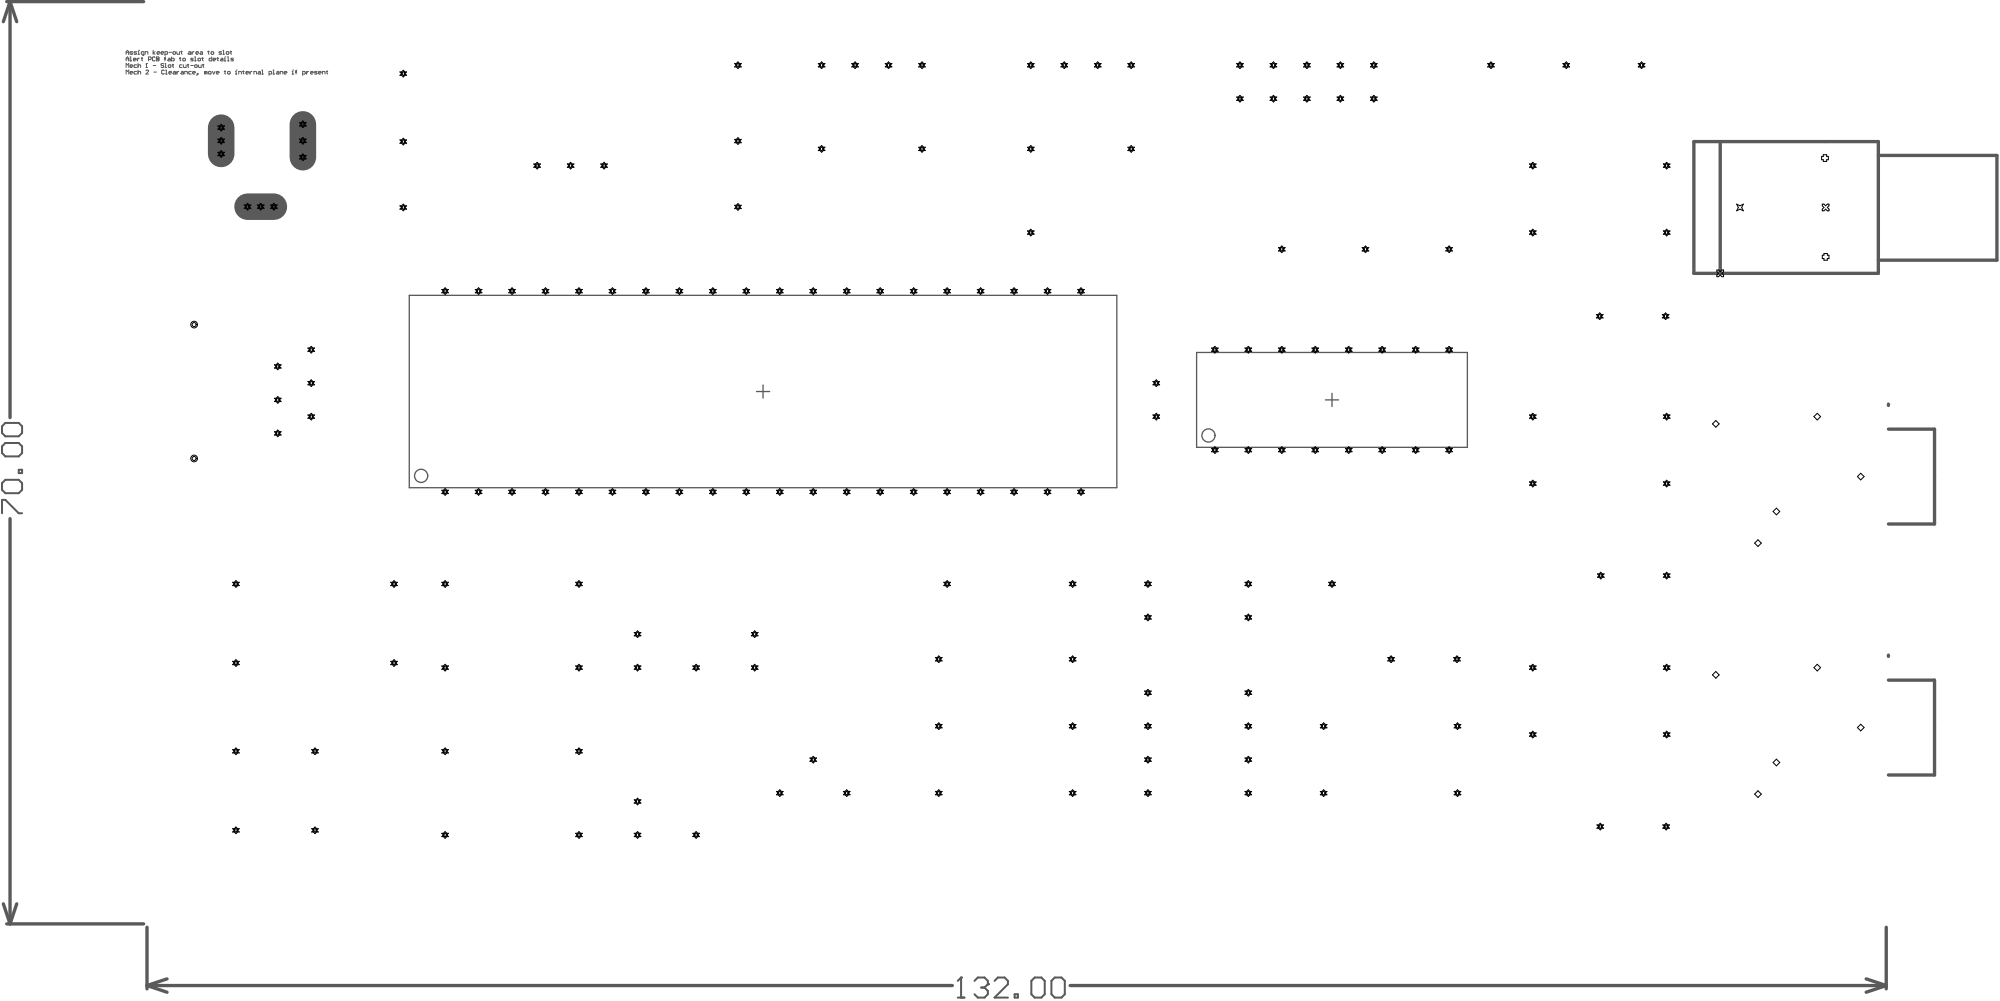
[picture p49: page 10]

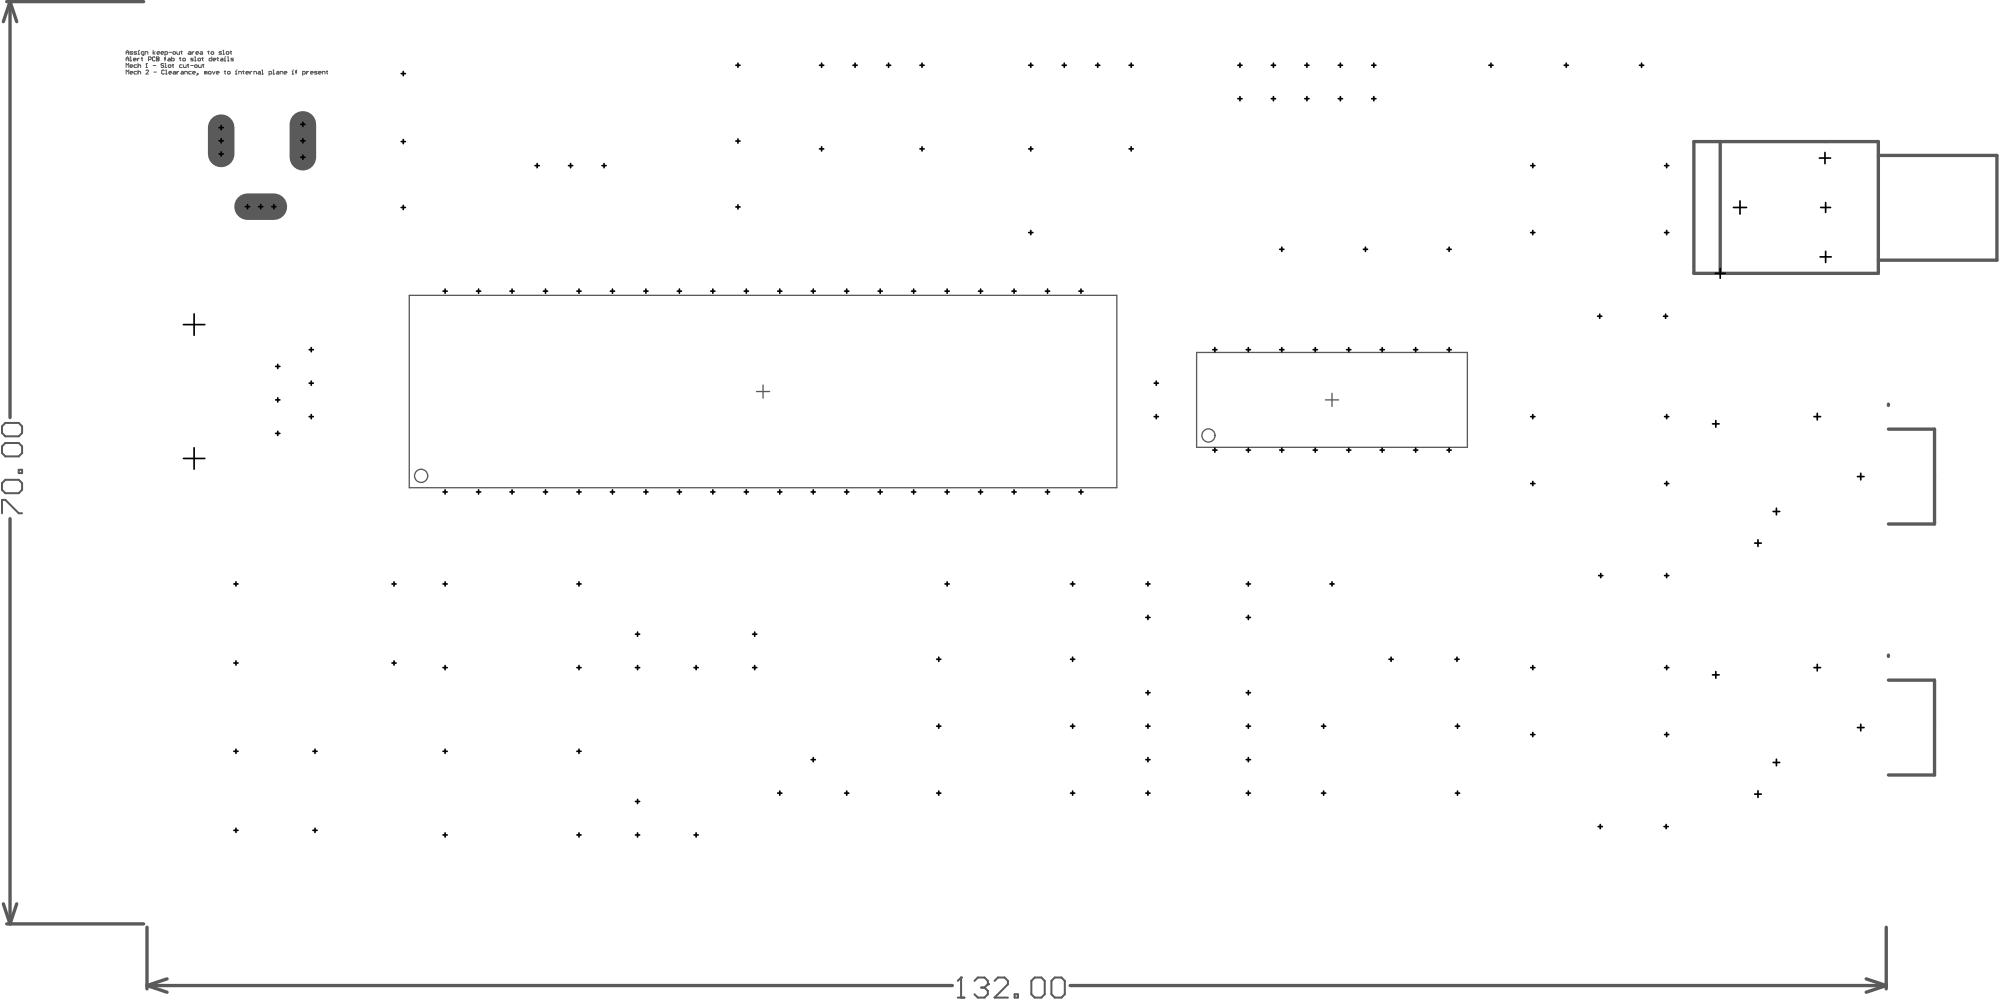
[picture p50: page 11]
