NaoPross/SAMSpectrumAnalyzer/doc/figures/timer2-block-diagram.pdf

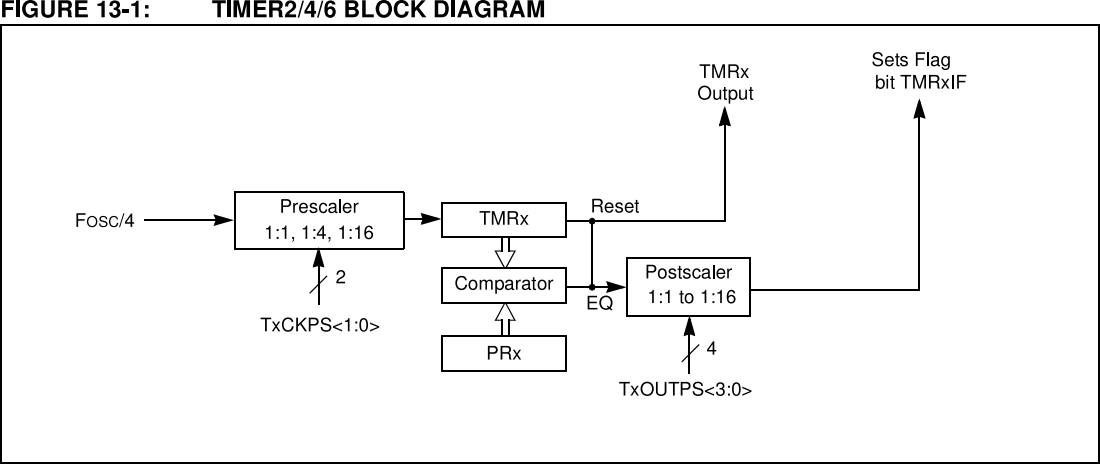
[picture p51: page 1]
