NaoPross/SAMSpectrumAnalyzer/doc/figures/circuits/filter-ampl-v2.pdf

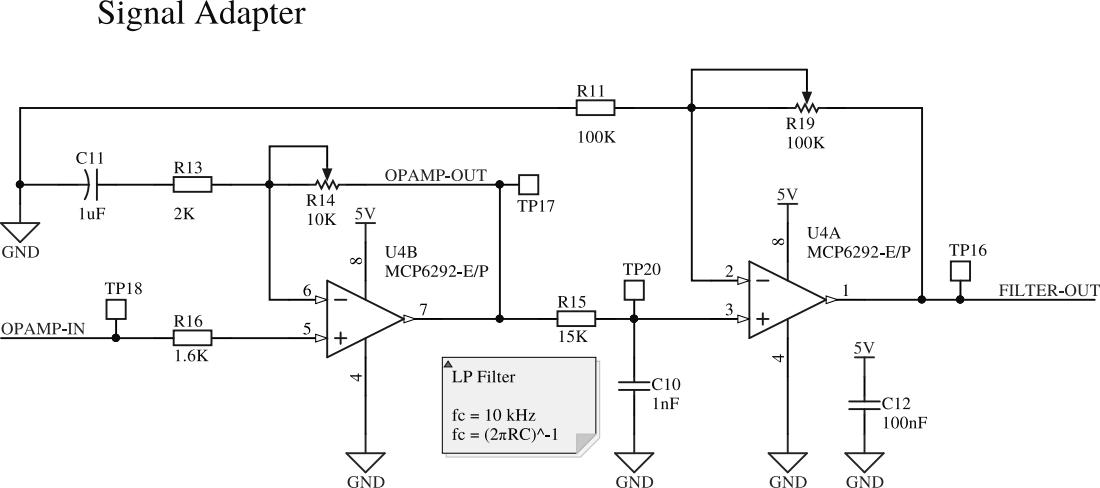
[picture p52: page 1]
