NaoPross/SAMSpectrumAnalyzer/doc/figures/circuits/input-selection-v2.pdf

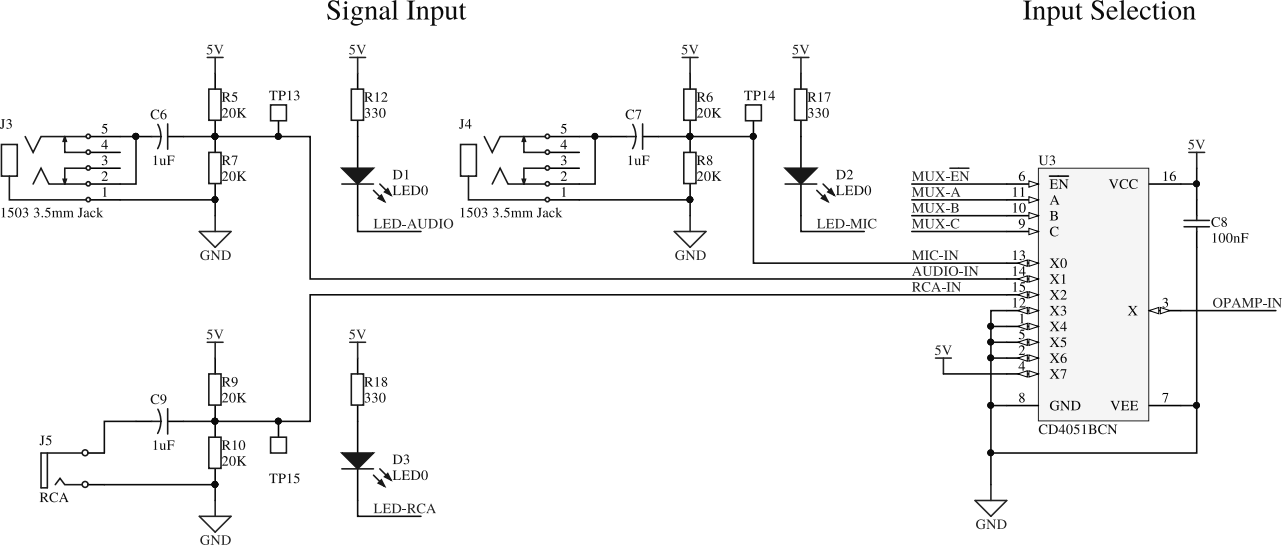
[picture p53: page 1]
