NaoPross/SAMSpectrumAnalyzer/doc/figures/uml/desktop-classes.pdf

## Qt Library

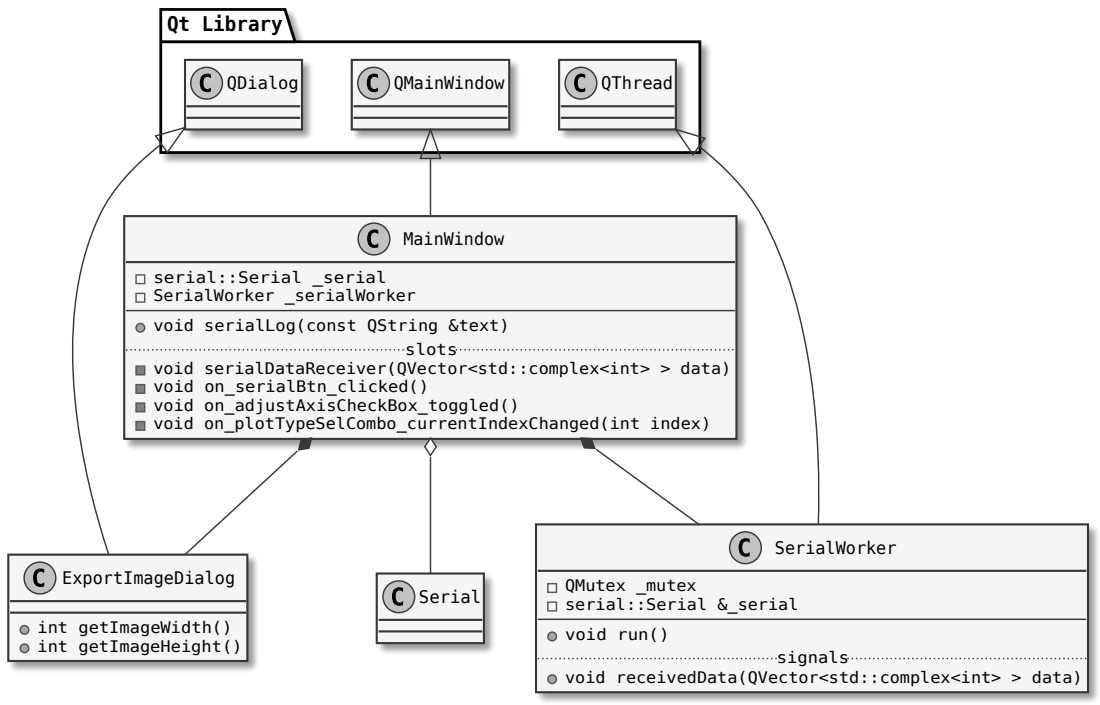
[picture p54: page 1]
QDialog; QMainWindow; QThread; MainWindow; slots; ExportImageDialog; int getImageWidth() int getImageHeight(); SerialWorker; QMutex _mutex serial::Serial &_serial void run(); signals; Serial

serial::Serial _serial
SerialWorker _serialWorker
void serialLog(const QString &text)

void serialDataReceiver(QVector<std::complex<int> > data)
void on_serialBtn_clicked()
void on_adjustAxisCheckBox_toggled()
void on_plotTypeSelCombo_currentIndexChanged(int index)

void receivedData(QVector<std::complex<int> > data)
