NaoPross/SAMSpectrumAnalyzer/doc/res/schematic-v1.pdf

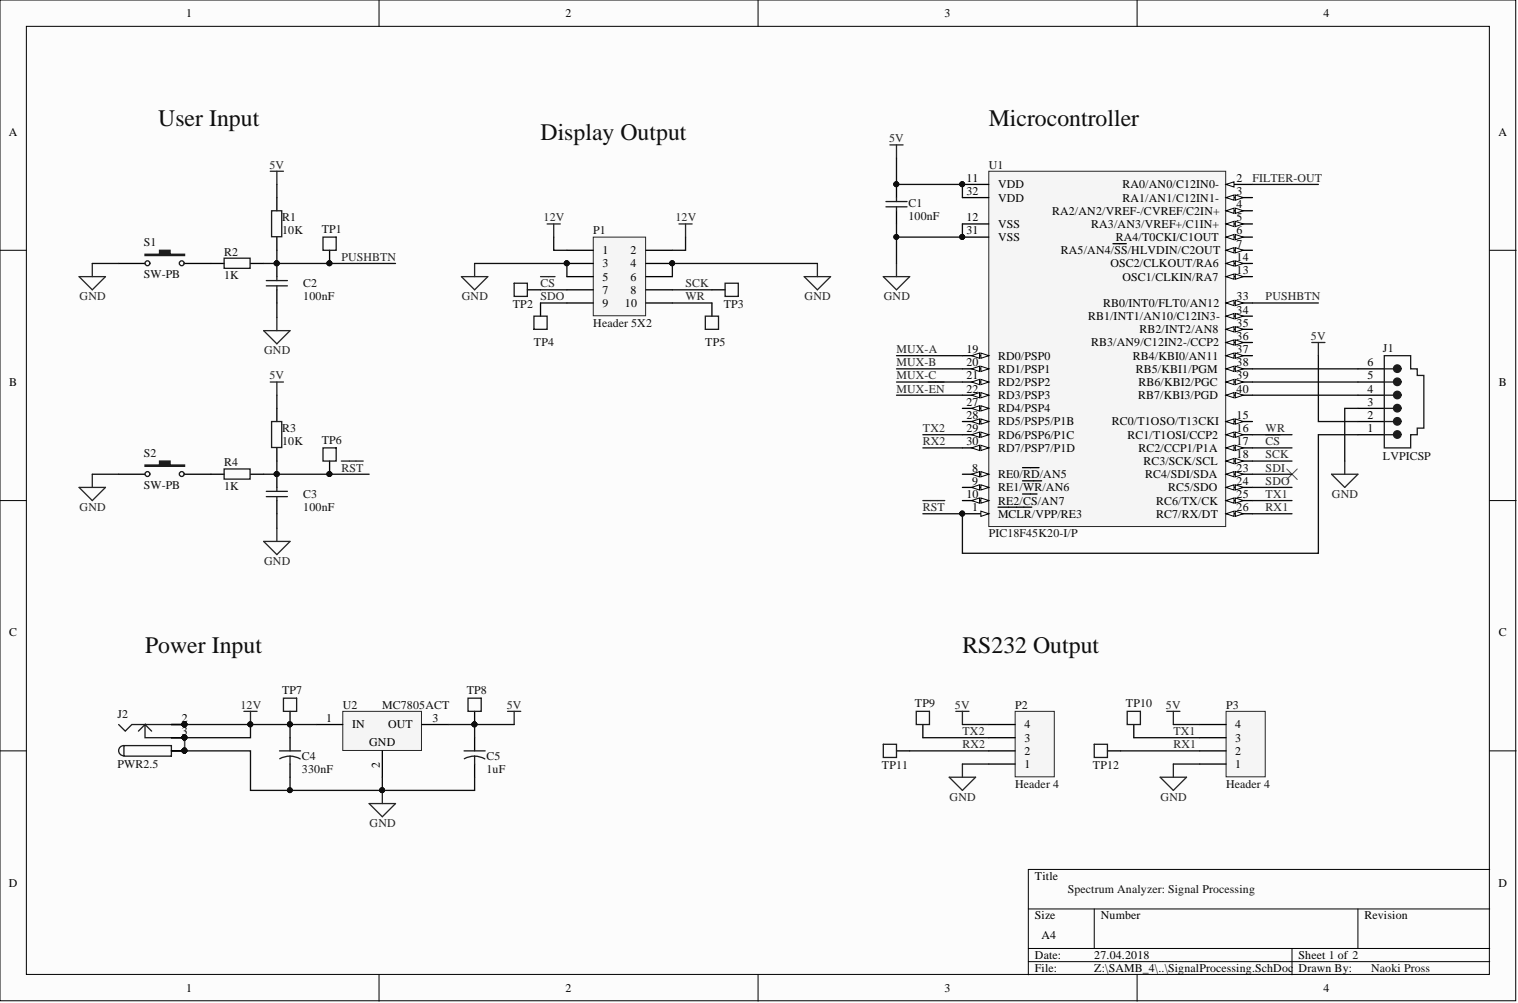
[picture p55: page 1]

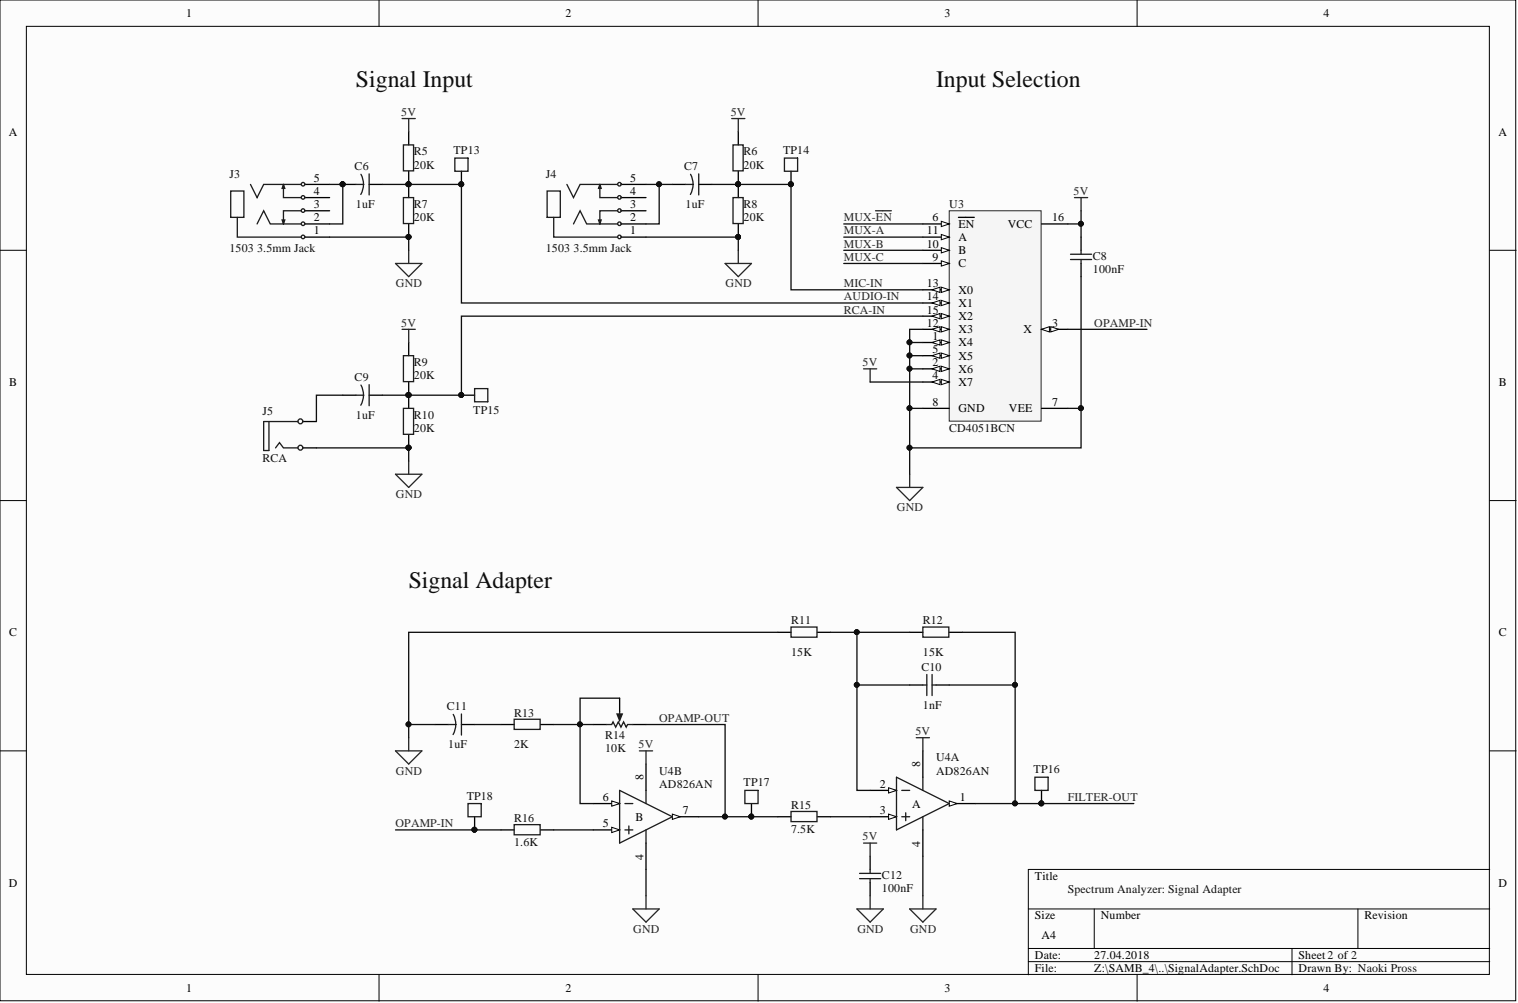
[picture p56: page 2]

Title
Spectrum Analyzer: Signal Adapter
