NaoPross/SAMSpectrumAnalyzer/doc/figures/circuits/filter-ampl-v1.pdf

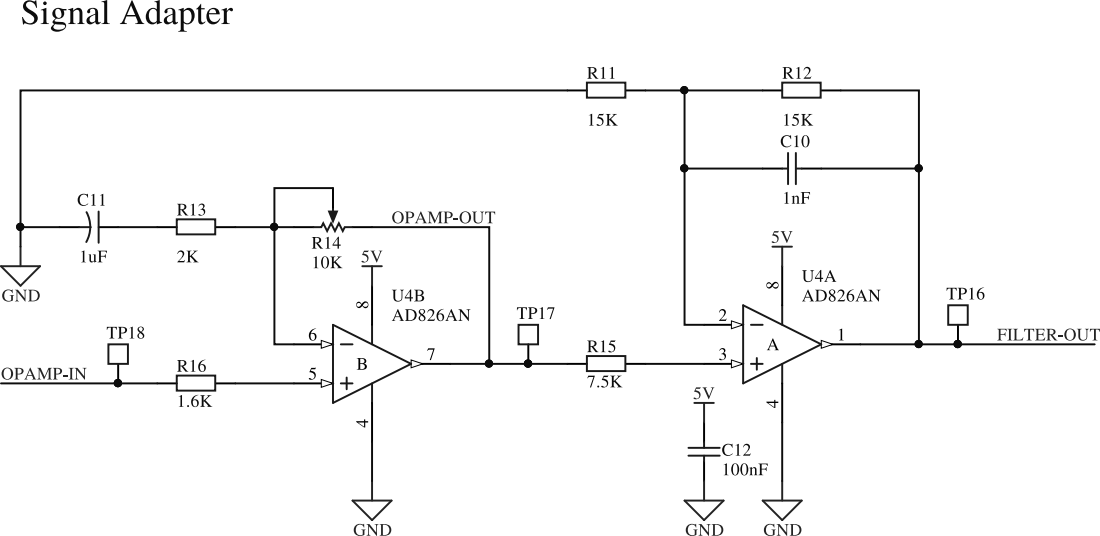
[picture p57: page 1]
