NaoPross/SAMSpectrumAnalyzer/doc/figures/circuits/input-selection-v1.pdf

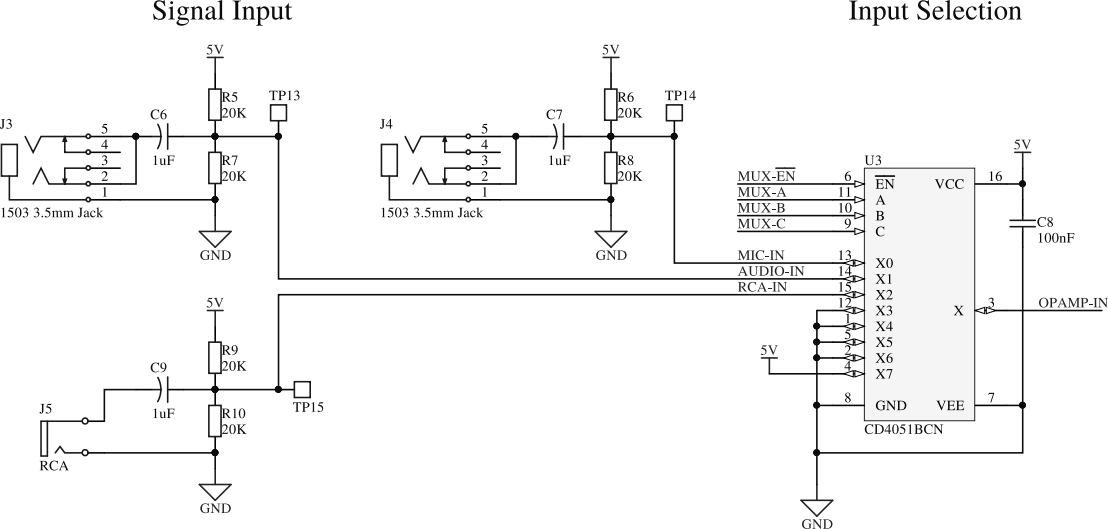
[picture p58: page 1]
