NaoPross/SAMSpectrumAnalyzer/(list of files, drawings)

Other design files:
hw/Lumberg-Connectors.PcbLib
hw/Lumberg-Connectors.SchLib
hw/PushButtons.PcbLib
hw/SignalAdapter.SchDoc
hw/SignalProcessing.SchDoc
hw/SpectrumAnalyer.PrjPcb
hw/SpectrumAnalyer.SchLib
hw/SpectrumAnalyzer.PcbDoc
hw/TestPad.SchLib
