NaoPross/SAMSpectrumAnalyzer/src/main.c

/*
 * File:    main.c
 * Author:  Naoki Pross
 * Project: SAM Spectrum Analyzer
 * 
 * Created on 12.04.2018, 11:57
 */

#define DEBUG

#include "hwconfig.h"
#include "rs232.h"
#include "ht1632.h"

#include "fft.h"

#include <xc.h>
#include <stdio.h>
#include <stdbool.h>
#include <stdint.h>
#include <string.h>


// number of samples to collect
#define SAMPLES_SIZE_POW    7
#define SAMPLES_SIZE        (1<<SAMPLES_SIZE_POW)



volatile uint8_t samples_count;
volatile bool start_sample;
volatile uint8_t mux_channel = 0;


interrupt void isr(void)
{
    if (INTCONbits.PEIE && PIR1bits.TMR2IF && samples_count < SAMPLES_SIZE) {        
        // start sampling
        start_sample = true;
        
        // reset interrupt flag
        PIR1bits.TMR2IF = 0;
    }
    
    if (INTCONbits.INT0IE && INTCONbits.INT0IF) {
        mux_channel = (mux_channel < 3) ? mux_channel +1 : 0;
        
        PORTD &= ~(0x07);
        PORTD |= mux_channel & 0x07;

        
        INTCONbits.INT0IF = 0;
    }
}


/* hardware initialization routine */
inline void init_hw()
{
    // disable interrupts
    di();
            
    /* PLL / FOSC configuration */
    // enable PLL
    OSCTUNEbits.PLLEN = 1;
    // set FOSC to HFINTOSC (max frequency)
    OSCTUNEbits.TUN = 0b011111;
    // set 16 MHz oscillator, datasheet p.30
    OSCCONbits.IRCF = 0b111;
    // select primary clock (with PLL)
    OSCCONbits.SCS = 0b00;
    
    /* initialize digital i/o */
    // signal input
    TRISAbits.RA0 = 1;
    ANSELAbits.ANSA0 = 1;
    
    // input selection button
    TRISBbits.TRISB0 = 1;
    ANSELBbits.ANSB0 = 0;
    // interrupt on PB0
    INTCONbits.RBIE = 1;
    INTCONbits.RBIF = 0;
    // interrupt on falling edge
    INTCON2bits.INTEDG0 = 0;
    
    INTCONbits.INT0IE = 1;
    INTCONbits.INT0IF = 0;

    // eusart and mssp port
    ANSELC = 0x00;
    TRISC = 0x00;
    
    // mux selection port
    TRISD = 0x00; // 0xF8;
    ANSELD = 0x00; // 0xF8;

    /* intialize ADC i/o */
    // set ADC clock period to Fosc/64 = 1us
    // (maximum without violating Tadmin)
    ADCON2bits.ADCS = 0b110;
    // set ADC acquisition time to 2*Tad)
    ADCON2bits.ACQT = 0b001;
    // set result format 2 bits on ADREDH and 8 bits on ADRESL
    ADCON2bits.ADFM = 1;
    // set internal reference
    ADCON1bits.PVCFG = 0b00;
    // set internal negative reference
    ADCON1bits.NVCFG = 0b00;
    // select channel 0 (AN0)
    ADCON0bits.CHS = 0b00000;
    // enable ADC
    ADCON0bits.ADON = 1;
    
    /* interrupts initialization */
    // timer 2 comp value
    // with post 1:1 and pre 1:16, 1 unit is 1 us
    PR2 = 49;
    // postscaler 1:1
    T2CONbits.T2OUTPS = 0b0000;
    // prescaler 1:16
    T2CONbits.T2CKPS = 0b11;
    // start timer
    T2CONbits.TMR2ON = 1;
    // timer 2 interrupts
    PIE1bits.TMR2IE = 1;
    PIR1bits.TMR2IF = 0;
    // enable peripheral interrupts
    INTCONbits.PEIE = 1;
    
    /* initialize serial devices */
    eusart1_init();
    eusart2_init();
    
    // enable global interrupts 
    ei();
}


void main(void)
{
    unsigned int i;
    
    short real[SAMPLES_SIZE];
    short imag[SAMPLES_SIZE];
    
    // set samples to zero
    memset(real, 0u, SAMPLES_SIZE * sizeof(real[0]));
    memset(imag, 0u, SAMPLES_SIZE * sizeof(imag[0]));


    // initialize hardware
    init_hw();
    PORTB = 0x00;
    PORTD = 0x00;
    
    ht1632_begin_cs();
    
    while (true) {
        // reset samples count
        samples_count = 0;
        start_sample = false;

#ifdef DEBUG
        PORTDbits.RD4 = 0;
#endif

        // sample signal
        PIE1bits.TMR2IE = 1;
        while (samples_count < SAMPLES_SIZE){
            while (!start_sample);

            ADCON0bits.GO = 1;   
            while (ADCON0bits.nDONE);

            real[samples_count] = ADRESH<<8 | ADRESL;
            
            samples_count++;
            start_sample = false;
        }
        PIE1bits.TMR2IE = 0;
        
#ifdef DEBUG
        PORTDbits.RD4 = 1;
#endif
        // compute FFT
        fix_fft(real, imag, SAMPLES_SIZE_POW);

        // send data
        printf("S\n\r");
        for (i = 0; i < SAMPLES_SIZE; i++) {
            printf("%04di%04d\n\r", real[i], imag[i]);

        }
        printf("E\n\r");
        
        // display data
        ht1632_set_pixel(1,1,0);
        ht1632_render();

#ifdef DEBUG        
        // wait
        // __delay_ms(500);
#endif
    }
    
    return;
}
