NaoPross/SAMSpectrumAnalyzer/(commit log)

2018-03-27 Add arduino serial test code
2018-04-12 Add reference material from E. Cima
2018-04-12 Add planning
    [Pianificazione.xlsx]
2018-04-12 Add documentation structure
    [Pianificazione.xlsx]
2018-04-12 Add LED matrix library from Randjelovic's LPI
2018-04-13 Add BOM
    [BOM.xlsx]
2018-04-13 Add first schematic implementation, update gitignore
    This version does not compile and is missing the power input circuit.
    [SpectrumAnalyer.PrjPcb, SpectrumAnalyzer.SchDoc, TestPad.SchLib]
2018-04-13 Add LED Matrix and PIC datasheets
2018-04-13 Update BOM
    [BOM.xlsx]
2018-04-13 Update journal
    [Pianificazione.xlsx]
2018-04-14 Fix missing QMutex to safely check _running, fix minor ui bug
    Minor bug: the serial open button changed its text to "closed"
    regardless of whether the serial device was actually opened or not.
    [mainwindow.cpp, serialworker.cpp, serialworker.h]
2018-04-16 Update signal processing circuit design
    [SpectrumAnalyer.PrjPcb, SpectrumAnalyzer.SchDoc]
2018-04-16 Update journal and BOM
    [BOM.xlsx, Pianificazione.xlsx]
2018-04-16 Update uC code to set up a timer interrupt and the ADC
2018-04-16 Fix comments in headers
    [hwconfig.h, rs232.h]
2018-04-16 Extract LED matrix LPI doc from archive
2018-04-16 Add power regulation circuit, more test points
    Minor change: replace harness with bus
    [SpectrumAnalyer.PrjPcb, SpectrumAnalyzer.SchDoc]
2018-04-17 Fix improper SerialWorker QMutex code
    Note:
    The application still crashes when the serial device is closed.
    [mainwindow.cpp, mainwindow.h, serialworker.cpp, serialworker.h]
2018-04-17 Split schematic into 2 pages, fix all footprints
    [Lumberg-Connectors.PcbLib, Lumberg-Connectors.SchLib, SignalAdapter.SchDoc, SignalProcessing.SchDoc, SpectrumAnalyer.PrjPcb, SpectrumAnalyzer.SchDoc]
2018-04-26 Add manual reset button and minor schematic fixes, start PCB design
    [PushButtons.PcbLib, SignalAdapter.SchDoc, SignalProcessing.SchDoc, SpectrumAnalyer.PrjPcb, SpectrumAnalyer.SchLib, SpectrumAnalyzer.PcbDoc]
2018-04-26 Fix desktop bug: unsafe serial thread crash
    [mainwindow.cpp, serialworker.cpp]
2018-04-26 Minor unsaved changes
    [Lumberg-Connectors.PcbLib, SpectrumAnalyzer.PcbDoc]
2018-04-26 Add seconday axis, fix crash when disconnecting serial cable
    [mainwindow.cpp, serialworker.cpp]
2018-04-27 Traced all PCB routes
    [Lumberg-Connectors.PcbLib, SignalAdapter.SchDoc, SignalProcessing.SchDoc, SpectrumAnalyer.PrjPcb, SpectrumAnalyzer.PcbDoc]
2018-04-27 Resolve all PCB rule violations
    [Lumberg-Connectors.PcbLib, SignalAdapter.SchDoc, SpectrumAnalyzer.PcbDoc]
2018-04-27 Add PCB pint, flip top and bottom layer
    Found hw bug: footprints for J3 and J4 are flipped
    [SpectrumAnalyzer.PcbDoc]
2018-04-27 Fix J3, J4 footprints and update PCB design
    [Lumberg-Connectors.PcbLib, SpectrumAnalyzer.PcbDoc]
2018-04-27 Update hardware project (altium) files
    [SpectrumAnalyer.PrjPcb, SpectrumAnalyzer.PcbDoc]
2018-04-27 Fix desktop crash bug on windows and remove log axis from plot
    [mainwindow.cpp, serialworker.cpp]
2018-04-30 Update C++ impl of sdt proto, update serial device code
2018-04-30 Reverted back to non binary data transfer protocol
    [mainwindow.cpp, mainwindow.h, serialworker.cpp, serialworker.h]
2018-04-30 Update RCA connector footprint and PCB
    [Lumberg-Connectors.PcbLib, SpectrumAnalyer.PrjPcb, SpectrumAnalyzer.PcbDoc]
2018-04-30 Update baudrate and switch to std::complex instead of sam::complex_int16_t
2018-05-03 Update hw traces clearance
    [SpectrumAnalyzer.PcbDoc]
2018-05-13 Update doc, add flowchart and acknowledgements
2018-05-14 Fix hw filter design (update PCB)
    [SignalAdapter.SchDoc, SignalProcessing.SchDoc, SpectrumAnalyer.PrjPcb]
2018-05-14 Update journal and doc
    [Pianificazione.xlsx]
2018-05-14 Add screenshots and data for doc
    [fft-quare-wave-lf.csv, fft-sine-wave.csv, fft-square-wave.csv]
2018-05-14 Fix CSV export header (desktop)
    [mainwindow.cpp]
2018-05-14 Update post-filter amplifier resistors
    [SignalAdapter.SchDoc, SpectrumAnalyer.PrjPcb]
2018-05-14 Update doc
    [fft-square-wave-lf.csv]
2018-05-14 Fix log axis lower bound (desktop)
    [mainwindow.cpp]
2018-05-15 Update plan and journal
    [Pianificazione.xlsx]
2018-05-25 Add openSerialDevice and closeSerialDevice slots to MainWindow
2018-05-28 Fix uC samplig rate to be 20 kHz, add HT1632 datasheet
    [main.c]
